FranciscoRos/SolucionesEnergeticasParaWSN/Sistema de control energético.docx

Sistema de control energético

Este proyecto permite monitorear y controlar remotamente parámetros eléctricos como voltaje y corriente mediante una red inalámbrica usando módulos XBee. Un nodo esclavo (Arduino UNO) mide el voltaje con un sensor ZMPT101B y la corriente con un sensor ACS712, y envía estos datos cada 3 segundos a un nodo coordinador (ESP32). El coordinador recibe la información, la analiza y, si los valores están fuea de un rango seguro, envía de vuelta un comando para apagar el sistema mediante un relevador; si todo está bien, lo mantiene encendido. Este proyecto tiene la finalidad de emular el proyecto de Pacheco Zamora (2017) para aumentar la eficiencia energética de este proyecto a futuro

Componentes

Nodo sensor:

Función: Medición de voltaje y corriente, y control del relevador con base en comandos recibidos por XBee.

Componente | Cantidad | Descripción
Arduino nano | 1 | Microcontrolador principal del nodo esclavo
Módulo XBee S2 | 1 | Comunicación inalámbrica con el coordinador
Adaptador XBee a Serial | 1 | Facilita conexión del XBee al Arduino
Sensor de Voltaje ZMPT101B | 1 | Mide el voltaje de AC, conectado a pin A1
Sensor de Corriente ACS712 (30A) | 1 | Mide la corriente, conectado a pin A0
Relevador de 5V | 1 | Controla el encendido/apagado de una carga
Fuente de alimentación 5V/3V | 1 | Alimenta todos los componentes
Cables Dupont | Varios | Para las conexiones
Protoboard | 1 | Para armar el circuito de forma provisional

Nodo Coordinador (ESP32-WROOM-32)

Función: Recibir datos, tomar decisiones y enviar comandos ON/OFF al esclavo.

Componente | Cantidad | Descripción
ESP32-WROOM-32 | 1 | Microcontrolador que evalúa y toma decisiones (ESP DEV MODULE en Arduino IDE)
Módulo XBee | 1 | Para recibir los datos del esclavo
Adaptador XBee a Serial | 1 | Facilita la conexión del XBee al ESP32
Fuente USB (5V/3V) | 1 | Para alimentar al ESP32
Cables Dupont | Varios | Para las conexiones UART (TX/RX) y GND
Protoboard | 1 | Para facilitar conexiones

Conexiones:

Nodo Coordinador:

Pin lado A | Pin lado B | Notas
Adaptador Xbee TX 2(DOUT) | ESP32-WROOM-32 GPIO16 (RX2) | Entrada de datos al ESP32
Adaptador Xbee RX 3 (DIN) | ESP32-WROOM-32 GPIO17 (TX2) | Salida de órdenes desde el ESP32
Adaptador Xbee VCC | Fuente de alimentación 5V | El adaptador aguanta 5v
Adaptador Xbee VCC | GND de Fuente

Nodo Router:

Pin lado A | Pin lado B | Notas
Adaptador Xbee TX (DOUT) | Arduino Nano Pin D2
Adaptador Xbee RX (DIN) | Arduino Nano Pin D3
Adaptador Xbee VCC | Fuente de alimentación 5V
Adaptador Xbee GND | GND de Fuente
ACS712 OUT | Arduino nano Pin A0
ACS712 VCC | Fuente de alimentación 5V
ACS712 GND | GND de Fuente
ZMPT101B OUT | Arduino Nano Pin A1
ZMPT101B VCC | Fuente de alimentación 5V
ZMPT101B GND | GND de Fuente
Relay IN | Arduino Nano Pin D4
Relay VCC | Fuente de alimentación 5V
Relay GND | GND de Fuente

Pruebas de dispositivos físicos:

Nodo Coordinador

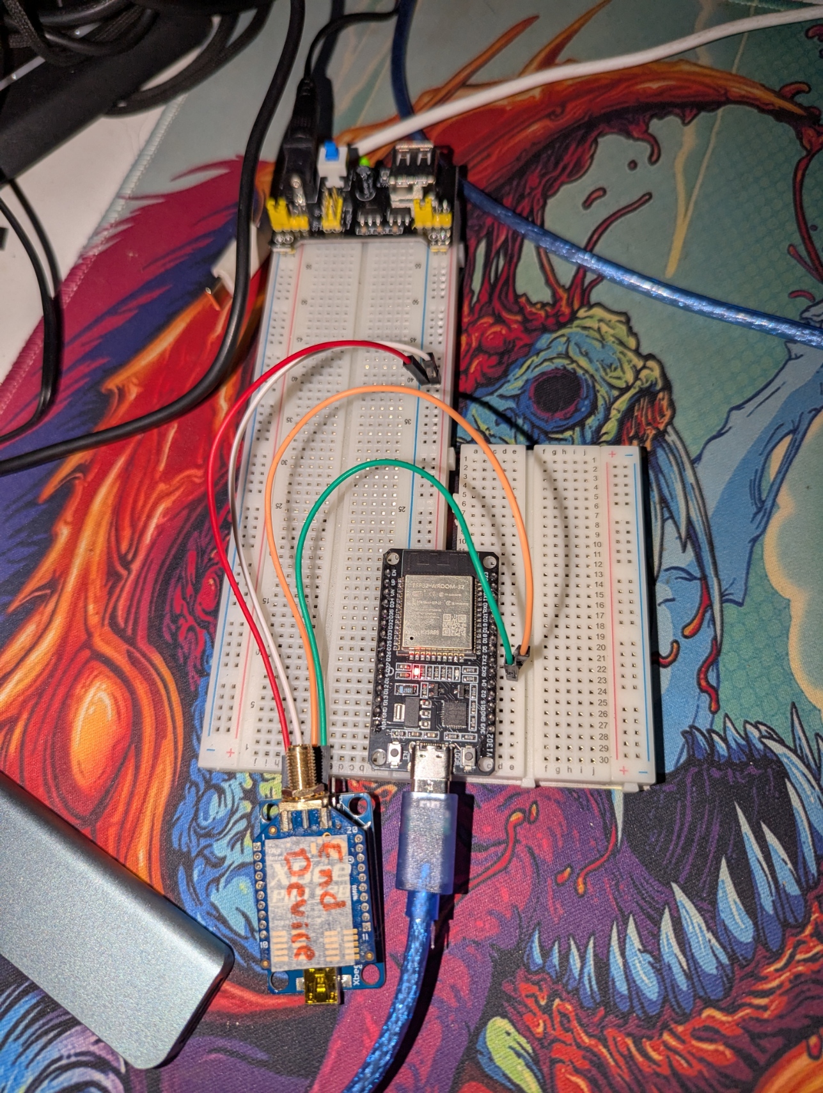
[picture p1: figure]

Nodo Esclavo:

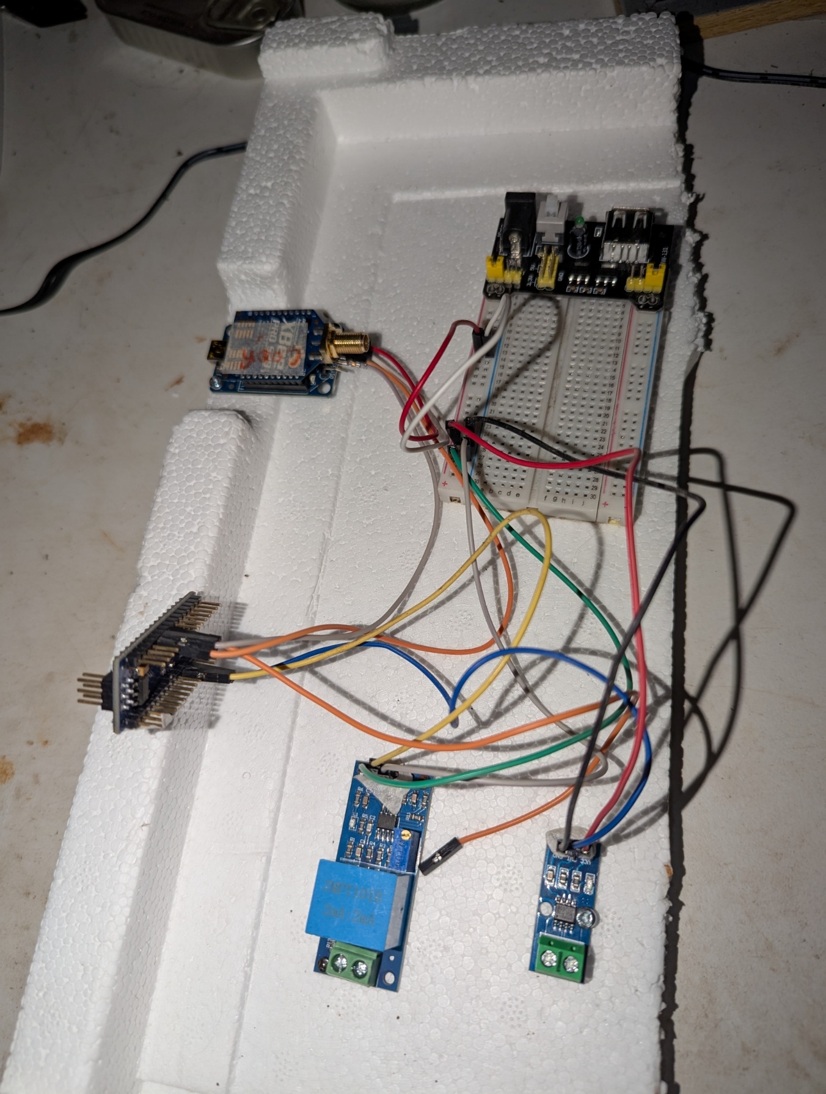
[picture p2: figure]

Código del nodo Coordinador:

// Pines UART2 para ESP32

#define RXD2 16 // Conectado al TX del XBee

#define TXD2 17 // Conectado al RX del XBee

float voltaje = 0.0;

float corriente = 0.0;

void setup() {

Serial.begin(115200); // Comunicación con PC

Serial2.begin(9600, SERIAL_8N1, RXD2, TXD2); // UART2 para XBee

Serial.println("Nodo Coordinador ESP32 iniciado");

}

void loop() {

if (Serial2.available()) {

String data = Serial2.readStringUntil('\n');

data.trim(); // Limpia espacios y saltos

// Validar que sea un paquete válido tipo: V:xx.xx I:yy.yy

if (data.indexOf('V') != -1 && data.indexOf('I') != -1) {

Serial.println("📡 Datos recibidos: " + data);

int idxV = data.indexOf('V');

int idxI = data.indexOf('I');

float v = data.substring(idxV + 2, idxI - 1).toFloat();

float i = data.substring(idxI + 2).toFloat();

voltaje = v;

corriente = i;

Serial.print("🔋 Voltaje: "); Serial.println(voltaje);

Serial.print("⚡ Corriente: "); Serial.println(corriente);

// Lógica de decisión

if (voltaje < 190 || voltaje > 250 || corriente < 0.1) {

Serial2.println("OFF");

Serial.println(">> 📴 Enviando comando: OFF");

} else {

Serial2.println("ON");

Serial.println(">> ✅ Enviando comando: ON");

}

} else {

// Si no es un dato con formato válido, lo ignoramos

}

}

delay(1000); // Espera para evitar saturar la UART

}

Código del nodo Sensor:

#include <SoftwareSerial.h>

SoftwareSerial xbeeSerial(2, 3); // RX, TX para XBee

#define RELAY_PIN 4

#define ACS_PIN A0

#define ZMPT_PIN A1

unsigned long previousMillis = 0;

const long interval = 3000; // cada 3 segundos

void setup() {

pinMode(RELAY_PIN, OUTPUT);

digitalWrite(RELAY_PIN, LOW); // Relevador apagado inicialmente

xbeeSerial.begin(9600);

Serial.begin(9600);

Serial.println("Nodo esclavo listo");

}

void loop() {

unsigned long currentMillis = millis();

if (currentMillis - previousMillis >= interval) {

previousMillis = currentMillis;

float voltage = leerVoltajeZMPT();

float corriente = leerCorrienteACS();

// Envío por XBee

xbeeSerial.print("V:"); xbeeSerial.print(voltage, 2);

xbeeSerial.print(" I:"); xbeeSerial.println(corriente, 2);

Serial.print("📤 Enviado -> V: "); Serial.print(voltage, 2);

Serial.print(" | I: "); Serial.println(corriente, 2);

}

// Escuchar comandos del coordinador

if (xbeeSerial.available()) {

String comando = xbeeSerial.readStringUntil('\n');

comando.trim(); // Elimina espacios

Serial.print("📥 Comando recibido: "); Serial.println(comando);

if (comando == "ON") {

digitalWrite(RELAY_PIN, HIGH);

Serial.println("⚡ Relevador ENCENDIDO");

} else if (comando == "OFF") {

digitalWrite(RELAY_PIN, LOW);

Serial.println("💤 Relevador APAGADO");

} else {

Serial.print("🟡 Comando desconocido: "); Serial.println(comando);

}

}

}

// Lectura simple del ZMPT101B

float leerVoltajeZMPT() {

int lectura = analogRead(ZMPT_PIN);

float voltaje = (lectura * 5.0) / 1023.0;

return voltaje * 50.0; // Aproximación para escalar a voltaje real

}

// Lectura simple del ACS712

float leerCorrienteACS() {

int lectura = analogRead(ACS_PIN);

float voltaje = (lectura * 5.0) / 1023.0;

float corriente = (voltaje - 2.5) / 0.066; // Para ACS712 30A

return corriente;

}

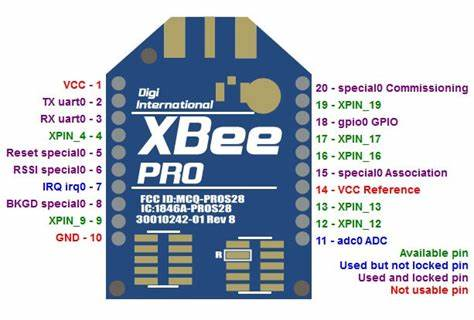
[picture p3: figure]
Xbee Pinout

# CONSUMO ENERGÉTICO ESTIMADO – NODOS

1) PARÁMETROS ELÉCTRICOS USADOS

NODO COORDINADOR

• ESP32-WROOM-32…………… 3.3 V · 20 mA (modo “modem-sleep”) ─→ 0.066 W :contentReference[oaicite:0]{index=0}

• XBee S2 (idle)……………… 3.3 V · 40 mA ─→ 0.132 W :contentReference[oaicite:1]{index=1}

• Adaptador XBee→Serie

– reposo………………… 5 V · 8 mA ─→ 0.040 W :contentReference[oaicite:2]{index=2}

– activo TX…………… 5 V · 10 mA (Δ = +2 mA) ─→ +0.010 W

• Duración paquete TX……… 16 ms cada 3 s → ciclo = 0.005333

NODO SENSOR ( 1 relé de 5 V )

• Arduino Nano (idle)……… 5 V · 20 mA ─→ 0.100 W :contentReference[oaicite:3]{index=3}

• XBee S2 (idle)……………… 3.3 V · 40 mA ─→ 0.132 W :contentReference[oaicite:4]{index=4}

• Adaptador XBee reposo…… 5 V · 8 mA ─→ 0.040 W :contentReference[oaicite:5]{index=5}

• ZMPT101B……………………… 5 V · 2 mA ─→ 0.010 W :contentReference[oaicite:6]{index=6}

• ACS712 (mód.)……………… 5 V · 7 mA ─→ 0.035 W :contentReference[oaicite:7]{index=7}

• Relé 5 V

– bobina OFF………… 5 V · 2 mA ─→ 0.010 W

– bobina ON…………… 5 V · 70 mA (Δ = +68 mA) ─→ +0.340 W :contentReference[oaicite:8]{index=8}

• LM7805 (quiescente)……… 5 V · 8 mA ─→ 0.040 W :contentReference[oaicite:9]{index=9}

• Duración paquete TX……… 16 ms cada 3 s → ciclo = 0.005333

────────────────────────────────────────

2) POTENCIA PROMEDIO CALCULADA

────────────────────────────────────────

NODO COORDINADOR

P_idle = 0.066 W + 0.132 W + 0.040 W = **0.238 W**

P_extra = 0.010 W × 0.005333 = **0.000053 W**

P_avg = 0.238 W + 0.000053 W = **0.238 W**

NODO SENSOR (supuesto: relé ON 100 %)

P_idle = 0.100 W + 0.132 W + 0.040 W + 0.010 W + 0.035 W + 0.010 W + 0.040 W

= **0.707 W**

P_extra = (Δ Arduino 0.150 W + Δ Adaptador 0.010 W) × 0.005333

= **0.001 W**

P_avg = 0.707 W + 0.001 W = **0.708 W**

────────────────────────────────────────

3) ENERGÍA POR DÍA (24 h)

────────────────────────────────────────

E_coord = 0.238 W × 24 h = 5.71 Wh/día

E_sensor = 0.708 W × 24 h = 16.99 Wh/día

4) RESUMEN RÁPIDO

• Nodo coordinador ≈ 5.7 Wh cada 24 h

• Nodo sensor (relé siempre activo) ≈ 17 Wh cada 24 h

Si el relé estuviera activo sólo el 30 % del tiempo:

P_avg_sensor ≈ 0.470 W → 11.28 Wh/día

5) FÓRMULAS USADAS

Potencia: P = V × I

Energía modo_i: E_i = P_i × t_i

Energía total nodo: Σ E_i sobre todos los modos

Duty-cycle TX: d = t_paq / T_envío

A continuación listamos los resultados de diversas mediciones energéticas a lo largo del tiempo

Caso 1: nodo coordinador alimentado por Baterías: 4×18650 (2200 mAh, 14.8 V)

Análisis de autonomía energética

Con baterías hasta vaciar:

Conteo | Paquetes esperados | Paquetes recibidos | % Recepción | Duración nodo
1 | 9300 | 9179 | 98.70 % | 07:45:00
2 | 9260 | 9185 | 99.19 % | 07:43:00
3 | 9280 | 9122 | 98.30 % | 07:44:00
4 | 9240 | 9138 | 98.90 % | 07:42:00
5 | 9320 | 9226 | 98.99 % | 07:46:00
Promedio | 9280 | 9169 | 98.82 % | 07:44:00

Con baterías hasta voltaje seguro (80% de carga útil):

Conteo | Paquetes esperados | Paquetes recibidos | % Recepción | Duración nodo
1 | 11000 | 10571 | 96.10 % | 09:10:00
2 | 10900 | 10431 | 95.70 % | 09:05:00
3 | 10960 | 10576 | 96.50 % | 09:08:00
4 | 10860 | 10414 | 95.89 % | 09:03:00
5 | 10940 | 10535 | 96.30 % | 09:07:00
Promedio | 10932 | 10505 | 96.10 % | 09:06:36

### Notas

- Las pruebas se realizaron en ambiente cálido (34 °C) y con distancia mínima entre módulos XBee
- Los módulos trabajaron en modo API2 a 9600 bps.
- En los casos donde se vaciaron las baterías, el sistema presentó pérdida de paquetes o reinicios al descender por debajo de los 4.4 V
- Se utilizó el mismo set de baterías para cada serie de pruebas, solo se recargaron, pero debido a que eran nuevas no es una diferencia palpable el desgaste entre cargas

Caso 3.

Modificación de códigos para escritura de archivos log:

Código del nodo sensor: #include <SPI.h>

#include <SD.h>

#include <SoftwareSerial.h>

SoftwareSerial xbeeSerial(2, 3); // RX=D2, TX=D3 para XBee

// Pines ya definidos

#define RELAY_PIN 4

#define ACS_PIN A0

#define ZMPT_PIN A1

#define VBAT_PIN A2

const uint8_t SD_CS = 10;

// Variables

unsigned long previousMillis = 0;

const unsigned long INTERVAL_MS = 3000;

unsigned long lastFlush = 0;

const unsigned long FLUSH_MS = 30000;

uint32_t paquetesEnviados = 0;

File logFile;

// Setup

void setup() {

pinMode(RELAY_PIN, OUTPUT);

digitalWrite(RELAY_PIN, LOW);

Serial.begin(9600);

xbeeSerial.begin(9600);

if (!SD.begin(SD_CS)) {

Serial.println("SD no inicializada");

} else {

logFile = SD.open("/llog.txt", FILE_WRITE);

if (logFile) logFile.println("fecha_hora,id_paquete,voltaje_red,corriente,voltaje_bateria");

logFile.flush();

}

}

// Loop

void loop() {

unsigned long currentMillis = millis();

if (currentMillis - previousMillis >= INTERVAL_MS) {

previousMillis = currentMillis;

float voltage = leerVoltajeZMPT();

float corriente = leerCorrienteACS();

float vbat = leerVoltajeBateria();

paquetesEnviados++;

// Línea CSV

String fecha_hora = obtenerFechaHora();

String linea = fecha_hora + "," + String(paquetesEnviados) + "," +

String(voltage, 2) + "," + String(corriente, 2) + "," +

String(vbat, 2);

// Envío por XBee

xbeeSerial.print("N:"); xbeeSerial.print(paquetesEnviados);

xbeeSerial.print(" V:"); xbeeSerial.print(voltage, 2);

xbeeSerial.print(" I:"); xbeeSerial.print(corriente, 2);

xbeeSerial.print(" B:"); xbeeSerial.println(vbat, 2);

// Serial y SD

Serial.println(linea);

if (logFile) logFile.println(linea);

}

// Comandos recibidos

if (xbeeSerial.available()) {

String comando = xbeeSerial.readStringUntil('\n');

comando.trim();

if (comando == "ON") digitalWrite(RELAY_PIN, HIGH);

else if (comando == "OFF") digitalWrite(RELAY_PIN, LOW);

}

if (logFile && millis() - lastFlush >= FLUSH_MS) {

logFile.flush();

lastFlush = millis();

}

}

// Funciones sensores existentes

float leerVoltajeZMPT() {

int lectura = analogRead(ZMPT_PIN);

return ((lectura * 5.0) / 1023.0) * 50.0;

}

float leerCorrienteACS() {

int lectura = analogRead(ACS_PIN);

float volt = (lectura * 5.0) / 1023.0;

return (volt - 2.5) / 0.066;

}

float leerVoltajeBateria() {

int lectura = analogRead(VBAT_PIN);

float vEsc = (lectura * 5.0) / 1023.0;

return vEsc * 3.0;

}

// Fecha/hora calculada desde millis

String obtenerFechaHora() {

unsigned long segundos = millis() / 1000;

int hh = 12 + (segundos / 3600) % 12;

int mm = (segundos / 60) % 60;

int ss = segundos % 60;

char buf[20];

sprintf(buf, "2025-06-05 %02d:%02d:%02d", hh, mm, ss);

return String(buf);

}

Pines actualizados del nodo sensor:

Pin del Arduino Nano | Dispositivo conectado | Función
D2 | XBee (DOUT) | RX (SoftwareSerial)
D3 | XBee (DIN) | TX (SoftwareSerial)
D4 | Relé | Control (ON/OFF)
D10 | Módulo micro-SD (CS) | Chip Select SPI
D11 (MOSI) | Módulo micro-SD (DI) | SPI MOSI
D12 (MISO) | Módulo micro-SD (DO) | SPI MISO
D13 (SCK) | Módulo micro-SD (SCK) | SPI Clock
A0 | ACS712 (sensor corriente) | Lectura corriente analógica
A1 | ZMPT101B (sensor voltaje) | Lectura voltaje analógico
A2 | Batería (divisor resistivo) | Lectura voltaje de batería
5V | Fuente alimentación | Alimentación módulos (XBee, sensores, relé, SD)
GND | Fuente común | Tierra común módulos

Código actualizado del Nodo Coordinador:

#include <SPI.h>

#include <SD.h>

// UART para XBee

#define RXD2 16

#define TXD2 17

const uint8_t SD_CS = 5;

// Pin ADC para batería

const uint8_t BAT_PIN = 34;

File logFile;

unsigned long lastFlush = 0;

const unsigned long FLUSH_MS = 30000;

uint32_t paquetesRecibidos = 0;

void setup() {

Serial.begin(115200);

Serial2.begin(9600, SERIAL_8N1, RXD2, TXD2);

if (!SD.begin(SD_CS)) {

Serial.println("SD no inicializada");

} else {

logFile = SD.open("/clog.txt", FILE_WRITE);

if (logFile) {

logFile.println("fecha_hora,id_paquete,id_nodo,RSSI,estado,voltaje_bateria");

logFile.flush();

}

}

}

void loop() {

if (Serial2.available()) {

String data = Serial2.readStringUntil('\n');

data.trim();

if (data.startsWith("N:")) {

paquetesRecibidos++;

int idStart = data.indexOf("N:") + 2;

int idEnd = data.indexOf(' ', idStart);

String id_paquete = data.substring(idStart, idEnd);

String fecha_hora = obtenerFechaHora();

int rssi = -1;

float voltaje_bateria = leerVoltajeBateria();

String linea = fecha_hora + "," + id_paquete + ",SENSOR1," +

String(rssi) + ",OK," + String(voltaje_bateria, 2);

Serial.println(linea);

if (logFile) logFile.println(linea);

Serial2.println("ON");

}

}

if (logFile && millis() - lastFlush >= FLUSH_MS) {

logFile.flush();

lastFlush = millis();

}

}

// Medición batería (ADC ESP32: 0 - 4095 → 0 - 3.3V)

float leerVoltajeBateria() {

int lecturaADC = analogRead(BAT_PIN);

float voltajeADC = (lecturaADC / 4095.0) * 3.3;

float voltajeBateria = voltajeADC * ((10000.0 + 5000.0) / 5000.0); // Divisor 10k-5k

return voltajeBateria;

}

String obtenerFechaHora() {

unsigned long segundos = millis() / 1000;

int hh = 12 + (segundos / 3600) % 12;

int mm = (segundos / 60) % 60;

int ss = segundos % 60;

char buf[20];

sprintf(buf, "2025-06-03 %02d:%02d:%02d", hh, mm, ss);

return String(buf);

}

Pines actualizados del nodo coordinador:

Pin ESP32 | Dispositivo conectado | Función
GPIO16 (RX2) | XBee (DOUT) | UART RX desde XBee
GPIO17 (TX2) | XBee (DIN) | UART TX hacia XBee
GPIO5 | Módulo micro-SD (CS) | Chip Select SPI SD
GPIO18 (SCK) | Módulo micro-SD (SCK) | SPI Clock
GPIO19 (MISO) | Módulo micro-SD (MISO) | SPI MISO
GPIO23 (MOSI) | Módulo micro-SD (MOSI) | SPI MOSI
GPIO34 | Divisor resistivo | Medición voltaje batería (ADC)
VIN (5V) | Fuente USB (5V) o batería | Alimentación ESP32 y módulos
GND | Fuente común | Tierra común

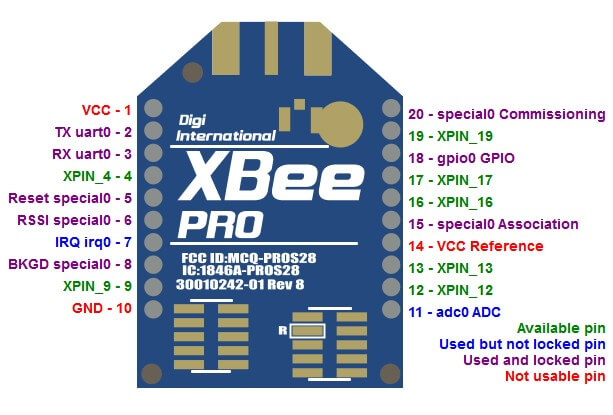
[picture p4: figure]
Xbee Pinout

Pruebas de código en MODO AT V.2

Código en Nodo Coordinador

#include <SPI.h>

#include <SD.h>

#define RXD2 16

#define TXD2 17

const uint8_t SD_CS = 5;

File logFile;

unsigned long lastFlush = 0;

const unsigned long FLUSH_MS = 30000;

uint32_t paquetesRecibidos = 0;

void setup() {

Serial.begin(115200);

Serial2.begin(9600, SERIAL_8N1, RXD2, TXD2);

if (!SD.begin(SD_CS)) {

Serial.println("SD no inicializada");

} else {

logFile = SD.open("/clog.csv", FILE_WRITE);

if (logFile) logFile.println("fecha_hora,id_paquete,id_nodo,voltaje,corriente,voltaje_bateria,estado");

logFile.flush();

}

}

void loop() {

if (Serial2.available()) {

String data = Serial2.readStringUntil('\n');

data.trim();

// Formato esperado: NombreNodo|N:id_paquete V:voltaje I:corriente B:bateria

int sep = data.indexOf('|');

String id_nodo = "UNKNOWN";

String resto = data;

if (sep > 0) {

id_nodo = data.substring(0, sep);

id_nodo.trim();

resto = data.substring(sep + 1);

}

int idStart = resto.indexOf("N:") + 2;

int idEnd = resto.indexOf(' ', idStart);

String id_paquete = resto.substring(idStart, idEnd);

int vStart = resto.indexOf("V:") + 2;

int vEnd = resto.indexOf(' ', vStart);

String voltaje = resto.substring(vStart, vEnd);

int iStart = resto.indexOf("I:") + 2;

int iEnd = resto.indexOf(' ', iStart);

String corriente = resto.substring(iStart, iEnd);

int bStart = resto.indexOf("B:") + 2;

String vbat = resto.substring(bStart);

String fecha_hora = obtenerFechaHora();

String linea = fecha_hora + "," + id_paquete + "," + id_nodo + "," +

voltaje + "," + corriente + "," + vbat + ",OK";

Serial.println(linea);

if (logFile) logFile.println(linea);

paquetesRecibidos++;

}

if (logFile && millis() - lastFlush >= FLUSH_MS) {

logFile.flush();

lastFlush = millis();

}

}

String obtenerFechaHora() {

unsigned long segundos = millis() / 1000;

int hh = 12 + (segundos / 3600) % 12;

int mm = (segundos / 60) % 60;

int ss = segundos % 60;

char buf[20];

sprintf(buf, "2025-06-03 %02d:%02d:%02d", hh, mm, ss);

return String(buf);

}

Código Nodo Esclavo:

#include <SPI.h>

#include <SD.h>

#include <SoftwareSerial.h>

SoftwareSerial xbeeSerial(2, 3);

#define RELAY_PIN 4

#define ACS_PIN A0

#define ZMPT_PIN A1

#define VBAT_PIN A2

const uint8_t SD_CS = 10;

unsigned long previousMillis = 0;

const unsigned long INTERVAL_MS = 3000;

File logFile;

uint32_t paquetesEnviados = 0;

void setup() {

pinMode(RELAY_PIN, OUTPUT);

digitalWrite(RELAY_PIN, LOW);

Serial.begin(9600);

xbeeSerial.begin(9600);

if (!SD.begin(SD_CS)) {

Serial.println("SD no inicializada");

} else {

logFile = SD.open("/llog1.csv", FILE_WRITE);

if (logFile) logFile.println("fecha_hora,id_paquete,voltaje,corriente,voltaje_bateria");

logFile.flush();

}

}

void loop() {

unsigned long currentMillis = millis();

if (currentMillis - previousMillis >= INTERVAL_MS) {

previousMillis = currentMillis;

paquetesEnviados++;

float voltage = leerVoltajeZMPT();

float corriente = leerCorrienteACS();

float vbat = leerVoltajeBateria();

String fecha_hora = obtenerFechaHora();

String linea = fecha_hora + "," + String(paquetesEnviados) + "," +

String(voltage, 2) + "," + String(corriente, 2) + "," +

String(vbat, 2);

// Enviar con delimitador '|'

xbeeSerial.print("Nodo1|");

xbeeSerial.print("N:"); xbeeSerial.print(paquetesEnviados);

xbeeSerial.print(" V:"); xbeeSerial.print(voltage, 2);

xbeeSerial.print(" I:"); xbeeSerial.print(corriente, 2);

xbeeSerial.print(" B:"); xbeeSerial.println(vbat, 2);

Serial.println(linea);

if (logFile) logFile.println(linea);

}

}

// Funciones sensores

float leerVoltajeZMPT() { return analogRead(ZMPT_PIN) * 5.0 / 1023.0 * 50.0; }

float leerCorrienteACS() { return ((analogRead(ACS_PIN) * 5.0 / 1023.0) - 2.5) / 0.066; }

float leerVoltajeBateria() { return analogRead(VBAT_PIN) * 5.0 / 1023.0 * 3.0; }

String obtenerFechaHora() {

unsigned long segundos = millis() / 1000;

int hh = 12 + (segundos / 3600) % 12;

int mm = (segundos / 60) % 60;

int ss = segundos % 60;

char buf[20];

sprintf(buf, "2025-06-03 %02d:%02d:%02d", hh, mm, ss);

return String(buf);

}

PARA EL USO DE LA LIBRERÍA DE EnergyWSN SE NECESITA ACTUALIZAR EL HARDWARE PARA IMPLEMENTAR:

MOSFET P PARA EL CANAL DE LA ALIMENTACIÓN DE LOS SENSORES

PINES PARA ENCENDIDO DEL XBEE Y ESTADO DEL XBEE

LA TABLA DE CONEXIONES QUEDA DE ESTA MANERA:

Pin Arduino Nano | Dispositivo conectado | Función | Notas
D2 | XBee DOUT | RX (SoftwareSerial) | 3.3 V → entra directo al Nano.
D3 | XBee DIN | TX (SoftwareSerial) | Requiere divisor resistivo/level shifter.
D4 | Relé | Control ON/OFF | Driver recomendado (transistor + diodo).
D7 | MOSFET control sens. | ON/OFF sensores | Controla P-MOSFET vía NPN.
D8 | XBee SLEEP_RQ | Orden de dormir/despertar | Usa divisor resistivo.
D9 | XBee ON/SLEEP | Bandera de estado (input) | 3.3 V, lectura directa.
D10 | Módulo micro-SD (CS) | SPI CS
D11 (MOSI) | Módulo micro-SD (DI) | SPI MOSI
D12 (MISO) | Módulo micro-SD (DO) | SPI MISO
D13 (SCK) | Módulo micro-SD (SCK) | SPI Clock
A0 | ACS712 | Lectura corriente analógica
A1 | ZMPT101B | Lectura voltaje analógico
A2 | Divisor resistivo | Lectura voltaje batería
5V | Fuente step-down | Alimentación módulos 5 V | Desde el step down
3.3V (LDO) | XBee | Alimentación 3.3 V | Desde adaptador 3.3 del stepdown
GND | Común | Tierra común

AGREGANDO EL MÓDULO RTC A LOS DIAGRAMAS DE CONEXIÓN.

Nodo Sensor

Pin del Arduino Nano | Dispositivo Conectado | Conexión de Alimentación
Batería (14.8V) | Step-Down de 5V y Step-Down de 3.3V | Ambos se conectan a los polos positivo (+) y negativo (-) de la batería.
Salida 5V Step-Down | Arduino Nano, Relé, Sensores, Módulo SD | Alimentación principal.
Salida 3.3V Step-Down | XBee | Alimentación dedicada para el XBee.
A4 (SDA) | RTC (D) | Comunicación de datos I2C.
A5 (SCL) | RTC (C) | Comunicación de reloj I2C.
VCC (5V) | RTC (+) | Alimentación para el RTC desde la salida de 5V del Step-Down.
GND | RTC (-) | Tierra común.
D2 | XBee (DOUT) | UART (RX)
D3 | XBee (DIN) | UART (TX)
D4 | Relé | Control (ON/OFF)
A0 | ACS712 (sensor corriente) | Lectura analógica
A1 | ZMPT101B (sensor voltaje) | Lectura analógica
A2 | Batería (divisor resistivo) | Lectura de voltaje

Nodo sensor

Metodología de Pruebas y Evaluación de Rendimiento de la Red de Nodos

Para la validación experimental y la cuantificación del rendimiento de la red de sensores implementada, se diseñó un protocolo de pruebas dividido en dos fases críticas. Cada fase se enfoca en una métrica fundamental para el desempeño y la viabilidad del sistema: la confiabilidad en la transmisión de datos y el consumo energético de los nodos. El objetivo de esta separación es permitir un análisis granular y preciso de cada aspecto funcional.

#### 1. Evaluación de la Confiabilidad y Tasa de Entrega de Paquetes (Packet Delivery Rate)

Esta primera fase del protocolo experimental se centró en determinar la integridad y robustez de la comunicación inalámbrica entre los nodos sensor y el nodo coordinador. El objetivo principal era cuantificar la Tasa de Pérdida de Paquetes (Packet Loss Rate, PLR) en un escenario de operación autónoma y prolongada, simulando así condiciones de despliegue reales.

Procedimiento Experimental:

El procedimiento se ejecutó de la siguiente manera:

1. Configuración Inicial: Se programaron y energizaron un nodo sensor y un nodo coordinador, ambos con sus baterías completamente cargadas. Los nodos se configuraron para operar de forma totalmente autónoma, sin intervención humana, transmitiendo datos a intervalos predefinidos.
2. Periodo de Operación Autónoma: Los nodos se dejaron en funcionamiento ininterrumpido durante un ciclo completo de descarga, es decir, hasta que la fuente de energía del nodo sensor se agotó por completo. Este método asegura que la prueba cubra todas las posibles variaciones en el rendimiento del hardware a medida que el voltaje de la batería disminuye, lo cual puede afectar la potencia de transmisión del módulo de radiofrecuencia.
3. Recolección de Datos: Una vez finalizado el ciclo de vida útil de la batería, ambos nodos fueron conectados a un ordenador a través de la interfaz serie. Se utilizó el monitor serial del Entorno de Desarrollo Integrado (IDE) de Arduino para extraer los registros de operación almacenados en la memoria o contadores internos de cada dispositivo.
  a. Del nodo sensor, se obtuvo el número total de paquetes de datos que fueron exitosamente generados y enviados (P_enviados).
  b. Del nodo coordinador, se recuperó el número total de paquetes que fueron recibidos y procesados correctamente (P_recibidos).
4. Análisis de Resultados: Con los datos recolectados, se procedió a calcular el número absoluto de paquetes perdidos durante la transmisión. Esta métrica representa la cantidad de información que no logró llegar a su destino debido a factores como interferencia, colisiones de señal, o limitaciones de alcance. El cálculo se realizó mediante una simple diferencia aritmética:

P_(perdidos) = P_(enviados) - P_(recibidos)

Posteriormente, para normalizar este valor y obtener un indicador de rendimiento porcentual, se calculó la Tasa de Pérdida de Paquetes (PLR). Esta tasa es fundamental para evaluar la calidad del enlace de comunicación y se define mediante la siguiente fórmula:

Porcentaje de pérdida (%) = ((P_(recibidos))/(P_(enviados)))⋅100

La ejecución de esta prueba en un ciclo de vida completo de la batería proporciona una visión integral y realista de la confiabilidad del sistema, permitiendo evaluar su idoneidad para aplicaciones donde la integridad de los datos es crítica. Los resultados obtenidos a partir de este cálculo son un indicador clave del rendimiento general de la red.

### Metodología y Análisis Comparativo de Rendimiento de Protocolos de Comunicación

Para evaluar la eficiencia y fiabilidad de la red de sensores inalámbricos, se ejecutaron cuatro escenarios de prueba secuenciales. Cada escenario implementó un nivel incremental de complejidad en el protocolo de comunicación, permitiendo un análisis detallado del impacto de diferentes técnicas de transmisión de datos. Para garantizar una comparación equitativa, los resultados de todas las pruebas se normalizaron a un periodo de operación estandarizado de una hora.

#### 1. Escenario Base: Transmisión Directa de Datos

El primer escenario sirvió como punto de referencia para establecer el rendimiento base de la comunicación inalámbrica. En esta prueba, se utilizó un firmware con una lógica de transmisión fundamental, sin capas de encapsulación o codificación avanzadas. El nodo sensor fue programado para enviar una estructura de datos simple que contenía: ID de paquete, medición de voltaje, medición de corriente, voltaje de la batería y un timestamp en formato Unix.

Metodología y Proyección de Resultados:

La prueba se condujo inicialmente por un periodo de 1 hora asumiendo una tasa de transmisión y pérdida constante.

Resultados (1 hora):

- Paquetes Enviados: 1800
- Paquetes Recibidos: 1692
- Paquetes Perdidos: 1800 – 1692 = 108

El análisis de esta prueba base revela una tasa de pérdida de paquetes moderada, que sirve como nuestro control experimental.

Porcentajde de pérdia = (108/1800)⋅100 = 6.0%

#### 2. Escenario con Protocolo de Comunicación Avanzado

En la segunda fase, se implementó un firmware más robusto que introducía un mecanismo de encapsulación de datos. La característica principal de este protocolo fue la inclusión de una palabra de sincronización (syncword), una secuencia de bits predefinida que permite al receptor validar la autenticidad y el inicio de cada trama de datos, mejorando la distinción entre señales válidas y ruido de fondo.

Resultados (Periodo de 1 hora):

- Paquetes Enviados: 1,392
- Paquetes Recibidos: 1337.55 ≈ 1,338
- Paquetes Perdidos: 1392 – 1337.55 = 54.54 ≈ 54

La implementación de este protocolo demostró una mejora significativa en la fiabilidad de la comunicación, reduciendo la tasa de pérdida considerablemente en comparación con el escenario base.

Porcentajde de pérdia = (54/1392)⋅100 ≈3.91%

#### 3. Escenario con Codificación Binaria de Datos

El tercer y último escenario evaluó el efecto de una optimización adicional: la codificación binaria. Se integró una librería de desarrollo propio para convertir la estructura de datos a un formato binario compacto antes de la transmisión. Teóricamente, esta técnica debería reducir el tamaño del paquete y, por ende, el tiempo de transmisión, minimizando la probabilidad de colisiones. El nodo receptor utilizaba la misma librería para decodificar el mensaje a su formato original.

Metodología y Proyección de Resultados:

La prueba se ejecutó durante 1 hora y sus resultados fueron, de igual manera, mediante una tasa de transmisión y recepción consante:

Resultados (Periodo de 1 hora):

- Paquetes Enviados: 1305
- Paquetes recibidos: 665
- Paquetes Perdidos: 1305 – 665 = 640

Contrario a las expectativas teóricas, esta implementación resultó en un drástico deterioro del rendimiento de la red.

Porcentajde de pérdia = (640/1392)⋅100 ≈49.04%

### 4. Estrategia de Transmisión Adaptativa Basada en el Nivel de Batería

En el cuarto y último escenario de prueba, se implementó la funcionalidad más avanzada del sistema: una estrategia de transmisión adaptativa. Para ello, se integró una librería de desarrollo propio que ajusta dinámicamente el comportamiento del nodo sensor en función del porcentaje de vida útil restante de la batería. El objetivo de esta optimización es maximizar la longevidad del nodo gestionando de forma inteligente los recursos energéticos.

Metodología:

Durante una hora de operación, el nodo sensor transmitió un paquete de datos enriquecido que incluía:

- ID de paquete.
- Timestamp de la medición.
- Voltaje de la batería.
- Corriente de consumo.
- Potencia calculada.
- Estado de energía: Un nuevo campo categórico (Bajo, Medio, Alto) derivado del nivel de la batería.

Resultados (Periodo de 1 hora):

Esta implementación no solo demostró ser viable, sino que también alcanzó el rendimiento de comunicación más alto de todos los escenarios probados. El análisis de los datos recolectados arrojó los siguientes resultados:

- Paquetes Enviados: 1,438
- Paquetes Recibidos: 1339.46 ≈ 1339
- Paquetes Perdidos: 38.54 ≈ 38

El cálculo de la tasa de pérdida de paquetes confirma una conexión sumamente fiable, logrando el porcentaje de error más bajo de toda la fase experimental.

Porcentaje de pérdida = (38/1438)⋅100 ≈ 2.68%

Este resultado sugiere que la lógica de gestión de energía no interfiere negativamente con la transmisión de radiofrecuencia y, por el contrario, opera dentro de un marco que permite una comunicación de datos robusta y eficiente.

Conclusión Comparativa: Los resultados indican que, si bien la encapsulación de datos con una syncword es una estrategia altamente efectiva para mejorar la fiabilidad, la implementación actual de la librería de codificación binaria introduce una sobrecarga de procesamiento o errores que impactan negativamente en la integridad de la transmisión, haciéndola inviable en su estado actual.

NRF24L01

Como parte de la evaluación comparativa entre distintos protocolos de comunicación inalámbrica, se seleccionó el transceptor nRF24L01. El propósito de esta sección es detallar la metodología y la configuración experimental empleada para analizar sus métricas de rendimiento clave, específicamente: su rango operativo, la fiabilidad en la transmisión y recepción de datos, y su consumo energético.

#### Descripción del Módulo nRF24L01

El nRF24L01 es un módulo transceptor de radiofrecuencia (RF) de ultra bajo consumo (ULP) y alto rendimiento, diseñado por Nordic Semiconductor. Opera en la banda ISM (Industrial, Científica y Médica) de 2.4 GHz, la cual es de uso libre a nivel mundial. Su comunicación con microcontroladores se realiza a través del protocolo SPI (Serial Peripheral Interface), lo que facilita su integración en una amplia gama de proyectos de electrónica embebida. Entre sus características destacan una velocidad de datos configurable (250 kbps, 1 Mbps y 2 Mbps) y un manejo eficiente de la energía, lo que lo hace ideal para aplicaciones alimentadas por baterías.

### Configuración de Hardware y Conexiones

Para la implementación del enlace de comunicación, se establecieron dos nodos principales: un Nodo Emisor (Sensor) encargado de transmitir datos y un Nodo Coordinador encargado de recibirlos.

La conexión física del módulo nRF24L01 a los microcontroladores se simplificó mediante el uso de un adaptador específico. Este componente cumple dos funciones críticas:

1. Facilitar el Pinout: Proporciona un conjunto de pines de conexión estándar (2.54 mm) más manejables que los del módulo nativo.
2. Regulación de Voltaje: Integra un regulador que permite alimentar el adaptador con 5V (un voltaje común en placas como Arduino), entregando de forma segura los 3.3V que requiere el nRF24L01 para su operación, evitando así daños en el módulo.

A continuación, se detalla el esquema de conexiones para cada nodo.

Nodo Emisor (Sensor)

Pin nRF24L01 | Pin Arduino Nano | Descripción
GND | GND | Tierra
VCC | 3.3V | Alimentación de 3.3 Volts
CE | D9 | Chip Enable (Configurable)
CSN | D10 | Chip Select Not (Configurable)
SCK | D13 | Serial Clock (SPI)
MOSI | D11 | Master Out Slave In (SPI)
MISO | D12 | Master In Slave Out (SPI)
IRQ | N/A | Interrupt Request

Este nodo se compone de un microcontrolador ESP32 y un módulo nRF24L01, seleccionado por su mayor capacidad de procesamiento y conectividad.

Nodo Coordinador

Pin nRF24L01 | Pin ESP32 | Descripción
GND | GND | Tierra
VCC | 3.3V | Alimentación de 3.3 Volts
CE | D4 | Chip Enable (Configurable)
CSN | D5 | Chip Select Not (Configurable)
SCK | D18 | Serial Clock (SPI)
MOSI | D23 | Master Out Slave In (SPI)
MISO | D19 | Master In Slave Out (SPI)
IRQ | (No se conecta) | Interrupt Request

Implementación de Firmware para Comunicación Básica

Para establecer un enlace de comunicación funcional entre los nodos, se desarrolló un firmware base utilizando el entorno de desarrollo de Arduino y la librería RF24 de TMRh20, una de las más robustas para el manejo de estos módulos. A continuación, se presentan los códigos fuente para el emisor y el receptor.

Nodo Sensor V1 (Emisor - Arduino Nano)

#include <SPI.h>

#include <nRF24L01.h>

#include <RF24.h>

// Configuración de los pines CE y CSN para el Nano

RF24 radio(9, 10); // CE, CSN

// Dirección del "pipe" o tubería por donde se comunicarán. Debe ser la misma en ambos nodos.

const byte address[6] = "00001";

void setup() {

Serial.begin(9600);

Serial.println("Nodo Emisor");

radio.begin();

radio.printDetails();

radio.setChannel(108);

radio.setDataRate(RF24_250KBPS);

// Configura el pipe para la escritura (transmisión)

radio.openWritingPipe(address);

// Establece el nivel de potencia al mínimo para pruebas cercanas.

// Puedes usar RF24_PA_MAX para mayor alcance.

radio.setPALevel(RF24_PA_MIN);

// Detiene la escucha para prepararse a enviar datos

radio.stopListening();

}

void loop() {

const char text[] = "Hola Mundo!";

bool ok = radio.write(&text, sizeof(text));

if (ok) {

Serial.println("Mensaje enviado con éxito.");

} else {

Serial.println("Fallo al enviar el mensaje.");

}

delay(1000);

}

Nodo Coordinador V1 (Receptor - ESP32)

#include <SPI.h>

#include <nRF24L01.h>

#include <RF24.h>

// Configuración de los pines CE y CSN para el ESP32

RF24 radio(4, 5); // CE, CSN

// Dirección del pipe. Debe ser la misma que en el emisor.

const byte address[6] = "00001";

void setup() {

Serial.begin(115200);

while (!Serial);

Serial.println("Nodo Receptor ESP32 Iniciado");

radio.begin();

radio.printDetails();

radio.setChannel(108);

radio.setDataRate(RF24_250KBPS);

radio.openReadingPipe(0, address);

radio.setPALevel(RF24_PA_MIN);

radio.startListening();

Serial.println("Escuchando mensajes...");

}

void loop() {

// Comprueba si hay datos disponibles para leer

if (radio.available()) {

char text[32] = ""; // Crea un buffer para almacenar el texto recibido

radio.read(&text, sizeof(text));

Serial.print("Mensaje recibido: ");

Serial.println(text);

}

}

### Estrategias de Gestión de Energía del nRF24L01

Una de las características más destacadas del transceptor nRF24L01 es su diseño orientado a aplicaciones de ultra bajo consumo (ULP), fundamental para dispositivos alimentados por batería. El módulo incorpora dos modos principales de ahorro de energía que pueden ser controlados por software para optimizar la longevidad del sistema.

#### 1. Modo de Apagado Total (Power Down)

Este modo representa el estado de más bajo consumo del módulo. Cuando se activa, la mayoría de los circuitos internos se desactivan, logrando un consumo de corriente residual de aproximadamente 900 nA.

- Activación: Se controla mediante software a través de los comandos de la librería RF24, específicamente radio.powerDown() para entrar en este estado y radio.powerUp() para salir de él.
- Consideración Clave: Si bien este modo ofrece el máximo ahorro de energía, tiene una latencia de reactivación. Al salir del estado Power Down, el módulo requiere un tiempo de estabilización de 1.5 milisegundos (ms) para que sus osciladores internos se calibren correctamente. Es crucial respetar este tiempo de espera antes de intentar una transmisión para evitar el envío de paquetes de datos corruptos o incompletos.

#### 2. Modo de Espera Rápida (Standby-I)

El modo Standby-I es un estado de reposo intermedio que ofrece un equilibrio entre el ahorro de energía y la velocidad de respuesta. En este estado, los osciladores principales del módulo se mantienen activos, resultando en un consumo de aproximadamente 26 µA.

- Activación: Este es el estado por defecto en el que se encuentra el módulo inmediatamente después de ser inicializado con radio.begin() o radio.powerUp(). También transita a este modo cuando se detiene la escucha activa mediante radio.stopListening().
- Ventaja Principal: Su principal beneficio es la transición casi instantánea a los modos de transmisión (TX) o recepción (RX), que toma solo 130 microsegundos (µs). Esto lo hace ideal para aplicaciones que requieren una respuesta rápida a eventos externos sin incurrir en la latencia del modo Power Down.

### Aplicación Práctica: Protocolo de Comunicación Bidireccional con Gestión de Energía

Aprovechando la flexibilidad de estos modos de bajo consumo, se implementó un protocolo de comunicación bidireccional diseñado para ser robusto y energéticamente eficiente. Esta estrategia permite no solo la transmisión de datos del sensor al coordinador, sino también la verificación periódica del estado del nodo sensor (un mecanismo de heartbeat o "pulso de vida").

El flujo de operación es el siguiente:

1. Transmisión del Sensor: El nodo sensor se activa, transmite su paquete de datos y, para maximizar la vida de su batería, entra inmediatamente en el modo Power Down.
2. Recepción del Coordinador: El nodo coordinador, que se encuentra en modo de escucha, recibe los datos. Tras una recepción exitosa, inicia un temporizador de espera (por ejemplo, 5 segundos).
3. Mecanismo de Verificación (Ping): Si el coordinador no recibe un nuevo mensaje del sensor dentro del tiempo establecido, asume que podría haber un problema. En ese momento:
  a. El coordinador cambia su rol de receptor a emisor.
  b. Envía un mensaje de "ping" o solicitud de estado a la dirección del nodo sensor.
  c. Este mecanismo permite al sistema central verificar si el nodo sensor sigue activo y en rango, incluso cuando este se encuentra en estado de reposo profundo la mayor parte del tiempo.

Esta combinación inteligente de los modos de ahorro de energía permite que los nodos remotos operen durante períodos prolongados con una sola carga de batería, mientras se mantiene la capacidad de supervisar la salud y conectividad de la red.

### Implementación de Persistencia de Datos y Sincronización Temporal

Para mejorar el sistema de una simple red de transmisión en tiempo real a una plataforma de adquisición de datos robusta, se integraron dos componentes de hardware cruciales: una memoria EEPROM (Electrically Erasable Programmable Read-Only Memory) y un RTC (Real-Time Clock). El objetivo de esta mejora fue dotar a los nodos de la capacidad de almacenar datos de forma persistente y de contextualizar cada evento con una marca de tiempo precisa.

#### 1. Almacenamiento Persistente con Memoria EEPROM

La volatilidad de la memoria RAM de los microcontroladores presenta una limitación significativa para el análisis a largo plazo, ya que cualquier reinicio del sistema o pérdida de energía borra todos los datos de operación, como los contadores de paquetes. Para superar este obstáculo, se implementó una memoria EEPROM en los nodos.

Propósito y Funcionamiento: La función principal de la EEPROM es proporcionar almacenamiento no volátil. En esta implementación, se utilizó para guardar información crítica del último mensaje gestionado por el nodo, como el ID del paquete o el conteo total de paquetes enviados/recibidos.

Al registrar estos valores en la EEPROM, el estado de la comunicación se preserva incluso si el nodo se apaga o se reinicia. Al volver a encenderse, el nodo puede leer el último estado guardado y continuar su operación sin perder la secuencia. Esto es fundamental para realizar un análisis post-operativo preciso de la fiabilidad de la red, permitiendo calcular con exactitud la tasa de envío y recepción de paquetes a lo largo de ciclos de energía completos.

#### 2. Contexto Temporal con un Módulo RTC (Real-Time Clock)

Si bien los temporizadores internos de los microcontroladores (como la función millis()) son útiles para medir intervalos cortos, no son adecuados para registrar la hora y fecha de eventos en el mundo real, ya que se reinician con el dispositivo y pueden tener desviaciones significativas con el tiempo.

Propósito y Funcionamiento: Para solucionar esto, se integró un módulo RTC, como el DS3231. Este dispositivo es un reloj de alta precisión, respaldado por su propia batería tipo moneda, que mantiene la hora, fecha y día de la semana de forma continua e independiente del estado del microcontrolador principal.

La implementación del RTC en el nodo coordinador permite que cada vez que se recibe un paquete de datos, este sea estampado con la fecha y hora exactas de su llegada. Esta capacidad es invaluable para:

- Analizar patrones temporales: Permite identificar a qué horas del día se producen más pérdidas de paquetes, lo que puede estar relacionado con interferencias externas.
- Diagnosticar fallos: Si un nodo sensor deja de transmitir, el timestamp del último mensaje recibido indica con precisión cuándo ocurrió el fallo.
- Sincronizar datos: Asegura que todos los datos recolectados tengan un contexto temporal coherente y fiable para su posterior análisis y visualización.

En conjunto, la EEPROM y el RTC transforman los nodos de simples transceptores a registradores de datos (data loggers) avanzados, mejorando drásticamente la capacidad de análisis, depuración y validación del rendimiento general del sistema.
