FranciscoRos/SolucionesEnergeticasParaWSN/INFORME TÉCNICO DE RESIDENCIA.docx

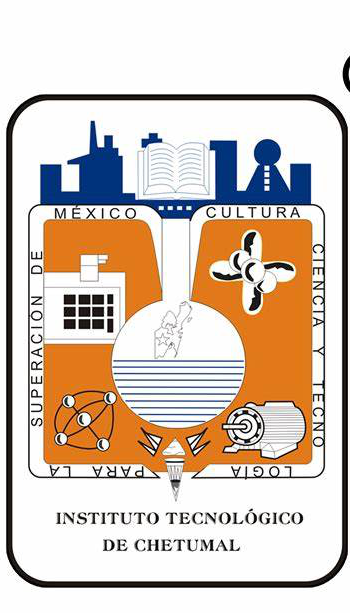
[picture p5: figure]

Tecnológico Nacional de México

Instituto Tecnológico de Chetumal

Departamento de Sistemas computacionales

Soluciones Energéticas para Redes de Sensores: Eficiencia y Sustentabilidad

Carrera

Ingeniería en Sistemas Computacionales

Presentan:

Rosales Huey Francisco Jareth

Tox Dzul Omar

Asesor

Lic. Esquivel Pat Agustín

Fecha

25 de noviembre de 2025

# Agradecimientos

Deseamos expresar nuestro más sincero agradecimiento a nuestro asesor, Agustín Esquivel, por su invaluable guía, dedicación y acertados consejos, los cuales fueron fundamentales para la culminación de este proyecto. Asimismo, extendemos nuestro reconocimiento al Centro de Innovación Tecnológica de Quintana Roo (CITQROO) por facilitarnos el acceso a sus instalaciones y por proveer el equipamiento y las herramientas tecnológicas indispensables para el desarrollo de esta investigación.

# Resumen

Este proyecto aborda los desafíos energéticos en las redes de sensores inalámbricos (WSN), esenciales para aplicaciones como monitoreo ambiental, agricultura de precisión y automatización industrial. Las WSN enfrentan problemas de sostenibilidad debido al uso de baterías tradicionales con limitada duración, lo que incrementa los costos operativos y limita su escalabilidad en entornos remotos.

El objetivo principal es optimizar el consumo de energía de estas redes mediante la implementación de algoritmos eficientes, protocolos de bajo consumo y el uso de fuentes renovables como energía solar. Se busca prolongar la vida útil de los nodos sensores, reducir costos energéticos, disminuir la huella ambiental y mejorar la sostenibilidad operativa.

La metodología incluye un enfoque experimental para diseñar y probar soluciones en entornos controlados, combinando hardware optimizado, fuentes de energía renovables y técnicas de ahorro energético. Además, se analizan protocolos de comunicación eficientes para maximizar la funcionalidad de las WSN.

El proyecto tiene un impacto significativo en la sostenibilidad ambiental y en la expansión de las aplicaciones de las WSN, contribuyendo al desarrollo de tecnologías más autónomas, sostenibles y adaptables en sectores críticos como la agricultura, la salud y el monitoreo ambiental.

# Abstract

This project addresses the energy challenges in Wireless Sensor Networks (WSN), which are essential for applications such as environmental monitoring, precision agriculture, and industrial automation. WSNs face sustainability issues due to the use of traditional batteries with limited lifespan, leading to increased operational costs and restricted scalability in remote environments.

The primary goal is to optimize the energy consumption of these networks through the implementation of efficient algorithms, low-power protocols, and the use of renewable energy sources like solar. The aim is to extend the lifespan of sensor nodes, reduce energy costs, minimize environmental impact, and enhance operational sustainability.

The methodology involves an experimental approach to design and test solutions in controlled environments, combining optimized hardware, renewable energy sources, and energy-saving techniques. Additionally, efficient communication protocols are analyzed to maximize the functionality of WSNs.

This project has a significant impact on environmental sustainability and the expansion of WSN applications, contributing to the development of more autonomous, sustainable, and adaptable technologies in critical sectors such as agriculture, healthcare, and environmental monitoring.

# Índice

# Índice de ilustraciones

# Índice de tablas

# Introducción

Las redes de sensores inalámbricos (WSN) han emergido como una tecnología clave para la recopilación de datos en tiempo real en una variedad de aplicaciones, que incluyen el monitoreo ambiental, la automatización industrial y la agricultura de precisión. Estas redes, compuestas por nodos sensores interconectados, son esenciales para recopilar y transmitir información relevante, contribuyendo a la toma de decisiones basadas en datos y a la optimización de procesos en diversos sectores.

A pesar de los avances en la implementación de WSN, uno de los desafíos más importantes que enfrentan es la gestión eficiente de la energía. Los nodos sensores, por lo general, están ubicados en zonas de difícil acceso, lo que limita la posibilidad de reemplazar o recargar las baterías. Cuando un nodo agota su fuente de energía, se convierte en un "nodo muerto", generando puntos de falla en la red que pueden interrumpir el flujo de datos y afectar el rendimiento general del sistema. Esta problemática subraya la necesidad de investigar métodos para extender la vida útil de los nodos y mantener la sostenibilidad operativa de las redes.

Numerosos estudios, como los de Guo & Healy (2014a) y Philco Asqui (2023), han abordado el desafío energético en las WSN, analizando modelos matemáticos de descarga de batería, recolección de energía y la optimización de topologías de red. Asimismo, investigaciones como las de Rivera Lopez (2020a) han explorado sistemas auto configurables y basados en LPWAN que maximizan la eficiencia mediante el uso de fuentes de energía alternativas y algoritmos de machine learning. Estos antecedentes resaltan la importancia de desarrollar estrategias de ahorro energético que combinen hardware optimizado, software eficiente y fuentes de energía renovables.

El presente proyecto de investigación se centra en explorar y evaluar diversas soluciones para la gestión energética en WSN, desde la implementación de protocolos de comunicación de bajo consumo hasta la integración de sistemas de recolección de energía solar. Al combinar estos enfoques, buscamos proponer una solución integral que reduzca el consumo energético y potencie la sostenibilidad de las WSN, facilitando su despliegue comercial e industrial en entornos donde el acceso a fuentes de energía convencionales es limitado.

Este estudio no solo tiene el potencial de optimizar el uso de la energía en las redes de sensores, sino que también contribuye a sentar las bases para un futuro más sostenible en el ámbito de las WSN. La implementación de soluciones energéticas eficientes podría impulsar su adopción en campos tan críticos como el monitoreo ambiental y la gestión de recursos naturales, abriendo nuevas oportunidades para la innovación tecnológica y el desarrollo sustentable.

# Antecedentes

Las redes de sensores inalámbricos (WSN, por sus siglas en inglés) son sistemas interconectados de dispositivos sensores que recopilan, transmiten y procesan datos de manera autónoma. Estas redes tienen aplicaciones amplias en sectores como el monitoreo ambiental, la automatización industrial, agricultura de precisión, la gestión de ciudades inteligentes y la salud.

En el monitoreo ambiental, las WSN se utilizan para observar fenómenos naturales, evaluar condiciones meteorológicas y medir contaminantes en el aire o agua. Estas redes son frecuentemente desplegadas en áreas remotas, donde la reposición de energía se convierte en un obstáculo importante. Al mejorar la eficiencia energética, se extiende la vida útil de los sensores y se asegura la recolección continua de datos críticos para el análisis ambiental.

En aplicaciones industriales, las WSN desempeñan un rol en la automatización de procesos, el monitoreo de maquinaria y la seguridad. El ahorro energético en estos entornos reduce los costos de mantenimiento y reposición de baterías, haciendo que el sistema sea más rentable y menos propenso a interrupciones

La energía es un factor determinante para la sostenibilidad y eficiencia de las redes de sensores inalámbricos. En sectores como la agricultura de precisión, los sensores permiten monitorear el estado del suelo, la humedad, la temperatura y otros factores clave, mejorando la toma de decisiones y optimizando el uso de recursos. Sin embargo, las operaciones continuas de estos sensores dependen de una fuente de energía confiable, lo cual es difícil de mantener sin soluciones de recolección u optimización energética.

Uno de los retos más significativos que enfrentan las WSN es la gestión eficiente de la energía, dado que los nodos sensores suelen estar en ubicaciones remotas donde el acceso a fuentes de energía continua es limitado, debido a esto es que si un nodo se queda sin batería es considerado muerto ya que a pesar de que todos sus componentes electrónicos están en perfecto estado llega a ser costoso el recuperar los nodos y reemplazar su batería, esto desencadena puntos muertos en la red de monitoreo lo que dependiendo del campo de aplicación puede ser desde un pequeño retraso hasta un grave tope a futuro

Para abordar este desafío, es esencial estudiar diversas fuentes de energía, incluyendo fuentes renovables como la solar o la eólica para implementar en sistemas de recolección de energía, y optimizar el software y hardware de los sensores para tanto reducir el consumo energético innecesario como implementar baterías eficientes dependiendo del problema a tratar por cada WSN. Las estrategias de ahorro energético que incluyan baterías de bajo consumo, métodos de recolección de energía del entorno y protocolos eficientes de comunicación representan avances fundamentales en este campo

Guo & Healy (2014b) realizan un análisis de las limitaciones energéticas en las redes de sensores inalámbricos (WSN). Plantean que la energía es un recurso limitado en los nodos debido a su pequeño tamaño y que la batería, como fuente principal de energía, falla antes del tiempo proyectado. Proponen analizar modelos matemáticos para caracterizar la descarga de la batería y examinan tecnologías de recolección de energía, este estudio es crucial porque establece la base del problema energético en las WSN, el cual intentamos mitigar en nuestra investigación al experimentar con fuentes de recolección de energía

Más recientemente, Orlando & Asqui (2023) abordan el tema de la eficiencia energética en las WSN en escenarios con despliegue aleatorio de nodos proponiendo estrategias para optimizar el consumo de energía, este trabajo ofrece aportes en la optimización energética mediante el uso de topologías estrella y de malla, aspectos que planteamos explorar al probar diferentes medios de transmisión y de implementación de topologías para el ahorro de energía, alineado a esto nos encontramos con el trabajo de Vera Pico et al. (2022) que, mediante una simulación, compara la eficiencia energética de diferentes configuraciones de red, este tema se alinea con nuestro objetivo de probar diferentes configuraciones de transmisión de datos

Otro trabajo a considerable en el campo del ahorro energético para las WSN es el de Mishra et al. (2022) que plantean una manera diferente para evitar consumir tanta energía ya que ellos implementan un paso antes del envío de los datos que es el comprimirlos antes de enviarlos ya que el envío de los datos es lo que más energía consume entonces al reducir el tamaño de los datos enviados se reduce el consumo energético, Mishra menciona que es importante considerar la naturaleza de los datos para saber si es óptimo utilizar éste método ya que es imprescindible que la compresión consuma menos energía que el ahorro que se hará, esto puede ser un punto de partida muy importante también para nosotros.

Otro estudio, Rivera Lopez (2020b) implementó un prototipo de red de sensores auto configurable para la recolección de datos ambientales. Este sistema, compuesto por nodos secundarios y un nodo maestro, se comunica mediante radiofrecuencia para medir variables como temperatura, humedad y presión, transmitiéndolas a una aplicación de procesamiento. Este diseño incluye una red neuronal para predecir el estado de carga de la batería de cada nodo, con la capacidad de alternar entre una batería y un panel solar, lo cual maximiza la eficiencia energética. Asimismo, esta red ofrece soporte a un vehículo no tripulado para la adquisición de datos, mostrando así el potencial de las WSN en el monitoreo autónomo y sustentable del medio ambiente.

Gordillo (2022) desarrolló un sistema de monitoreo basado en redes LPWAN, con un Meta Sistema Operativo que permite recolectar y analizar datos de factores tales como rayos UV, CO₂, temperatura y humedad en invernaderos. Utilizando algoritmos de machine learning, el sistema identifica patrones de crecimiento y optimiza el riego, minimizando la dependencia de decisiones empíricas y maximizando la precisión en el cultivo. Las pruebas en un entorno controlado validaron la eficiencia del sistema, el cual recolecta y visualiza los datos mediante una interfaz gráfica, destacando la contribución de la tecnología WSN en la mejora de la agricultura de precisión.

Por último, cabe mencionar los avances en la optimización del consumo energético en redes de sensores inalámbricos implementados por Lajara José (2014) ya que gracias a ello se han llevado a estudiar arquitecturas y sistemas operativos especializados como TinyOS, MantisOS y Contiki. Estos estudios permitieron diseñar arquitecturas de energía que combinan recolección solar y supercondensadores, logrando una operación eficiente y autónoma. Asimismo, se analizó la viabilidad de recolección de energía de ondas de radio comerciales para alimentar nodos de bajo consumo, lo cual representa un recurso adicional de energía en condiciones adversas y asegura la funcionalidad de las redes de sensores.

Los antecedentes seleccionados para este proyecto ofrecen una base sólida para comprender los desafíos y las soluciones en la eficiencia energética de redes de sensores inalámbricos (WSN), tema central de nuestra investigación. La revisión de estudios previos revela cómo las WSN han sido aplicadas en sectores como el monitoreo ambiental, la automatización industrial y la agricultura de precisión, donde el ahorro y recolección de energía son esenciales debido a la operación en entornos de difícil acceso para la reposición de baterías. A partir de estas investigaciones, podemos explorar fuentes de energía renovables y configuraciones eficientes que potencien la sostenibilidad de las WSN. Los estudios de Rivera Lopez (2020a) y Gordillo (2022) sobre redes auto configurables y basadas en LPWAN también destacan el uso de algoritmos avanzados y fuentes de energía alternativas, confirmando la relevancia de implementar tecnologías avanzadas para optimizar el consumo energético. Estos antecedentes son, por tanto, fundamentales para contextualizar y justificar las estrategias de ahorro y recolección de energía en nuestro proyecto de investigación.

# Planteamiento del problema

Las redes de sensores inalámbricos (WSN) son sistemas distribuidos que permiten la recolección y transmisión de datos en diversos entornos, incluyendo la agricultura, el monitoreo ambiental y la automatización industrial. Estas redes desempeñan un papel fundamental en el desarrollo del Internet de las Cosas (IoT), facilitando la toma de decisiones en tiempo real. Sin embargo, su operatividad se ve comprometida por un problema crítico: la eficiencia energética.

El problema principal de las WSN radica en la limitada capacidad de sus baterías y la dificultad de recargarlas en entornos remotos o de difícil acceso. Los nodos sensores dependen de estas baterías para su funcionamiento, y cuando se agotan, dejan de operar, generando interrupciones en la red y reduciendo su vida útil. A esto se suma que muchos protocolos de comunicación y software utilizados en las WSN no están optimizados, lo que provoca un consumo de energía mayor al necesario y afecta su sostenibilidad a largo plazo.

La falta de una gestión energética eficiente incrementa los costos operativos y limita la viabilidad de las WSN en aplicaciones a gran escala. Muchos proyectos quedan restringidos a la fase de prototipado debido a la imposibilidad de mantener una autonomía energética prolongada, lo que impide su implementación en escenarios reales. (Padilla, Quintero & Diaz, 2015)

Para abordar esta problemática, es necesario investigar estrategias que permitan optimizar el consumo energético de las WSN. Entre las soluciones viables se encuentran el uso de fuentes de energía renovable (como la solar) y la implementación de protocolos de comunicación de bajo consumo. Estas estrategias podrían extender la autonomía de las redes, reducir su impacto ambiental y potenciar su uso en sectores clave como la agricultura de precisión, el monitoreo ambiental y la industria como lo mencionan (Luis & Luis, 2019).

Dado el impacto de las WSN en múltiples áreas tecnológicas, abordar su problema energético es esencial para garantizar su operatividad a largo plazo. Esta investigación busca desarrollar soluciones integrales que permitan mejorar la sostenibilidad de estas redes y fomentar su adopción en el ámbito comercial e industrial.

## Objetivo general de la investigación:

Optimizar el consumo de energía en redes de sensores inalámbricas (WSN) mediante algoritmos de gestión energética, protocolos de bajo consumo y fuentes renovables, logrando una reducción del consumo en al menos 30% en un período de 6 meses de pruebas

## Objetivos específicos

- Evaluar en 3 meses el consumo energético en nodos sensores con baterías convencionales y fuentes renovables, comparando su autonomía mediante medición del tiempo de operación.
- Desarrollar e implementar en 4 meses un algoritmo de gestión energética que reduzca el consumo en al menos 20%, optimizando modos sleep y transmisión de datos
- Comparar en un periodo de 2 meses la eficiencia energética de diferentes estrategias de comunicación en WSN.

## Justificación

Las redes de sensores inalámbricos (WSN) están compuestas por nodos autónomos alimentados por baterías, cuyo consumo de energía es un factor clave en su diseño. Esto ha impulsado la investigación en la optimización del consumo energético, explorando técnicas como la recolección de energía y la mejora en la eficiencia de las baterías. En esta investigación, se propone implementar algoritmos que permitan mejorar su rendimiento, además de comparar y analizar distintos protocolos de comunicación para identificar aquel que ofrezca el mejor ahorro de energía en función de factores como la distancia y las condiciones operativas. Asimismo, se implementa una fuente de alimentación que combina energía solar y supercondensadores, permitiendo una mayor autonomía para los dispositivos Lajara José (2014)

Este proyecto tiene un amplio impacto en el ámbito tecnológico especialmente en el campo del IoT ya que da paso a que las WSN tengan mayor facilidad para planificar su autonomía energética lo que da paso a que más proyectos puedan ser implementados de forma amplia, autónoma e incluso de forma comercial ya que estaría dejándose de lado una parte de los obstáculos y la preocupación referente a la fuente energética.

La manera en que ampliaría el campo comercial de las WSN es que habrá una mayor cantidad de procesos que se puedan realizar de forma autónoma con las redes de sensores a un menor costo.

En el ámbito social, este proyecto busca facilitar el monitoreo de las redes de sensores, permitiendo una gestión más eficiente y reduciendo la preocupación de los usuarios por su mantenimiento. Gracias a una mayor autonomía, se minimiza la necesidad de intervenciones frecuentes, lo que no solo optimiza el uso de recursos, sino que también mejora la experiencia de los usuarios al brindar un sistema más confiable y de fácil operación.

En el ámbito ambiental, este proyecto busca reducir el uso de baterías convencionales desarrollando soluciones que apliquen energía obtenida de fuentes renovables (eólica, solar, etc) además de optimizar el consumo de energía.

## Factibilidad

### Factibilidad técnica

El proyecto realizado presenta un enfoque sólido orientado a la optimización y aplicación de pruebas en redes de sensores inalámbricos. Esta viabilidad se respalda en la disponibilidad tecnológica actual, donde las herramientas necesarias están claramente definidas y son accesibles, incluyendo funciones de bajo consumo como .sleep() y protocolos de comunicación eficientes energéticamente como LoRa, XBee y MQTT. Aunque la implementación y optimización del código es totalmente viable con el conocimiento disponible, el éxito definitivo del proyecto dependerá de la correcta integración de los módulos de carga para energías renovables y del perfeccionamiento de algoritmos que maximicen la eficiencia. Si bien se han identificado riesgos técnicos posteriores al análisis, como posibles fallos en las pruebas de los nodos sensores o dificultades en la integración de los protocolos, estos pueden mitigarse eficazmente mediante iteraciones y pruebas controladas en un entorno experimental. En conclusión, la factibilidad técnica para la realización del proyecto es viable, siempre y cuando se asegure la estricta compatibilidad de los sensores con las estrategias propuestas.

### Factibilidad operativa

El proyecto es operativamente viable ya que responde directamente a uno de los principales desafíos en las redes de sensores: el consumo energético. Las soluciones propuestas, tales como las funciones de bajo consumo y los protocolos de comunicación eficientes, se integran perfectamente con operaciones existentes y están alineadas con aplicaciones prácticas en sectores clave como la agricultura, el monitoreo ambiental y la automatización industrial. Los resultados esperados serán de gran utilidad tanto para desarrolladores de sistemas IoT como para operadores de redes, facilitando su aceptación e implementación. Aunque el proyecto es prometedor, existen riesgos operativos latentes, como fallos en la transmisión de datos o limitaciones de eficiencia en escenarios reales, los cuales requerirán ajustes constantes y evaluaciones continuas. En definitiva, la factibilidad operativa es positiva, siendo esencial realizar pruebas exhaustivas en entornos reales para validar la aplicabilidad y efectividad de las soluciones.

### Factibilidad ambiental

El proyecto presenta una factibilidad ambiental altamente positiva, destacándose por su alineación con los objetivos de sostenibilidad y su impacto favorable en el ecosistema. Esto se logra principalmente mediante la integración de fuentes de energía renovable, como la solar, lo cual reduce el impacto ambiental y minimiza la dependencia de baterías desechables y fuentes no renovables. Asimismo, al prolongar la vida útil de los nodos sensores, se contribuye significativamente a la reducción de desechos electrónicos y se disminuye el ciclo de reemplazo de equipos, favoreciendo la sostenibilidad a largo plazo. Además, el proyecto tiene aplicaciones ambientales directas, facilitando el monitoreo de ecosistemas para la predicción de desastres naturales y promoviendo la agricultura de precisión para un uso más eficiente de los recursos naturales.

# Marco teórico

## Marco conceptual

### Redes de sensores inalámbricas (WSN en inglés)

Definición

Las Redes de Sensores Inalámbricos (WSN, por sus siglas en inglés) son sistemas compuestos por nodos sensores interconectados de manera inalámbrica, diseñados para monitorear y recopilar datos del entorno, como temperatura, humedad, presión, o niveles de luz (Novelo Sansores, 2020a) . Estos datos son procesados y transmitidos a través de la red hacia un nodo central o estación base, donde se pueden analizar y tomar decisiones en función de la información recolectada. Los nodos sensores están equipados con componentes como unidades de sensado, procesamiento, comunicación y alimentación, que les permiten operar de manera autónoma en entornos variados.

Importancia

Las WSN tienen un papel crucial en la evolución tecnológica y científica debido a su capacidad para operar en entornos remotos, hostiles o de difícil acceso. Su importancia radica en:

1. Automatización y monitoreo eficiente: Son esenciales para la recolección de datos en tiempo real en diversos campos como la agricultura, la salud, y la gestión ambiental.
2. Optimización de recursos: Permiten mejorar la eficiencia de procesos mediante el análisis de datos precisos y la toma de decisiones informadas.
3. Reducción de costos: Minimizan la intervención humana en tareas como el mantenimiento o monitoreo continuo.
4. Contribución al desarrollo sostenible: Su implementación facilita el uso eficiente de recursos energéticos y naturales.

Objetivos

1. Monitoreo y control en tiempo real: Proveer información confiable sobre las variables monitoreadas para la toma de decisiones.
2. Optimización de recursos energéticos: Implementar estrategias de bajo consumo para prolongar la vida útil de los nodos sensores.
3. Accesibilidad y autonomía: Operar en áreas remotas sin necesidad de infraestructura previa.
4. Adaptabilidad: Ser flexibles para diversas aplicaciones mediante configuraciones específicas y personalizadas.

Tipos

1. Basadas en topología (Philco Asqui, 2023):
  - Topología estrella: Cada nodo sensor se conecta directamente al nodo central. Es simple pero tiene baja tolerancia a fallos.
  - Topología de malla: Los nodos se conectan entre sí, permitiendo múltiples rutas para la transmisión de datos, lo que aumenta la tolerancia a fallos.
  - Topología jerárquica: Nodos organizados en niveles donde los de mayor jerarquía actúan como intermediarios para los de menor nivel.
2. Por aplicación:
  - Monitoreo ambiental: Para medir variables del medio ambiente.
  - Automatización industrial: Supervisar maquinaria o procesos.
  - Agricultura de precisión: Monitoreo de factores como humedad y calidad del suelo.
3. Por fuente de energía:
  - Alimentadas por baterías: Uso convencional, aunque con limitaciones de vida útil.
  - Con recolección de energía: Incorporan fuentes renovables como solar o eólica.

Alcance

El alcance de las redes de sensores inalámbricos incluye aplicaciones en múltiples sectores:

1. Agricultura: Optimización de riego, monitoreo de cultivos y prevención de plagas.
2. Salud: Monitoreo de pacientes, detección temprana de enfermedades y supervisión remota.
3. Gestión urbana: Desarrollo de ciudades inteligentes, incluyendo gestión de tráfico y calidad del aire.
4. Monitoreo ambiental: Detección de cambios en ecosistemas, predicción de desastres naturales y conservación de recursos naturales.
5. Defensa y seguridad: Vigilancia en áreas de alto riesgo y detección de intrusiones.

### Nodo sensor

#### Definición

Un nodo sensor es un dispositivo autónomo que forma parte de una red de sensores inalámbricos (WSN). Está diseñado para detectar y medir parámetros físicos o ambientales, como temperatura, humedad, presión, luz, vibraciones o movimiento (Philco Asqui, 2023). Además, tiene la capacidad de procesar los datos recolectados y transmitirlos de forma inalámbrica hacia otros nodos o hacia un nodo central, permitiendo la recopilación y análisis de información en tiempo real.

Los nodos sensores se componen generalmente de cuatro módulos principales:

1. Unidad de sensado: Incluye los sensores físicos encargados de medir las variables del entorno.
2. Unidad de procesamiento: Maneja los datos recogidos y ejecuta algoritmos para optimizar su uso.
3. Unidad de comunicación: Transmite los datos procesados hacia otros nodos o al nodo central utilizando protocolos inalámbricos.
4. Unidad de alimentación: Provee la energía necesaria para el funcionamiento del nodo, ya sea mediante baterías o fuentes de energía renovable.

#### Importancia

1. Punto clave de las WSN: Los nodos sensores son la base de las redes de sensores inalámbricos, ya que realizan la función primaria de sensado y transmisión de datos.
2. Accesibilidad y monitoreo remoto: Permiten medir variables en lugares de difícil acceso, lo que resulta esencial en aplicaciones como monitoreo ambiental y agricultura de precisión.
3. Optimización de recursos: Ayudan a reducir costos al automatizar procesos de recolección de datos.
4. Escalabilidad: Su diseño modular permite aumentar o reducir su número según las necesidades del proyecto.

#### Objetivos

1. Monitorear el entorno: Detectar y medir parámetros relevantes con precisión.
2. Procesar y transmitir datos: Asegurar que los datos recolectados sean enviados de manera eficiente hacia el nodo central.
3. Asegurar bajo consumo energético: Operar con mínima energía para prolongar su vida útil.

### Nodo central

#### Definición

El nodo central, también conocido como estación base, es el componente principal de una red de sensores inalámbricos (WSN) encargado de recopilar, procesar y almacenar los datos provenientes de los nodos sensores. Sirve como puente entre la red y el usuario final, transmitiendo la información a sistemas externos para su análisis o visualización (Rivera Lopez, 2020a).

#### Importancia

1. Coordinación de la red: Actúa como el núcleo para administrar y sincronizar las actividades de los nodos sensores.
2. Recolección de datos: Centraliza la información obtenida en la red para su procesamiento y análisis.
3. Conexión con sistemas externos: Proporciona la interfaz necesaria para integrar la WSN con aplicaciones externas como bases de datos, sistemas en la nube o dashboards.
4. Optimización del consumo energético: Reduce el esfuerzo de procesamiento en nodos sensores al asumir tareas complejas.

#### Objetivos

1. Concentrar datos: Recopilar información de los nodos sensores para garantizar una visión integral del entorno monitoreado.
2. Gestionar la red: Supervisar el estado y funcionamiento de los nodos, incluyendo su conexión y consumo energético.
3. Comunicar resultados: Transmitir los datos procesados a sistemas externos para su análisis avanzado.

### Gestión de Energía en Redes de Sensores Inalámbricos (WSN)

#### Definición

La gestión de energía en redes de sensores inalámbricos (WSN) abarca las estrategias, técnicas y tecnologías implementadas para optimizar el uso de energía de los nodos sensores y otros componentes de la red. Su objetivo principal es prolongar la vida útil de los nodos y garantizar el funcionamiento continuo de la red, especialmente en entornos donde la reposición de energía es difícil o imposible.

#### Importancia

1. Prolongación de la vida útil: Reduce la frecuencia de mantenimiento y reposición de baterías, minimizando costos.
2. Funcionamiento autónomo: Permite que las redes operen de manera eficiente durante períodos prolongados, incluso en ubicaciones remotas.
3. Sostenibilidad ambiental: Reduce el impacto ambiental asociado al desecho de baterías y la sobrecarga energética.
4. Fiabilidad de la red: Minimiza interrupciones en la recolección y transmisión de datos.

#### Objetivos

1. Optimizar el consumo energético: Reducir el uso de energía mediante técnicas como modos de suspensión, compresión de datos y algoritmos eficientes.
2. Implementar fuentes alternativas: Incorporar tecnologías como recolección de energía solar, eólica o de vibraciones.
3. Balancear el consumo: Distribuir la carga energética entre los nodos para evitar puntos críticos.

#### Tipos

1. Gestión pasiva: Uso de hardware eficiente, como microcontroladores de bajo consumo o sensores optimizados.
2. Gestión activa: Implementación de estrategias de software, como protocolos de comunicación eficientes y optimización de rutas de transmisión (Romero Amondaray et al., 2002)
3. Recolección de energía: Uso de tecnologías como paneles solares, recolectores piezoeléctricos o de ondas de radio para recargar baterías.

### Energía Renovable

#### Definición

La energía renovable se refiere a aquellas fuentes de energía obtenidas de recursos naturales que son inagotables o se regeneran de forma continua, como la luz solar, el viento, el agua, la biomasa y el calor geotérmico. Estas fuentes representan una alternativa sostenible frente a los combustibles fósiles, ya que producen menos emisiones de gases de efecto invernadero y contribuyen a mitigar el cambio climático.

#### Ventajas

1. Impacto ambiental reducido: Genera energía sin emisiones contaminantes significativas.
2. Inagotabilidad: Las fuentes renovables, como el sol y el viento, son virtualmente inagotables.
3. Accesibilidad: Puede implementarse en áreas remotas donde no llega la red eléctrica tradicional.
4. Diversificación energética: Reduce la dependencia de fuentes de energía no renovables.

### Protocolos de Comunicación

#### Definición

Un protocolo de comunicación es un conjunto de reglas y estándares que permiten la transferencia de datos entre dispositivos dentro de una red. Estos protocolos aseguran que los datos sean enviados, recibidos y procesados correctamente, definiendo aspectos como el formato, la sincronización y los métodos de transmisión. En redes de sensores inalámbricos (WSN), los protocolos juegan un papel crucial para garantizar la eficiencia energética, la robustez y la confiabilidad de la red (Romero Amondaray et al., 2002).

#### Objetivos

1. Estandarizar las reglas de comunicación para garantizar la compatibilidad entre dispositivos.
2. Optimizar los recursos disponibles, como el ancho de banda y la energía.
3. Proveer mecanismos de seguridad para proteger los datos transmitidos.
4. Garantizar la calidad del servicio (QoS) en aplicaciones críticas.

### LoRa

#### Definición

LoRa (Long Range) es una tecnología de modulación inalámbrica que utiliza espectro ensanchado por chirp para permitir la transmisión de datos a largas distancias con bajo consumo de energía. Es ampliamente utilizada en redes LPWAN (Low-Power Wide-Area Network) y es ideal para aplicaciones de IoT y sensores remotos según Guo & Healy.

#### Importancia

1. Cobertura extensa: Ofrece un rango de comunicación de hasta 15 km en condiciones óptimas.
2. Eficiencia energética: Diseñada para operar con dispositivos de bajo consumo, prolongando la vida útil de las baterías en redes de sensores.
3. Flexibilidad: Es compatible con múltiples dispositivos y aplicaciones en sectores como agricultura, monitoreo ambiental y ciudades inteligentes.

#### Objetivos

1. Proveer comunicación inalámbrica eficiente en términos de alcance y consumo energético.
2. Facilitar la conectividad en áreas remotas y entornos difíciles para redes convencionales.
3. Promover la integración de dispositivos IoT en redes de baja potencia.

### XBee

#### Definición

Nos dice Novelo Sansores (2020b) que XBee es una familia de módulos de radiofrecuencia que soportan estándares como Zigbee, 802.15.4, DigiMesh y Wi-Fi. Son ampliamente utilizados en redes de sensores y sistemas embebidos para la transmisión de datos a cortas y medias distancias.

#### Importancia

1. Versatilidad: Compatible con múltiples protocolos, adaptándose a distintas aplicaciones.
2. Facilidad de uso: Configuración y programación simplificadas, ideales para prototipos y proyectos educativos.
3. Interoperabilidad: Permite integrar redes heterogéneas con diversos dispositivos.

#### Objetivos

1. Proveer una solución de comunicación inalámbrica confiable y de bajo costo.
2. Facilitar la creación de redes malladas o punto a punto para aplicaciones de IoT.

### MQTT (Message Queuing Telemetry Transport)

#### Definición

MQTT es un protocolo de comunicación ligero basado en el modelo publicador-suscriptor (Tapias Baena (2021)). Fue diseñado originalmente por IBM en 1999 para transmisiones de datos de sensores en redes con ancho de banda limitado o inestables. Utiliza el protocolo TCP/IP para garantizar la entrega confiable de mensajes, lo que lo hace ideal para aplicaciones de Internet de las Cosas (IoT), donde el ahorro energético y la eficiencia de transmisión son críticos.

#### Importancia

1. Eficiencia de recursos: El bajo peso del protocolo lo hace adecuado para dispositivos con limitaciones de memoria, energía y procesamiento.
2. Escalabilidad: Su modelo publicador-suscriptor permite gestionar grandes volúmenes de dispositivos y mensajes sin sobrecargar la red.
3. Confiabilidad: Permite configurar niveles de calidad de servicio (QoS) para asegurar la entrega de mensajes en condiciones adversas.

#### Características Clave

1. Modelo Publicador-Suscriptor:
  - Los clientes publican mensajes en "tópicos" (canales de comunicación).
  - Otros clientes se suscriben a estos tópicos para recibir los mensajes publicados.
  - Desacopla al remitente del receptor, mejorando la flexibilidad.
2. Persistencia:
  - Los mensajes "retained" permiten que nuevos suscriptores reciban el último mensaje publicado en un tópico.
3. Bajo Consumo Energético:
  - Diseñado para reducir el intercambio de datos y prolongar la duración de baterías en dispositivos IoT.

#### Ventajas

1. Ligereza: Consume pocos recursos en comparación con protocolos como HTTP.
2. Versatilidad: Funciona en redes con conectividad intermitente o de baja calidad.
3. Confiabilidad: La capacidad de ajustar el QoS garantiza la entrega adecuada de datos en aplicaciones críticas.

### Protocolo de Control de Acceso al Medio (MAC)

Definición

El Protocolo de Control de Acceso al Medio (MAC, por sus siglas en inglés: Medium Access Control) es un conjunto de reglas que regulan cómo los dispositivos en una red comparten un medio de transmisión. Su principal función es gestionar la comunicación entre los nodos sensores, evitando colisiones y optimizando el uso del canal inalámbrico. En redes de sensores inalámbricas (WSN), los protocolos MAC están diseñados para minimizar el consumo energético mientras garantizan una transmisión eficiente de datos

Importancia

El protocolo MAC es esencial en las WSN, ya que define cuándo y cómo los nodos pueden transmitir datos, evitando interferencias y asegurando un uso eficiente del canal de comunicación. Dado que la transmisión de datos es una de las principales fuentes de consumo energético en los sensores, el diseño de un MAC eficiente puede prolongar la autonomía de la red, reducir la latencia y mejorar la fiabilidad en la entrega de paquetes.

Clasificación

Los protocolos MAC en redes de sensores se dividen en dos grandes categorías:

- Protocolos MAC síncronos: Como TDMA (Time Division Multiple Access), donde el tiempo se divide en ranuras asignadas a cada nodo para evitar colisiones.
- Protocolos MAC asíncronos: Como CSMA/CA (Carrier Sense Multiple Access with Collision Avoidance), donde los nodos detectan si el canal está libre antes de transmitir.

## Estado del Arte

### Protocolos Mac de bajo consumo

En redes de sensores inalámbricas (WSN), el consumo energético se ve altamente influenciado por el protocolo de control de acceso al medio (MAC). Investigaciones previas han desarrollado protocolos como Sensor-MAC (S-MAC) y Timeout-MAC (T-MAC), que implementan ciclos de sueño para reducir el consumo de energía en los nodos sensores. Wei Ye et al. (2002) propusieron S-MAC, el cual sincroniza los periodos de actividad y reposo entre los nodos para minimizar el tiempo de escucha innecesario. Por otro lado, van Dam & Langendoen (2003) introdujeron T-MAC, que ajusta dinámicamente los tiempos de transmisión y suspensión con base en la carga de tráfico en la red. Además, se han desarrollado protocolos híbridos que combinan CSMA/CA y TDMA para mejorar la eficiencia energética. Al-Janabi & Al-Raweshidy (2019) propusieron un protocolo híbrido que utiliza una tabla de programación dinámica para la activación y suspensión de los nodos, logrando una reducción significativa en el consumo de energía. Y, según Sadeq et al. (2022), a pesar de que los protocolos MAC juegan un papel crucial en la eficiencia energética y el rendimiento de las WSN, a medida que la escala de la red aumenta, se presentan desafíos significativos en términos de latencia, escalabilidad y eficiencia energética que deben ser abordados a futuro

### Estrategias de recolección de energía en WSN

El consumo energético es uno de los principales desafíos en el diseño y operación de redes de sensores inalámbricas (WSN), especialmente cuando los nodos sensores se implementan en entornos donde el mantenimiento y la sustitución de baterías no es viable. Para abordar esta limitación, se han desarrollado diversas estrategias de recolección de energía que permiten extender la vida útil de los nodos, disminuyendo la dependencia de fuentes de alimentación tradicionales

A. Fuentes de Recolección de Energía en WSN

Diferentes estudios han explorado diversas fuentes de energía renovable aplicadas a redes de sensores, destacando las siguientes:

1. Energía Solar

La recolección de energía solar es una de las técnicas más utilizadas debido a la alta disponibilidad y eficiencia de conversión de la radiación solar en electricidad. Según Lajara José (2014) , la implementación de celdas solares con almacenamiento híbrido en baterías y supercondensadores puede extender significativamente la autonomía de los nodos sensores, permitiendo que operen exclusivamente con energía solar en condiciones climáticas favorables

- Ventajas: Alta eficiencia en condiciones de buena iluminación, tecnología madura y relativamente económica.
- Desafíos: Variabilidad en la captación de energía debido a factores climáticos y cambios estacionales.

2. Energía Piezoeléctrica

Otra alternativa es el uso de dispositivos piezoeléctricos para capturar energía mecánica del ambiente, como vibraciones y movimientos estructurales. Estudios recientes han demostrado que estos sistemas pueden generar energía suficiente para alimentar sensores de bajo consumo, aunque presentan limitaciones en la cantidad de energía capturadaRedes de sensores.

- Ventajas: Funcionamiento continuo en entornos con movimiento constante.
- Desafíos: Baja producción energética y necesidad de integración con otras fuentes.

3. Recolección de Energía de Radiofrecuencia (RF Energy Harvesting)

El aprovechamiento de ondas de radio como fuente de energía ha sido un área de creciente interés. Se han desarrollado circuitos capaces de capturar señales de radiofrecuencia y convertirlas en electricidad para alimentar nodos sensores. Zungeru et al. (2012) explican que la captación de energía de RF permite la recarga constante de los sensores, siempre que haya una fuente emisora lo suficientemente fuerte en las cercanías, la eficiencia de este tipo de sistemas depende en gran medida de la distancia entre el sensor y la fuente de emisión, así como de la densidad de señales en el entorno.

- Ventajas: Disponibilidad continua en entornos urbanos con múltiples fuentes de emisión.
- Desafíos: Baja eficiencia en la conversión de energía y dependencia de fuentes externas de transmisión de radio.

4. Termoeléctrica

El uso de diferencias de temperatura entre dos superficies para generar electricidad mediante el efecto Seebeck ha sido estudiado como una solución viable para WSN en entornos con variaciones térmicas, como en industrias o regiones geotérmicas. Wei Chen et al. (2013) desarrollaron un modelo experimental en el que pequeños generadores termoeléctricos (TEG) fueron capaces de alimentar sensores en tuberías industriales, aprovechando el calor residual.

- Ventajas: Genera energía pasiva en entornos con fluctuaciones térmicas, como instalaciones industriales y equipos de alta temperatura.
- Desafíos: Bajo nivel de generación eléctrica en condiciones de gradientes térmicos bajos, lo que requiere sistemas eficientes de almacenamiento.
4. Eólica

La energía eólica es otra fuente de energía alternativa común en nuestra vida diaria, sin embargo, no lo es para las WSN, esto se debe a varios factores como la infraestructura más compleja que manejan los aerogeneradores y las limitaciones en los espacios en los que las WSN se ven desplegadas, a pesar de ello, hay investigaciones recientes que exploran el uso de microturbinas eólicas para alimentar nodos sensores. Por ejemplo, el estudio de Yu et al. presenta un generador eléctrico impulsado por el viento basado en una unión Schottky dinámica, capaz de producir una corriente continua promedio de 4.4 mA, con picos de hasta 8.4 mA, durante 360 segundos. Este avance sugiere la viabilidad de utilizar el viento como fuente de energía para sensores distribuidos en entornos con flujo de aire constante

- Ventajas: Generación de energía en entornos con flujo de aire constante, posibilidad de complementar otras fuentes de energía en sistemas híbridos.
- Desafíos: Variabilidad en la velocidad del viento, necesidad de diseños que minimicen el desgaste mecánico y maximicen la eficiencia en condiciones de viento variable.

B. Estrategias de almacenamiento de Energía

Además de la captación de energía, es fundamental desarrollar estrategias de almacenamiento y gestión energética para optimizar el uso de los recursos recolectados. Entre las soluciones más estudiadas se encuentran:

1. Uso de supercondensadores

Los supercondensadores se han investigado como una alternativa eficiente a las baterías convencionales debido a su alta capacidad de carga y descarga rápida. En estudios recientes, se ha demostrado que el uso de supercondensadores en combinación con baterías recargables permite reducir la degradación de estas últimas, mejorando la autonomía de los nodos. Lajara José propone un sistema híbrido donde los supercondensadores priorizan la alimentación del nodo y solo en ausencia de carga solar se recurre a la batería.

2. Algoritmos de gestión de energía

Para mejorar la eficiencia del sistema, se han desarrollado algoritmos adaptativos que regulan el consumo energético en función de la energía recolectada. Calvo-Fullana et al. (2016) propusieron un enfoque basado en asignación dinámica de potencia, donde los sensores adaptan su consumo energético dependiendo de la cantidad de energía almacenada y disponible. Estos modelos mejoran la sostenibilidad reduciendo los períodos de inactividad debido a la falta de energía, esto nos da una maximización del aprovechamiento del uso de la energía recolectada, sin embargo, requiere procesamiento adicional lo que puede llegar a afectar nuestras mediciones

### Algoritmos de ahorro de energía en WSN

La eficiencia energética en las WSN no solo es un factor crítico para la vida útil de la red, sino que también influye en la precisión y continuidad de la recolección de datos, es por esto que para abordar este problema, investigadores han desarrollado diversos algoritmos de ahorro energético que optimizan el consumo en diferentes niveles, desde la administración del tiempo de actividad de los nodos hasta la optimización en la transmisión y procesamiento de datos; en la siguiente sección, se describirán los principales tipos de algoritmos de ahorro de energía, desde los más sencillos hasta los más avanzados, detallando su implementación, resultados y futuras mejoras propuestas por los autores

Algoritmos de Duty Cycling

Los algoritmos de Duty Cycling regulan el tiempo que un nodo permanece activo o en modo de bajo consumo para minimizar el gasto energético. Se basan en la premisa de que los sensores no necesitan estar activos todo el tiempo, sino solo en momentos clave

Sedighimanesh et al. (2016) propusieron un esquema en el cual los nodos reducen su tiempo de actividad al mínimo y solo despiertan en intervalos específicos para transmitir datos, bajo este esquema corrieron simulaciones distintas bajo diferentes parámetros y condiciones, en estos estudios de simulación, este enfoque redujo el consumo de energía hasta un 40%, incrementando la autonomía de la red sin afectar la calidad de los datos recolectados, los investigadores han planteado que una mejora futura en Duty Cycling sería la incorporación de algoritmos adaptativos, que ajusten dinámicamente el tiempo de actividad en función de la carga de tráfico y la cantidad de energía disponible en el nodo. Esto permitiría una optimización más eficiente de los recursos y evitaría la activación innecesaria de los nodos, prolongando aún más su vida útil

Algoritmos de Balanceo de Carga Energética

Los algoritmos de balanceo de carga energética tienen como objetivo distribuir el consumo de energía de manera equitativa entre los nodos sensores, evitando que algunos se descarguen más rápido que otros y garantizando así una mayor duración de la red.

Samara et al. (2022) desarrollaron un algoritmo de balanceo energético basado en la identificación de nodos óptimos para actuar como líderes de clúster, seleccionándolos en función de su ubicación y su nivel de energía disponible. En sus experimentos de simulación, demostraron que este enfoque prolonga la vida de la red en un 31% en comparación con LEACH, uno de los protocolos estándar más utilizados en WSN. El principal desafío de estos algoritmos radica en la dinámica de las redes de sensores, donde algunos nodos pueden consumir energía más rápido dependiendo de su función en la red. Por ello, los investigadores han sugerido la integración de estos algoritmos con sistemas de recolección de energía, permitiendo que los nodos que capturan más energía del entorno asuman una mayor carga de trabajo, mejorando así la eficiencia global de la red

Algoritmos de Enrutamiento Energéticamente Eficientes

El enrutamiento de datos en WSN es una de las actividades que más consumo energético genera, ya que cada transmisión implica un gasto considerable de energía en los nodos intermedios. Para mitigar este problema, se han desarrollado algoritmos de enrutamiento optimizados, que buscan minimizar el número de transmisiones necesarias para enviar los datos al destino final

Barker & Swany (2020) propusieron un algoritmo de enrutamiento basado en reducción de datos, en el que los nodos procesan y filtran la información antes de enviarla, evitando la transmisión de datos redundantes o innecesarios. Sus experimentos demostraron que este enfoque reduce el uso de ancho de banda, disminuye el consumo energético y mejora la velocidad de transmisión en redes con tráfico elevado, los investigadores han identificado oportunidades de mejora en estos algoritmos mediante la integración de inteligencia artificial y aprendizaje automático, lo que permitiría ajustar dinámicamente las rutas de transmisión y reducir aún más el desperdicio energético. Se plantea que en el futuro estos algoritmos puedan incorporar sistemas de predicción de tráfico de datos, de manera que los nodos puedan seleccionar rutas óptimas en función del estado actual y futuro de la red

Algoritmos de Compresión de Datos para Ahorro de Energía

Una estrategia alternativa para reducir el consumo energético en WSN es la compresión de datos, la cual busca disminuir el volumen de información transmitida, reduciendo así el uso de energía en cada transmisión ya que la relación entre la energía gastada para enviar y el tamaño de los datos enviados es proporcional

Wei Chen et al. (2013) desarrollaron un esquema de compresión distribuida, en el cual los nodos sensores identifican y eliminan información redundante antes de enviarla. En sus experimentos, observaron que este enfoque redujo el consumo energético en un 50%, al disminuir significativamente la cantidad de paquetes de datos transmitidos, a pesar de los beneficios de la compresión de datos, existen desafíos en su implementación, especialmente en sensores con recursos de procesamiento limitados. Por esta razón, se han propuesto modelos que combinan compresión con técnicas de procesamiento en el borde (Edge Computing), permitiendo que la reducción de datos se realice en nodos con mayor capacidad de cómputo antes de enviarlos al servidor central, sin embargo, esta propuesta propondría nuevos retos al necesitar definir las rutas de envío y decidir cuales nodos tienen menor carga por lo cual abre espacio a nuevas investigaciones y pruebas en laboratorio

Los algoritmos de ahorro de energía en WSN son una herramienta fundamental para extender la vida útil de las redes y mejorar su eficiencia. Desde estrategias simples como Duty Cycling, hasta enfoques más avanzados como balanceo de carga, enrutamiento optimizado y compresión de datos, cada técnica aporta soluciones a distintos niveles del consumo energético, en el futuro, se espera que estos algoritmos se combinen con fuentes de recolección de energía del entorno, logrando redes de sensores inalámbricas verdaderamente sostenibles y con autonomía prácticamente ilimitada

### Modelado del Consumo Energético en Redes de Sensores Inalámbricas (WSN)

El modelado del consumo energético es una técnica utilizada para describir, predecir y analizar el gasto de energía en un sistema determinado. En el contexto de las redes de sensores inalámbricas (WSN), se emplea para estimar cuánta energía consumen los nodos sensores bajo diferentes condiciones de operación.

Dado que estos sistemas funcionan en entornos con restricciones energéticas, como sensores desplegados en ubicaciones remotas o de difícil acceso, entender cómo se distribuye el consumo de energía es fundamental para optimizar su desempeño y prolongar su autonomía.

El modelado del consumo energético en WSN permite:

- Cuantificar el gasto energético en función de los procesos que realiza un nodo sensor (transmisión de datos, procesamiento, estado de reposo, etc.).
- Predecir la vida útil de los nodos y la duración de la red en distintas condiciones de uso.
- Optimizar el diseño de hardware y software de los nodos para reducir el desperdicio energético.
- Evaluar la efectividad de algoritmos de ahorro de energía antes de su implementación.

Este tipo de modelado se puede realizar a distintos niveles, desde el componente individual (por ejemplo, el consumo de un transceptor inalámbrico) hasta la red completa, analizando el impacto de diferentes protocolos y estrategias de gestión de energía.

A continuación, se presentan los principales enfoques utilizados para modelar el consumo energético en WSN

#### A. Modelado a Nivel de Transceptor

Este enfoque se centra en el consumo de energía asociado a la comunicación inalámbrica, uno de los aspectos más críticos en WSN. Se analiza el impacto de la transmisión y recepción de datos, considerando parámetros como la potencia de transmisión, el tiempo de envío y la modulación utilizada.

Ejemplo de Implementación

Lajara José (2014) estudió modelos teóricos del consumo de energía en redes de sensores enfocándose en el transceptor, considerando factores como el tipo de modulación y la distancia entre nodos. En este modelo, se estima la energía consumida en función de la ecuación de propagación de la señal, lo que permite optimizar la configuración del transceptor para minimizar el gasto energético.

Resultados y Futuras Mejoras

Este tipo de modelado ha permitido desarrollar protocolos MAC de bajo consumo, que ajustan dinámicamente la potencia de transmisión según la distancia y la calidad del canal. Investigaciones futuras buscan integrar aprendizaje automático para optimizar el uso del transceptor en función de las condiciones de la red.

#### B. Modelado a Nivel de Nodo Completo

En este enfoque, el modelado se extiende a todo el nodo sensor, considerando no solo el transceptor, sino también el microcontrolador, los sensores y los sistemas de almacenamiento de energía. Se busca evaluar el impacto del procesamiento de datos y el tiempo de actividad del nodo.

Ejemplo de Implementación

Rojas & Milton (2020) diseñaron un modelo de simulación basado en OPNET, donde analizaron el consumo energético de cada nodo incluyendo CPU, sensores y transceptor, lo que permitió obtener un panorama más completo del gasto de energía en distintas aplicacionesRedes de sensores.

El estudio demostró que el procesamiento local de datos antes de transmitirlos puede reducir hasta un 30% el consumo energético, optimizando el uso del hardware del nodo.

Resultados y Futuras Mejoras

Gracias a estos modelos, se han desarrollado estrategias de duty cycling que desactivan partes del nodo cuando no están en uso, reduciendo significativamente el consumo.

Se están explorando técnicas de computación en el borde (Edge Computing) para descargar tareas pesadas a nodos con mayor capacidad de procesamiento.

#### C. Modelado a Nivel de Red

El modelado a nivel de red se enfoca en evaluar el impacto de la topología, los protocolos de comunicación y las estrategias de enrutamiento en el consumo energético global. Este enfoque es clave para diseñar redes optimizadas en términos de eficiencia energética y cobertura.

Ejemplo de Implementación

Rojas & Milton (2020) también realizaron una evaluación del desempeño energético a nivel de red, midiendo latencia, tráfico de datos y eficiencia del enrutamiento

Se utilizaron simulaciones para probar diferentes protocolos de enrutamiento y su impacto en el consumo de la red en entornos urbanos e industriales.

Resultados y Futuras Mejoras

Este tipo de modelado ha permitido desarrollar protocolos de enrutamiento adaptativos, que seleccionan la mejor ruta de transmisión en función del estado energético de los nodos.

Se están integrando redes neuronales y optimización multiobjetivo para encontrar el equilibrio entre eficiencia energética y calidad de servicio.

### Metodologías de Modelado Energético en Redes de Sensores Inalámbricas

El modelado del consumo energético en redes de sensores inalámbricas (WSN) es un campo de investigación clave para optimizar la eficiencia de estos sistemas. Existen diversas metodologías que permiten estimar, predecir y mejorar el rendimiento energético de los nodos sensores, considerando factores como la topología de la red, los protocolos de comunicación y el hardware utilizado. A continuación, se presentan las principales metodologías empleadas en la literatura para modelar el consumo energético en WSN.

#### A. Modelado Masado en Modelos Analíticos

Los modelos analíticos utilizan ecuaciones matemáticas para describir el consumo energético de un nodo sensor en función de diferentes parámetros, como la potencia de transmisión, el tiempo de actividad y la cantidad de datos enviados.

Ejemplo de Implementación

- Lajara José (2014) propuso un modelo analítico que estima el consumo energético en función de la distancia entre nodos y la potencia de transmisión. Sus ecuaciones permitieron optimizar la selección de rutas en WSN para minimizar el gasto energético.
- Rojas & Milton (2020) desarrollaron un modelo que considera el impacto del protocolo MAC en el consumo energético, mostrando que la eficiencia puede aumentar hasta un 25% si se ajustan los tiempos de activación y reposo de los nodos.

Estos modelos han permitido diseñar protocolos energéticamente eficientes, como S-MAC y T-MAC.

#### B. Modelado Basado en Simulación

Los modelos de simulación permiten replicar el comportamiento de una red de sensores en un entorno virtual, evaluando el consumo energético bajo diferentes condiciones operativas. Se utilizan herramientas como NS-3, OMNeT++, MATLAB y Cooja para simular escenarios de comunicación y analizar el impacto de diferentes configuraciones de red.

Ejemplo de Implementación

- Rojas & Milton (2020) implementaron un modelo de simulación en OPNET, donde evaluaron el consumo energético de los nodos bajo distintos protocolos de comunicación y configuraciones de hardware. Su estudio mostró que el uso de enrutamiento adaptativo puede reducir el consumo hasta en un 30%.

#### C. Modelado Basado en Datos Empíricos

Los modelos empíricos se construyen a partir de mediciones reales de consumo energético en nodos sensores. Este enfoque proporciona resultados altamente precisos, aunque requiere experimentación en entornos reales

Ejemplo de Implementación

- Novelo Sansores (2020b) midió el consumo energético de sensores en un invernadero inteligente, identificando que el uso de protocolos eficientes de transmisión puede extender la vida útil de la batería en un 40%.
- Barker & Swany (2020) realizaron mediciones en nodos sensores con procesadores ARM, mostrando que la delegación de tareas de cómputo a nodos con mayor capacidad puede reducir el consumo energético global.

Las simulaciones basadas en este modelado nos han permitido validar las predicciones de los modelos analíticos y de simulación en entornos reales

Como hemos podido ver, las metodologías de modelado energético en WSN han evolucionado desde enfoques puramente analíticos hasta modelos híbridos que combinan simulaciones y mediciones experimentales. Cada metodología tiene sus ventajas y limitaciones, y su selección depende del nivel de precisión requerido y la disponibilidad de recursos computacionales

# Metodología

## 1. Enfoque de la Investigación

Este proyecto utiliza una metodología mixta, ya que combina enfoques cuantitativos y cualitativos para abordar el problema de optimización energética en redes de sensores inalámbricos (WSN).

### Enfoque Cuantitativo:

- Se mide el impacto energético mediante parámetros objetivos, como el consumo de energía eléctrica, la entrega de paquetes y la potencia de señal.
- Estas métricas son fundamentales para evaluar la eficiencia y efectividad de los algoritmos y protocolos implementados.

### Pruebas de Programación y Comunicación:

- Se crearán y probarán algoritmos y configuraciones dentro de los protocolos de comunicación para evaluar su impacto en el ahorro de energía.

### Pruebas de Hardware:

- Se implementará una fuente de energía que use renovables como el sol y se probará su funcionamiento en diferentes condiciones además de evaluar su funcionalidad y fiabilidad en un entorno real

Al ser experimental, los resultados obtenidos se basan en pruebas reales hechas en un entorno controlado, lo que asegura que las conclusiones sean confiables.

## 2. Selección de la Muestra

Se implementarán tres redes de nodos, separadas por tecnología de comunicación: LoRa, Xbee ZigBee y nRF24L01. Además, se evaluará la eficiencia energética aplicando distintas estrategias dentro de cada tecnología en: Topología de estrella

Cada configuración será sometida a mediciones energéticas y de desempeño para determinar la mejor combinación en términos de consumo y fiabilidad. No se modificará la capa MAC de las tecnologías evaluadas, sino que se analizarán las opciones de ahorro de energía dentro de sus respectivos protocolos.

## 3. Instrumentos y Técnicas de Recolección de Datos

Para la recolección de datos se utilizarán:

- Mediciones de consumo energético: Se emplearán multímetros digitales y sensores de consumo para registrar la corriente y voltaje de los nodos sensores.
- Protocolos de transmisión de datos: Se registrará el consumo asociado a diferentes tecnologías de comunicación (LoRa, LoRaWAN y ZigBee)
- Análisis de algoritmos de gestión energética: Se comparará el impacto de distintos algoritmos de optimización (modos sleep, reducción de frecuencia de transmisión, compresión de datos).
- Registro temporal: Se estimará la autonomía de los nodos en diferentes escenarios de consumo en base a las mediciones realizadas.

## 4. Procedimiento o Desarrollo de la Investigación

El estudio se desarrollará en las siguientes fases:

- Fase 0: Revisión de Documentación y Preparación
  - Investigación sobre redes de sensores inalámbricos (WSN) y optimización energética.
  - Revisión de literatura científica y trabajos previos sobre tecnologías LoRa, ZigBee y estrategias de ahorro energético.
  - Selección y adquisición de herramientas y dispositivos necesarios para la implementación del proyecto.
  - Configuración de entornos de desarrollo y pruebas.
- Fase 1: Evaluación del Consumo Energético Actual
  - Implementación de nodos sensores con baterías convencionales y fuentes renovables en una red convencional.
  - Pruebas de recolección para fuentes renovables.
  - Registro de consumo energético en diferentes condiciones operativas.
  - Comparación de autonomía de los nodos.
- Fase 2: Desarrollo e Implementación de un Algoritmo de Optimización
  - Diseño de un algoritmo para la gestión eficiente de energía.
  - Aplicación de técnicas como modos sleep, reducción de frecuencia de transmisión y optimización del paquete de datos.
  - Medición del impacto del algoritmo en la autonomía de los nodos a través de comparaciones de consumo energético antes y después de su implementación.
- Fase 3: Comparación de Estrategias de Comunicación
  - Pruebas con diferentes protocolos de transmisión en entornos controlados.
  - Análisis comparativo de consumo entre LoRa, nrf24l01 y ZigBee considerando los distintos hardware y considerando sus respectivas opciones de optimización energética.
- Fase 4: Análisis y Conclusiones
  - Procesamiento y análisis de datos
  - Representación de resultados mediante tablas y gráficos estadísticos.
  - Normalización de datos para garantizar comparaciones precisas entre diferentes estrategias.

## 5. Análisis de Datos

El análisis de la información recolectada se llevará a cabo utilizando hojas de cálculo (Microsoft Excel) para consolidar los registros de corriente obtenidos con la instrumentación y los contadores de paquetes extraídos de la memoria EEPROM.

El procesamiento de los datos se realizará mediante las siguientes técnicas:

Cálculo de Eficiencia y Autonomía: Se aplicarán fórmulas de promedio ponderado para determinar el consumo total por ciclo ($I_{prom}$) y extrapolar la duración estimada de la batería en días, basándose en los tiempos medidos de actividad y reposo1111.

Evaluación de Fiabilidad: Se calculará la Tasa de Entrega de Paquetes (PDR) y el porcentaje de pérdidas mediante la comparación aritmética entre los contadores de transmisión y recepción almacenados en los nodos2222.

Visualización: Los resultados se presentarán mediante gráficos de barras para comparar el consumo y la autonomía entre las distintas configuraciones, y diagramas de caja (Boxplots) para evaluar la estabilidad y dispersión de los protocolos de comunicación3333

## 6. Validez y Confiabilidad

Para garantizar la validez de la investigación:

- Se realizarán pruebas controladas en entornos replicables.
- Se calibrarán los equipos de medición antes de cada prueba.
- Se ejecutarán experimentos repetidos para asegurar la consistencia de los resultados.
- Se realizarán mediciones en entornos donde tengamos permiso.

## 7. Consideraciones Éticas

- Se documentará el procedimiento de manera clara y transparente.
- Se garantizará el uso responsable de la energía en los experimentos, evitando el desperdicio innecesario.
- El despliegue de las redes de sensores se realizará en áreas públicas de uso libre

Con esta metodología, se espera proporcionar una solución eficiente para la gestión de energía en redes de sensores inalámbricas, optimizando su autonomía y funcionalidad en entornos reales.

# Descripción de las actividades realizadas

## Adquisición de conocimiento y Desarrollo de prototipos básicos

Antes de proceder con el diseño y la implementación de la red de sensores mejorada, se determinó que era fundamental llevar a cabo una fase exhaustiva de investigación y experimentación. Esta etapa preliminar tuvo como objetivo principal no solo la comprensión teórica de las tecnologías implicadas, sino también la adquisición de experiencia práctica en su manipulación y configuración. Para ello, el trabajo se estructuró en torno al desarrollo de una serie de prototipos funcionales, cada uno enfocado en un aspecto tecnológico clave del proyecto.

Prototipo I: Control y Modulación de Señales

El punto de partida fue la familiarización con la plataforma de desarrollo Arduino. El primer prototipo consistió en un circuito básico para el control de actuadores mediante la modulación por ancho de pulso (PWM). Se implementó un sistema que permitía variar la intensidad lumínica de un diodo LED de alta potencia y la velocidad de un pequeño motor de corriente continua. Este ejercicio práctico fue crucial para comprender cómo los microcontroladores pueden generar señales analógicas simuladas a partir de salidas digitales, un concepto esencial para la gestión de diversos tipos de sensores y actuadores en el sistema final. Los conocimientos adquiridos sentaron las bases para el manejo preciso de componentes que no operan con señales binarias de encendido/apagado.

Prototipo II: Comunicación Serial y Transmisión de Datos GPS

Una vez dominados los conceptos básicos, se procedió a explorar la comunicación entre microcontroladores. Para este fin, se diseñó un prototipo compuesto por dos placas Arduino. La primera, actuando como nodo emisor, fue equipada con un módulo GPS. Su función era adquirir las coordenadas geográficas (latitud y longitud) del sistema satelital y transmitirlas en tiempo real. La segunda placa, el nodo receptor, recibía esta información a través de una comunicación serial (UART) y la mostraba en un monitor serial.

Este desarrollo permitió profundizar en los protocolos de comunicación punto a punto, comprendiendo la importancia de la configuración de parámetros como la velocidad en baudios (baud rate) y la estructura de las tramas de datos para asegurar una transmisión fiable. Se enfrentó un desafío inicial relacionado con el parsing (análisis sintáctico) de las sentencias NMEA que entrega el módulo GPS, lo que obligó a desarrollar un pequeño algoritmo para aislar y convertir los datos de coordenadas a un formato numérico utilizable. Esta experiencia fue fundamental para el posterior manejo de flujos de datos provenientes de múltiples sensores.

Prototipo III: Almacenamiento Local y Gestión de Ficheros

Con el objetivo de asegurar la integridad de los datos ante posibles fallos de comunicación, se investigó el uso de sistemas de almacenamiento local. Se construyó un prototipo que integraba un Arduino con un adaptador para tarjetas micro SD. El objetivo fue implementar un sistema de registro de datos (datalogger) básico. Se desarrollaron funciones específicas para crear, escribir y leer archivos de texto (.txt) en la tarjeta de memoria.

Durante esta fase, se presentó un problema recurrente: la corrupción de archivos al interrumpir la alimentación del circuito mientras se realizaba una operación de escritura. Este inconveniente nos enseñó la importancia de implementar mecanismos de seguridad en el código, como el cierre explícito de los archivos después de cada escritura y la verificación de la correcta inicialización de la tarjeta SD al arrancar el sistema. Se logró así un entendimiento práctico sobre la gestión de sistemas de ficheros y la persistencia de datos, un requisito indispensable para el respaldo de información en los nodos de la red.

3.1.4 Prototipo IV: Intercomunicación entre Plataformas Heterogéneas (Arduino y ESP32)

Finalmente, para evaluar la interoperabilidad entre diferentes tecnologías, se abordó la comunicación entre una placa Arduino y un microcontrolador ESP32. Este último fue considerado por sus capacidades de conectividad Wi-Fi y Bluetooth. Se estableció una comunicación bidireccional utilizando el protocolo I2C, donde el ESP32 actuaba como maestro y el Arduino como esclavo.

El principal reto técnico en este prototipo fue la diferencia en los niveles lógicos de voltaje entre ambas placas (5V para el Arduino Uno y 3.3V para el ESP32). Una conexión directa podría haber dañado el ESP32, por lo que fue necesario investigar e implementar un convertidor de nivel lógico bidireccional para adaptar las señales de los buses I2C. La resolución de este problema proporcionó un aprendizaje invaluable sobre la importancia de la compatibilidad de hardware en sistemas embebidos y las soluciones de interfaz necesarias para integrar componentes con distintas especificaciones técnicas. Esta fase consolidó los conocimientos sobre protocolos de comunicación más complejos y preparó al equipo para la integración final de todos los subsistemas del proyecto.

## Generación de un prototipo base para mejorar

Para el desarrollo de este proyecto, se decidió no empezar completamente desde cero. En lugar de eso, tomamos como punto de partida un sistema de monitoreo y control de energía ya existente y funcional, el cual fue diseñado e implementado por Zamora (2017). La idea fue utilizar su trabajo, que ya había sido probado en un laboratorio, como la base sobre la cual nosotros construiríamos nuestras mejoras, un pequeño diseño de esto se puede ver en la Ilustración 1. Diseño del nodo sensor. Reimpreso de Zamora (2017, p. 89)

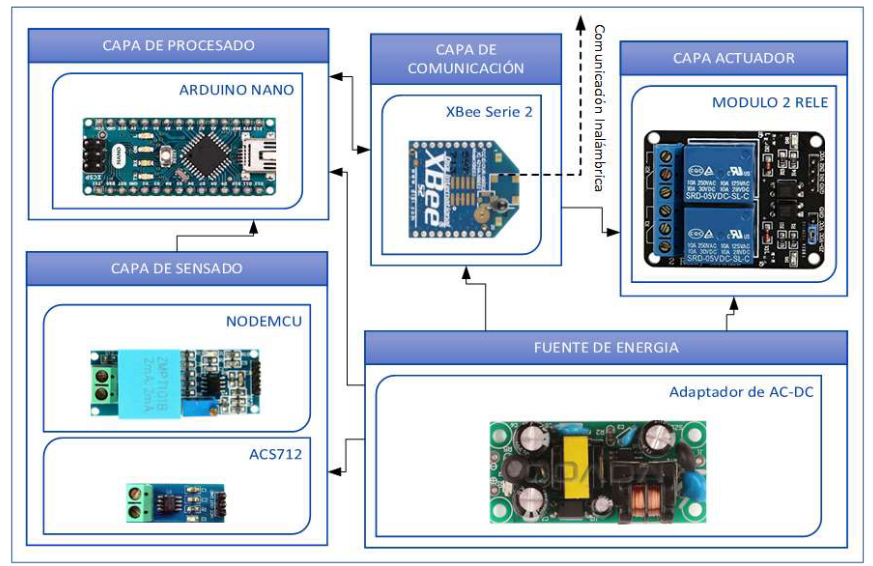
[picture p6: figure]

Ilustración 1. Diseño del nodo sensor. Reimpreso de Zamora (2017, p. 89)

El sistema original en el que nos basamos es una solución bastante completa para medir y controlar el consumo eléctrico. Su funcionamiento se puede resumir así:

Hay un nodo sensor, construido con un Arduino, que usa sensores específicos para medir en tiempo real el voltaje y la corriente de un circuito.

Toda la información que recoge este nodo se envía de forma inalámbrica a un nodo coordinador. Este segundo Arduino recibe los datos, los procesa y, si detecta alguna anomalía o un consumo fuera de lo normal, puede tomar una decisión.

Para la comunicación entre ellos, el sistema utiliza módulos XBee, que son una tecnología confiable y de bajo consumo.

Finalmente, el nodo coordinador puede controlar un relevador para cortar o permitir el paso de la corriente, protegiendo así el equipo conectado.

La razón principal para usar este trabajo como base fue muy práctica: ya se había demostrado que funcionaba. Al ser un sistema implementado en un entorno real, nos proporcionaba una plataforma validada y estable. Esto nos permitió saltarnos toda la fase inicial de diseño conceptual y las pruebas de viabilidad, dándonos la seguridad de que la idea central era sólida y real.

Por todo esto, nuestro enfoque no fue replicar lo que ellos ya hicieron, sino tomar ese sistema funcional como un cimiento robusto para atacar un problema fundamental: la gestión energética. Planeamos generar mejoras energéticas en cuanto a consumo de batería, autonomía de los nodos y técnicas de recolección de energía, no solo para este sistema, sino con la intención de que sean soluciones más genéricas. El objetivo final es ayudar a que las redes de sensores que otras personas desarrollen puedan ser más eficientes energéticamente y alcanzar una mayor autonomía.

Aunque el documento de Zamora fue una excelente guía que nos permitió entender a fondo el diseño y el funcionamiento de su hardware, no incluía el código fuente. Esto significó que, para poder replicar el sistema, tuvimos que desarrollar todo el software desde cero. Este desafío, si bien fue grande, nos obligó a comprender a un nivel mucho más profundo la lógica de programación tanto del nodo sensor como del nodo coordinador. Tuvimos que escribir las rutinas para la lectura de los sensores, el procesamiento de los datos, el empaquetado de la información y toda la lógica de control del relevador.

Paralelamente al desarrollo del software, nos enfrentamos al reto logístico de conseguir los componentes físicos. Armar nuestros propios nodos implicó un proceso de búsqueda y compra de cada una de las piezas. Tuvimos que navegar por diversas páginas y proveedores en línea para encontrar los modelos exactos de los sensores de voltaje y corriente, las placas Arduino, los relevadores y, afortunadamente, los módulos de comunicación XBee no tuvimos que adquirirlos por nuestra cuenta ya que nos fueron proporcionados por el Asesor Agustín Esquivel. Este proceso fue fundamental para familiarizarnos con el hardware que estaríamos utilizando.

Selección y Gestión de la Fuente de Alimentación Autónoma

Dado que el objetivo central del proyecto es la autonomía energética, un paso fundamental fue seleccionar una fuente de alimentación para los nodos que fuera extraíble y recargable. Decidimos utilizar baterías de ion de litio del tipo 18650 por varias razones estratégicas:

- Alta Densidad Energética: Ofrecen una excelente capacidad de almacenamiento de energía en relación con su tamaño y peso, ideal para mantener los nodos compactos.
- Larga Vida Útil: Son recargables y soportan cientos de ciclos de carga y descarga, lo que las hace una opción sostenible y económica a largo plazo.
- Voltaje Estable: Proporcionan un voltaje de salida relativamente constante durante la mayor parte de su ciclo de descarga, lo cual es beneficioso para la estabilidad de los microcontroladores y sensores.
- Estándar de la Industria: El formato 18650 es un estándar global, lo que garantiza su disponibilidad y una amplia gama de accesorios compatibles.

Trabajar con baterías de ion de litio requiere precaución, especialmente durante la carga. Para manejar esto de forma segura y eficiente, en lugar de integrar un circuito de carga en cada nodo sensor, optamos por construir una estación de carga externa. Como se aprecia en la Figura 1, esta estación utiliza varios módulos de carga TP4056 para recargar múltiples baterías 18650 de forma simultánea. Este enfoque nos permite tener siempre un juego de baterías listas para ser intercambiadas en los nodos desplegados, simplificando el mantenimiento en campo. Fue necesario estudiar el funcionamiento de los módulos TP4056 para comprender su perfil de carga y sus mecanismos de protección, garantizando así un manejo seguro y que prolongue la vida útil de las baterías.

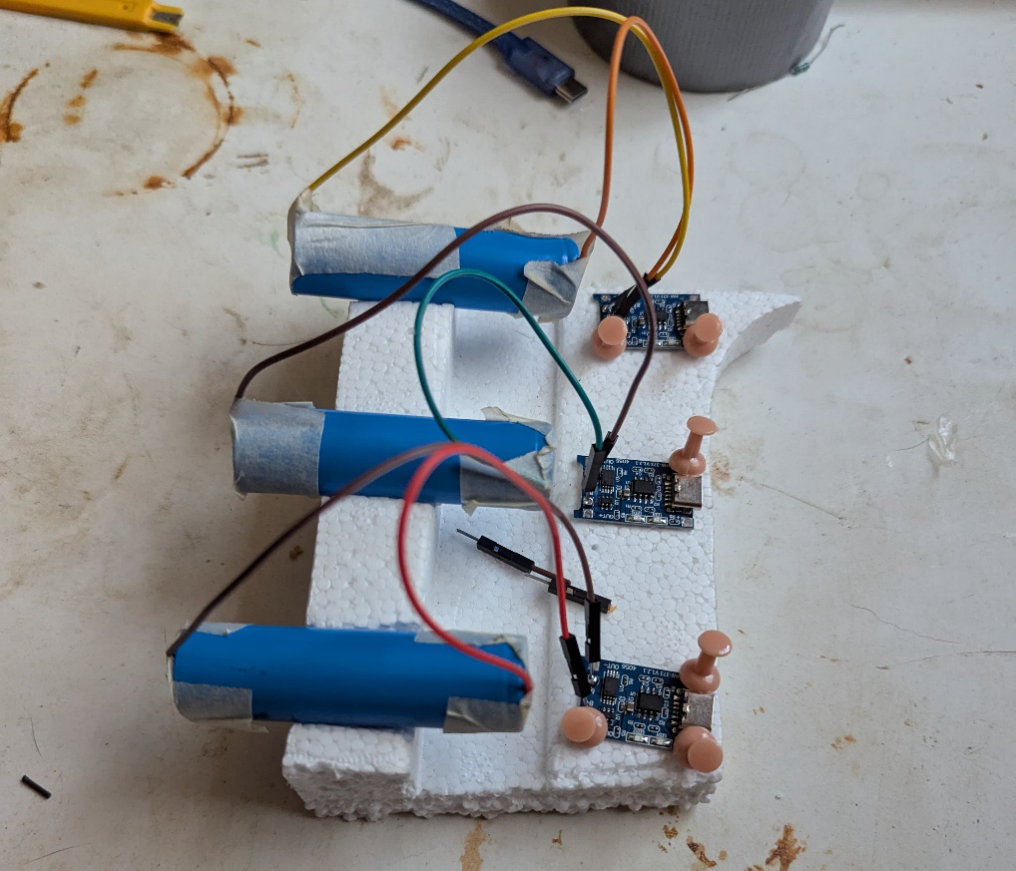
[picture p7: figure]

Ilustración 2. Módulo de carga de las baterías

Aprendizaje y Configuración de los Módulos XBee

Una vez que tuvimos los componentes, el primer gran obstáculo técnico fue la comunicación inalámbrica. Para empezar a trabajar, nos enfocamos en aprender a usar los módulos XBee, que son el corazón de la red. Esto requirió una inmersión profunda en su documentación, que es bastante extensa y compleja además de confusa ya que muchas versiones de firmware están descontinuadas, la documentación es algo ambigua y muchas veces lo que menciona no se relaciona al pie de la letra con la práctica.

El principal reto fue aprender a manejar XCTU, el software de configuración oficial de Digi. Al principio, peleamos mucho con la configuración; los módulos simplemente no se comunicaban entre sí. Pasamos bastante tiempo probando diferentes ajustes, entendiendo conceptos como el PAN ID (el identificador de la red), las direcciones de los módulos y los roles de "Coordinador" y "Router/End Device" (como se puede ver en la Ilustración 3. Configuración del End Device en XCTU) además de las topologías de red disponibles. Nos costó bastante lograr que establecfieran un enlace estable.

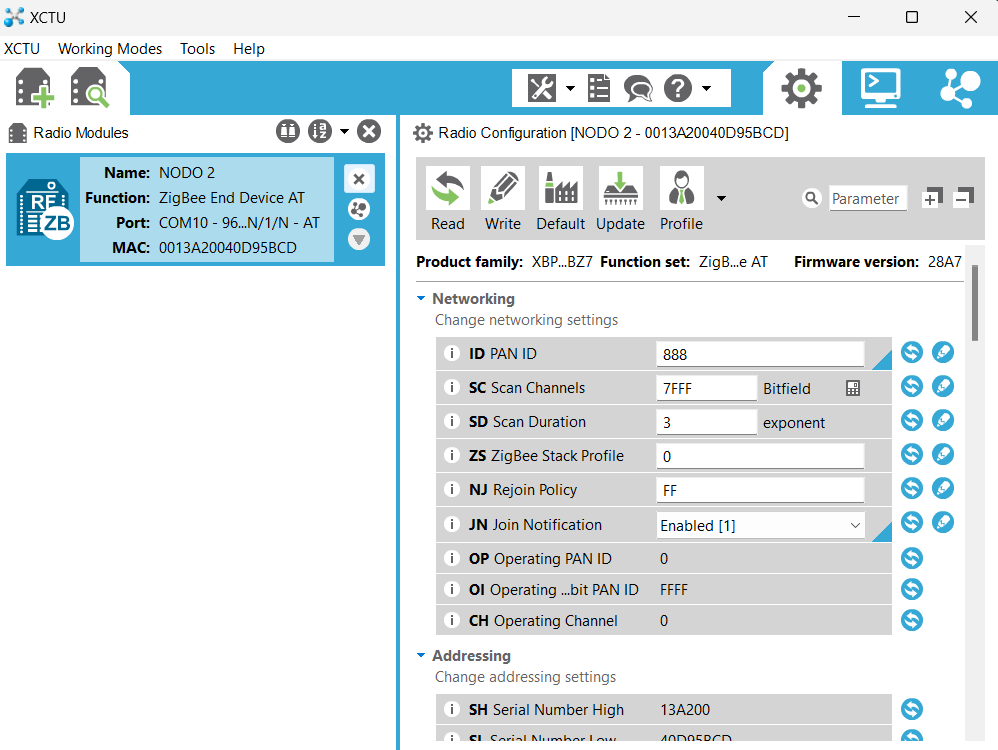
[picture p8: figure]

Ilustración 3. Configuración del End Device en XCTU

Finalmente, después de muchos intentos de prueba y error, logramos que se comunicaran. Las primeras pruebas exitosas las hicimos directamente con la consola integrada en el software XCTU., enviábamos un simple "hola" desde un módulo y veíamos cómo aparecía en la consola del otro, esto se puede apreciaren la . Ver ese mensaje llegar fue un gran avance, ya que nos confirmó que la configuración de la red era correcta y que estábamos listos para pasar a la siguiente fase: conectar los módulos a los Arduinos para empezar a enviar datos reales.

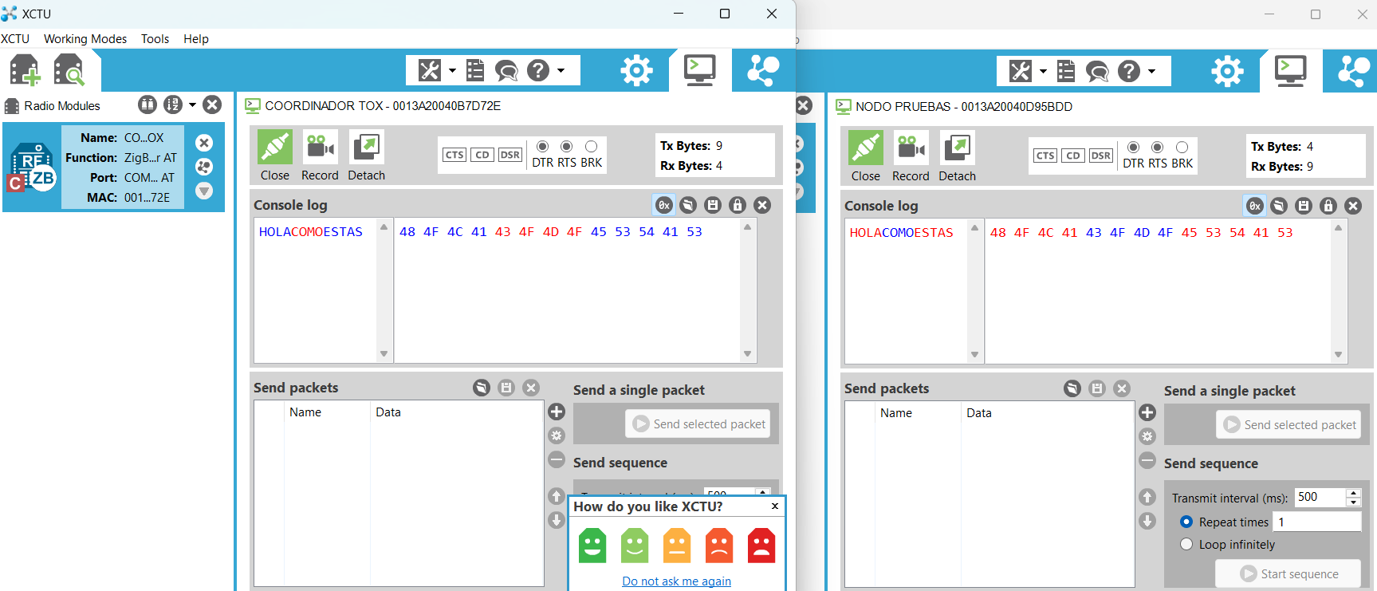
[picture p9: figure]

Ilustración 4. Prueba de comunicación entre los nodos desde XCTU

Con la comunicación inalámbrica ya resuelta, el siguiente y último paso de esta fase fue conectar todas las piezas. Integramos los módulos XBee con sus respectivas placas Arduino, conectamos los sensores de voltaje y corriente al nodo esclavo, y el módulo relevador al nodo coordinador. Cargamos el código que habíamos desarrollado desde cero en cada uno de los microcontroladores y procedimos a encender el sistema completo.

Realizamos pruebas simples para verificar que todo funcionara como un conjunto. Primero, programamos el nodo sensor para que leyera un valor y lo enviara al coordinador. Con el monitor serial abierto en el computador conectado al coordinador, esperamos y, efectivamente, vimos llegar el primer paquete de datos. Luego, enviamos un comando simple desde el coordinador al esclavo para activar y desactivar el relevador, y escuchamos el satisfactorio "clic" que confirmaba que la orden se había ejecutado correctamente.

El proceso de integración fue algo lento y metódico, ya que íbamos verificando cada conexión y cada parte del código paso a paso. Afortunadamente, no tuvimos demasiados problemas inesperados en esta etapa, en gran parte gracias a todo el trabajo previo de prototipado y configuración. Con el sistema base finalmente replicado y funcionando de manera estable, habíamos alcanzado nuestro primer gran objetivo. Ahora, con una plataforma operativa en nuestras manos, podíamos por fin pasar a la fase principal del proyecto: empezar a trabajar de verdad en las mejoras y optimizaciones que nos habíamos propuesto.

## Análisis de mejoras a realizar

Una vez que tuvimos una réplica funcional del sistema base, el siguiente paso fue realizar un análisis crítico para identificar sus debilidades y las oportunidades de mejora. Con un sistema estable en nuestras manos, podíamos experimentar y evaluar su rendimiento de manera objetiva. Este análisis se abordó desde tres perspectivas complementarias: el software, el hardware y la sinergia entre ambos. El objetivo era definir varias "rutas de ataque" claras para optimizar el sistema, enfocándonos principalmente en la eficiencia energética y la autonomía.

Análisis desde la Perspectiva del Software

El código que desarrollamos, aunque cumplía su función, fue una primera versión escrita con el objetivo de replicar la lógica del sistema original. Al analizarlo, identificamos un amplio margen para la optimización. El análisis se centró en la posibilidad de reescribir partes clave del código para hacerlo más eficiente. A grandes rasgos, se concluyó que podíamos reducir el consumo de recursos del microcontrolador mediante códigos más optimizados, por ejemplo, utilizando tipos de variables más eficientes, implementando rutinas de bajo consumo y minimizando las operaciones innecesarias para que el procesador estuviera activo el menor tiempo posible.

Análisis desde la Perspectiva del Hardware

Desde el punto de vista del hardware, el análisis se enfocó en evaluar los componentes del diseño original frente a las alternativas más modernas disponibles en el mercado. Si bien los componentes base como el Arduino UNO y los módulos XBee son confiables, la tecnología ha avanzado. Identificamos que la ruta de mejora más prometedora era la selección de hardware más eficiente. Esto implicaba buscar microcontroladores con un consumo energético mucho menor en estados activos y de reposo, así como sensores y módulos de comunicación diseñados específicamente para aplicaciones de bajo consumo (IoT) además de hardware auxiliar de menor consumo.

Análisis de la Sinergia Hardware-Software

Finalmente, entendimos que las mejoras más impactantes no vendrían de optimizar el software y el hardware por separado, sino de hacerlos trabajar en conjunto de una manera más inteligente. Este análisis definió la ruta de ataque principal del proyecto: aprovechar las características de un hardware de bajo consumo mediante software diseñado específicamente para ello. Por ejemplo, de nada serviría tener un microcontrolador con modos de sueño profundo (una característica de hardware) si el software no está programado para utilizarlos correctamente. De esta forma, definimos que la estrategia general sería seleccionar primero un hardware superior y luego desarrollar un software a medida que explotara al máximo sus capacidades de ahorro energético.

## Mejoras al hardware

Para mejorar la capacidad de diagnóstico y seguimiento del sistema, se incorporó un módulo de tarjeta micro SD en el nodo coordinador y también en el nodo sensor. Esta adición nos permite implementar un sistema de registro de eventos o "logs". Cada vez que el coordinador recibe datos, realiza una acción importante o detecta un error, puede escribir una entrada en un archivo de texto dentro de la tarjeta de memoria. De esta manera, si algo falla, tenemos un historial detallado para revisar qué salió mal y en qué momento, facilitando enormemente la depuración y el análisis del comportamiento del sistema a lo largo del tiempo.

### Actualización de Microcontroladores: Arduino Nano para el Sensor y ESP32 para el Coordinador

Para comenzar con la optimización del hardware, una de las decisiones más importantes fue reemplazar los microcontroladores Arduino UNO que usamos para replicar el sistema base. Aunque son excelentes para prototipar, no son la opción más eficiente en términos de tamaño y capacidades para un sistema final. Por ello, seleccionamos dos placas diferentes y más adecuadas para las tareas específicas de cada nodo.

Nodo Sensor: Adopción del Arduino Nano

Para el nodo encargado de tomar las mediciones, cambiamos el Arduino UNO por un Arduino Nano. La razón principal fue la reducción drástica de tamaño. El Nano utiliza el mismo microcontrolador que el UNO (el ATmega328P), por lo que tiene prácticamente la misma capacidad de procesamiento y el mismo número de pines que necesitábamos. Esto significó que podíamos migrar nuestro código sin hacer grandes cambios.

La ventaja es puramente física, pero muy relevante: al ser mucho más compacto, el Arduino Nano nos permite diseñar un nodo sensor final mucho más pequeño y discreto, más fácil de instalar en cualquier lugar. Para un dispositivo que funcionará con baterías, reducir el tamaño y el peso es un paso clave hacia un diseño más eficiente y práctico.

Nodo Coordinador: Potenciando con el ESP32

El cambio más significativo se realizó en el nodo coordinador. Reemplazamos el Arduino UNO por una placa de desarrollo ESP32. Esta decisión fue estratégica y abrió un abanico de nuevas posibilidades para el proyecto. Mientras que el Arduino Nano fue una mejora de forma, el ESP32 fue una mejora de capacidades y futuro.

Las ventajas de usar un ESP32 como coordinador son enormes:

Potencia de Procesamiento: El ESP32 es un microcontrolador de doble núcleo y mucho más rápido que el de un Arduino. Esto le da la capacidad de procesar la información de varios nodos sensores simultáneamente, realizar cálculos más complejos en tiempo real y gestionar múltiples tareas sin despeinarse.

Conectividad Integrada: Esta es la mejora clave. El ESP32 tiene Wi-Fi y Bluetooth incorporados de fábrica. Esto elimina la dependencia exclusiva de la red XBee para comunicarse con el mundo exterior. Ahora, nuestro nodo coordinador puede conectarse directamente a una red Wi-Fi y, por lo tanto, a Internet, gracias a la conexión a Internet, podemos implementar funcionalidades que eran impensables con el diseño original.

En resumen, al asignar un Arduino Nano al nodo sensor, optimizamos el tamaño y la eficiencia para una tarea simple. Al asignar un ESP32 al nodo coordinador, le dimos al sistema un cerebro mucho más potente y, lo más importante, una puerta de acceso al Internet de las Cosas (IoT), preparando el proyecto para futuras expansiones.

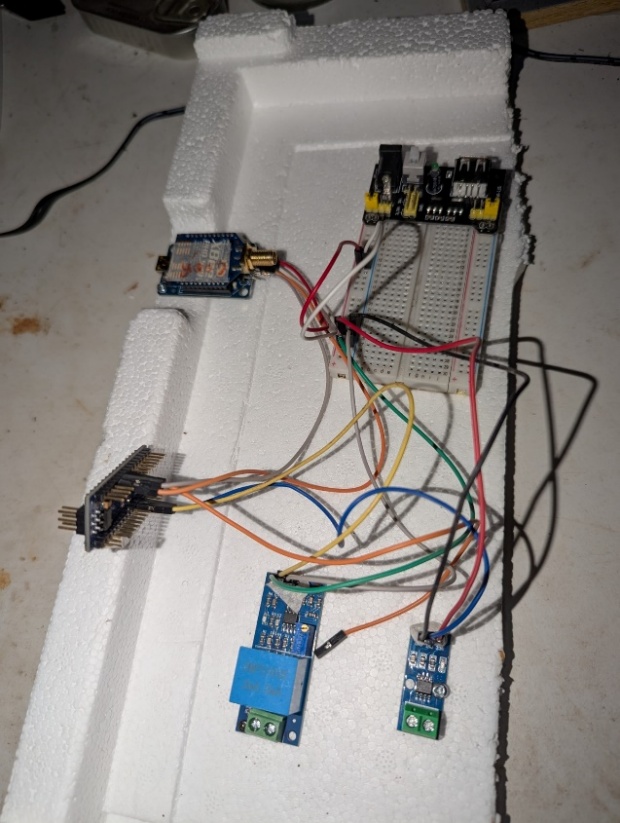
[picture p10: figure]

Ilustración 5. Nodo Sensor

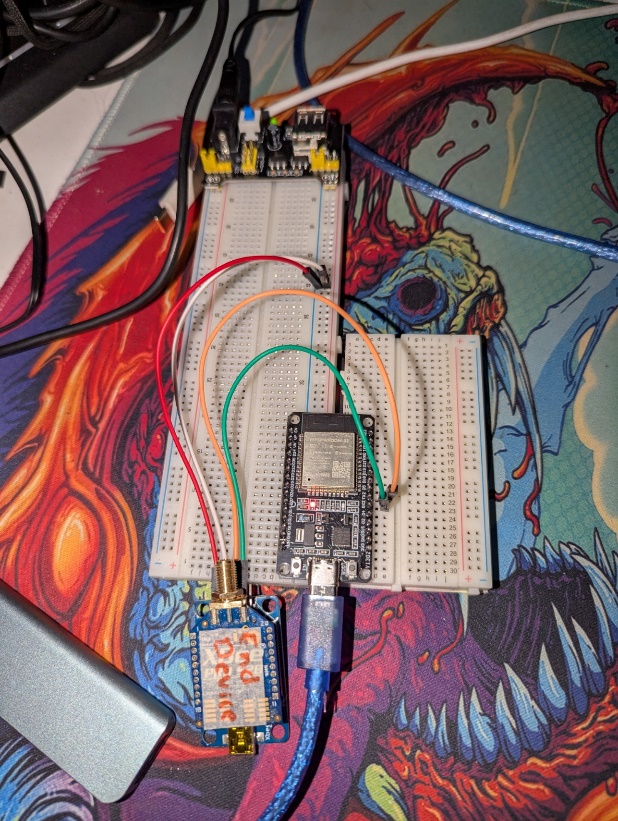
[picture p11: figure]

Ilustración 6. Nodo con Esp32

Después de seleccionar los nuevos componentes, el diseño final de nuestros dispositivos y sus conexiones quedó definido. En la Ilustración 5. Nodo Sensor se puede ver una foto del prototipo del nodo sensor ya armado, el cual montamos sobre una placa de unicel para mantener todo en su lugar durante las pruebas; todos sus componentes y conexiones se detallan en la Tabla 1. Pines actualizados del nodo sensor con Arduino Nano. A su vez, el montaje final del nodo coordinador con el ESP32 como su pieza central se muestra en la Ilustración 6. Nodo con Esp32, mientras que sus respectivas conexiones y componentes se pueden consultar en la Tabla 2. Pines actualizados del nodo Coordinador con Esp32.

Pin lado A | Pin lado B | Notas
Adaptador Xbee TX (DOUT) | Arduino Nano Pin D2
Adaptador Xbee RX (DIN) | Arduino Nano Pin D3
Adaptador Xbee VCC | Fuente de alimentación 5V
Adaptador Xbee GND | GND de Fuente
ACS712 OUT | Arduino nano Pin A0
ACS712 VCC | Fuente de alimentación 5V
ACS712 GND | GND de Fuente
ZMPT101B OUT | Arduino Nano Pin A1
ZMPT101B VCC | Fuente de alimentación 5V
ZMPT101B GND | GND de Fuente
Relay IN | Arduino Nano Pin D4
Relay VCC | Fuente de alimentación 5V
Relay GND | GND de Fuente

Tabla 1. Pines actualizados del nodo sensor con Arduino Nano

Pin lado A | Pin lado B | Notas
Adaptador Xbee TX 2(DOUT) | ESP32-WROOM-32 GPIO16 (RX2) | Entrada de datos al ESP32
Adaptador Xbee RX 3 (DIN) | ESP32-WROOM-32 GPIO17 (TX2) | Salida de órdenes desde el ESP32
Adaptador Xbee VCC | Fuente de alimentación 5V | El adaptador aguanta 5v
Adaptador Xbee VCC | GND de Fuente

Tabla 2. Pines actualizados del nodo Coordinador con Esp32

### Actualización de la Fuente de Alimentación

El siguiente punto de ataque para mejorar la eficiencia del sistema fue, lógicamente, la gestión de la energía. En cualquier dispositivo alimentado por baterías, el componente que se encarga de regular el voltaje es crítico, ya que un mal diseño en esta etapa puede desperdiciar una cantidad enorme de energía. Por ello, nuestra primera mejora estratégica fue reemplazar la fuente de alimentación original por una solución mucho más moderna y eficiente.

Del Regulador Lineal (MB102) al Regulador Conmutado (MP1584)

El Módulo Original: MB102

En prototipos iniciales y en muchos proyectos básicos, es común usar fuentes de alimentación como la MB102. Este módulo se basa en un regulador de voltaje lineal (generalmente el AMS1117). Para entender por qué es ineficiente, hay que saber cómo funciona: un regulador lineal toma un voltaje de entrada más alto (por ejemplo, 9V de una batería) y lo reduce al voltaje de salida deseado (por ejemplo, 5V para el Arduino). Para lograr esto, disipa la diferencia de voltaje (en este caso, 4V) en forma de calor, este se puede apreciar de mejor manera en la Ilustración 7. Regulador MB102.

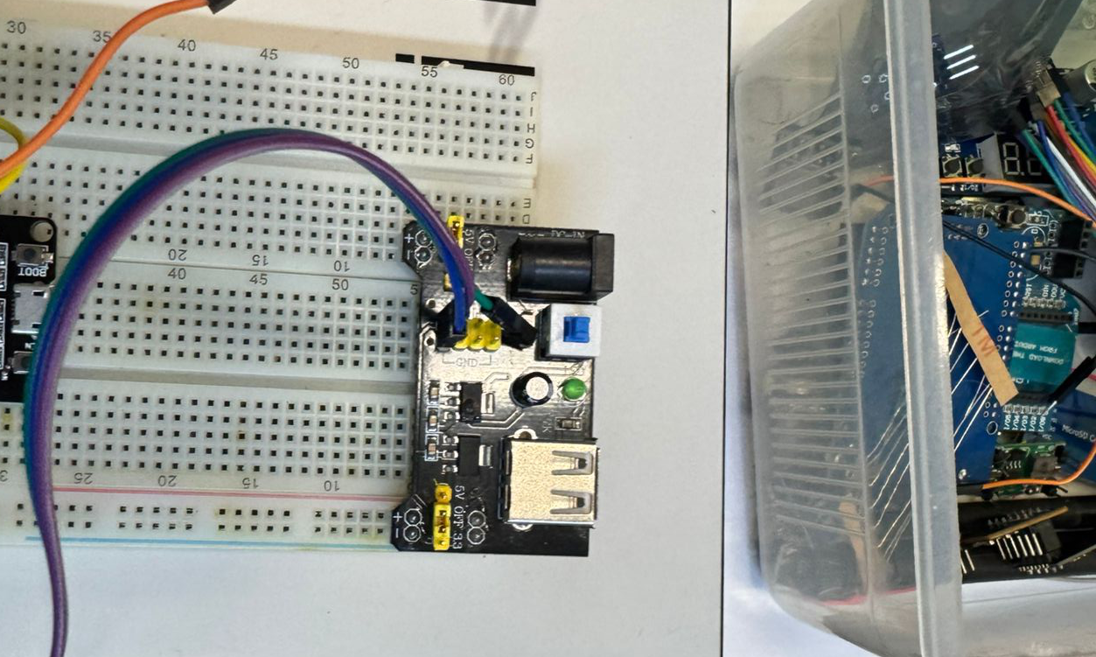
[picture p12: figure]

Ilustración 7. Regulador MB102

Este proceso es increíblemente derrochador. Es como si para llenar un vaso de agua tuvieras una manguera abierta al máximo y usaras una esponja para absorber todo el exceso que no cabe en el vaso. La esponja se calienta y el agua (la energía) se desperdicia. En nuestro sistema, esto significa que una parte considerable de la preciosa carga de la batería se convierte directamente en calor inútil, reduciendo drásticamente la autonomía del nodo antes de que la energía llegue siquiera al microcontrolador. Cuanto mayor es la diferencia entre el voltaje de la batería y el voltaje que necesita el dispositivo, más energía se desperdicia.

La Solución Mejorada: Módulo Regulador MP1584

Para solucionar este grave problema de ineficiencia, reemplazamos el MB102 por un módulo basado en el chip MP1584EN. Este componente es un regulador de voltaje conmutado, específicamente un convertidor "buck" o reductor. Su forma de trabajar es radicalmente diferente y mucho más inteligente.

En lugar de quemar el exceso de energía, un regulador conmutado funciona encendiendo y apagando un interruptor interno a una frecuencia muy alta (cientos de miles de veces por segundo). Al hacer esto, transfiere pequeños paquetes de energía desde la fuente a un circuito de almacenamiento (compuesto por un inductor y un capacitor), que suaviza estos pulsos para entregar un voltaje de salida constante y estable.

La gran ventaja de este método es su altísima eficiencia, que a menudo supera el 90%. Esto significa que casi toda la energía que se extrae de la batería se entrega efectivamente al dispositivo. Volviendo a la analogía, es como usar un grifo que se abre y se cierra rápidamente para dejar pasar solo la cantidad exacta de agua que necesitas. El desperdicio es mínimo. Para nuestro proyecto, este cambio es fundamental, ya que se traduce directamente en una mayor duración de la batería y, por lo tanto, en una mayor autonomía para nuestros nodos sensores.

Además, el módulo MP1584 es regulable. Viene con un pequeño potenciómetro que nos permite ajustar con precisión el voltaje de salida que necesitamos. Esta característica nos da una flexibilidad enorme, ya que podemos alimentar el módulo con una amplia gama de fuentes de energía (por ejemplo, un pack de baterías de 7.4V, una de 12V, o incluso un pequeño panel solar) y ajustar la salida para que sea exactamente de 5V para un Arduino o de 3.3V para un ESP32. Esta versatilidad hace que nuestro diseño no solo sea más eficiente, sino también mucho más adaptable a diferentes escenarios y tipos de baterías lo que nos es muy práctico debido a la naturaleza de hardware cambiante del proyecto

Este cambio de hardware no cambia en nada a nuestros pines más allá de cambiar la entrada de voltaje por lo tanto no fue necesario realizar la tabla de cableado nuevamente como se puede ver en la Ilustración 8. Módulo MP1584 implementado en nuestros nodos.

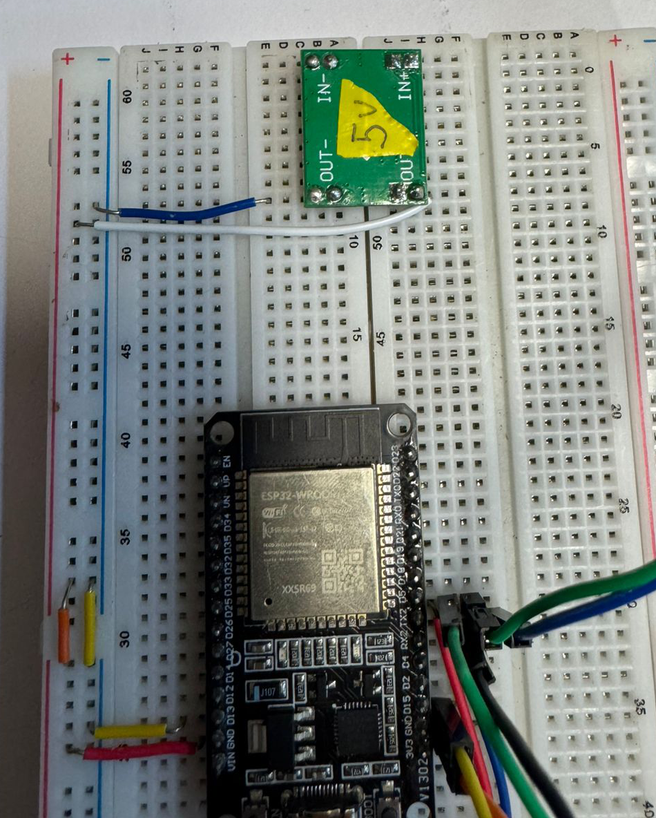
[picture p13: figure]

Ilustración 8. Módulo MP1584 implementado en nuestros nodos

Una mejora adicional, aunque parezca menor, tuvo un gran impacto en la fiabilidad de nuestros montajes de prueba. Decidimos reemplazar los cables Dupont flexibles tradicionales, que suelen colgar y crear un desorden en la protoboard, por jumper wires de alambre sólido. Estos cables, al ser rígidos, se insertan directamente y quedan pegados a la superficie de la protoboard. Este cambio nos facilitó enormemente el trabajo, ya que el circuito se volvió mucho más limpio y fácil de revisar. Lo más importante es que es mucho más difícil que se desconecten accidentalmente, eliminando falsos fallos durante las pruebas y haciendo todo el proceso de prototipado más rápido y seguro, apareciendo estos cambios en la Ilustración 9. Prototipo con regulador MP1584 y jumpers wires.

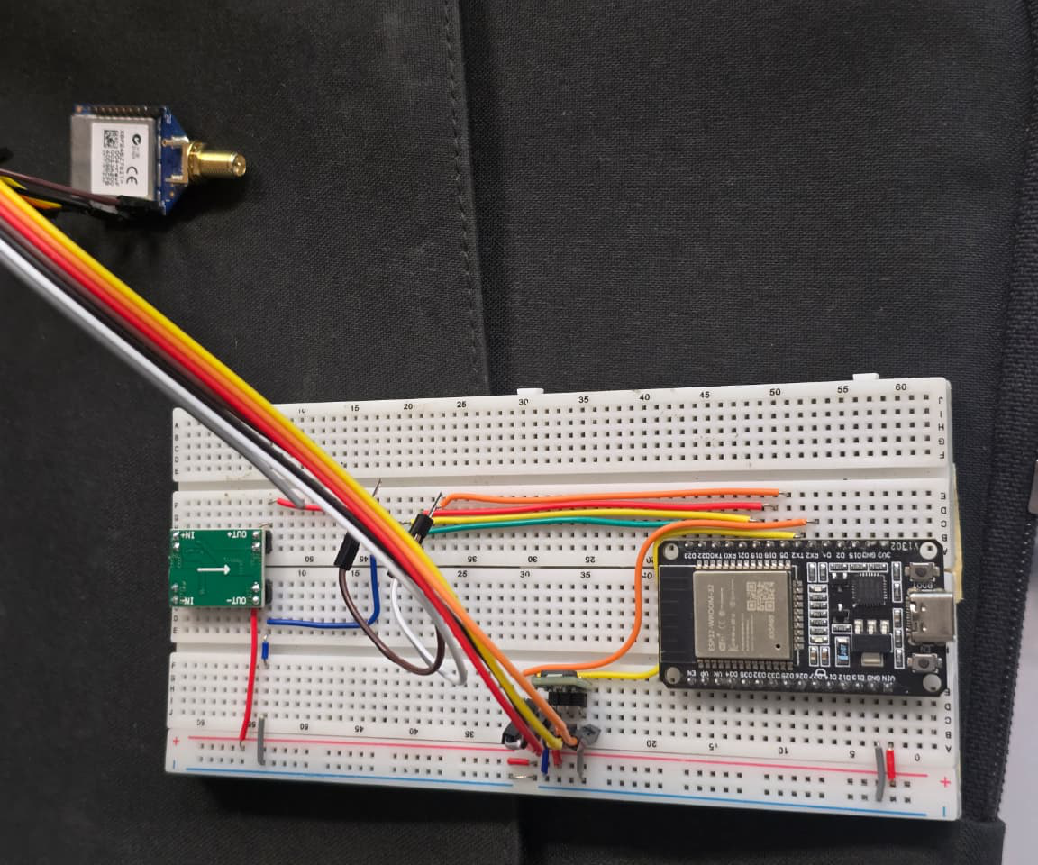
[picture p14: figure]

Ilustración 9. Prototipo con regulador MP1584 y jumpers wires

## Mejoras al Software

En cuanto al software, que era el área donde sentíamos que teníamos mayor capacidad para expandir el proyecto, comenzamos a trabajar directamente sobre nuestros códigos iniciales. Sin embargo, pronto nos dimos cuenta de que este enfoque no iba a funcionar. De nada sirve hacer una mejora si solo funciona para nuestro caso particular; la idea era crear algo que pudiera ser útil para otras personas y que se pudiera adaptar a otras redes de sensores. El objetivo es que el código sea reciclable, no que otros tengan que empezar desde cero. Por eso, decidimos cambiar de estrategia y optamos por desarrollar nuestras mejoras en formato de librería.

Para poder hacer esto, primero fue necesario aprender cómo funciona el ecosistema de Arduino a un nivel más profundo, específicamente cómo se manejan sus librerías, cómo se accede a ellas desde el código y cómo funciona la propia indexación del IDE. Una vez que dominamos esa parte técnica, pasamos a la fase de empezar a escribir el código de nuestra nueva librería.

### Desarrollo de la Librería CodecWSN

Basándonos en los principios de optimización en la transmisión de datos, como los analizados por Barker & Swany (2020) sobre la compresión de mensajes en comunicaciones, hemos desarrollado la librería “CodecWSN”. Si bien el artículo de Pedro nos brindó un marco teórico sobre la importancia de la eficiencia en la comunicación, la estrategia específica de compactación de datos para nuestra red de sensores inalámbricos (WSN) fue una iniciativa propia. El objetivo principal de “CodecWSN” es transformar la información de los sensores (ID, voltaje, corriente y voltaje de batería) a un formato binario compacto, minimizando el tamaño de los datos a transmitir y, por ende, optimizando todo el proceso de comunicación.

La estrategia central de nuestra librería es la serialización directa de los datos a un formato binario de tamaño fijo. En lugar de enviar la información como texto plano (ASCII), que es ineficiente y verboso, “CodecWSN” convierte las mediciones en una estructura de solo 8 bytes. Por ejemplo, un valor de voltaje como "12.34" ocuparía 5 bytes como texto. Nuestra librería lo representa en solo 2 bytes (un “int16_t”), logrando una compresión significativa sin pérdida de precisión, ya que manejamos los valores como centésimas de voltio. Este enfoque se aplica a cada una de las variables, resultando en un paquete de datos extremadamente ligero y predecible, es sencillo de usar simplemente fue necesario realizar normalización por escala entera para enviar como enteros simples.

El ahorro en el espacio de transmisión es considerable. Si enviáramos los mismos datos en un formato de texto simple como, por ejemplo, “ID:1,V:23.50,C:150,VB:4.10”, estaríamos utilizando aproximadamente 30 bytes. Al emplear nuestra librería, los mismos datos se codifican en un paquete de solo 8 bytes. Esto representa una reducción de más del 70% en el tamaño del paquete. Esta optimización no solo acelera la transmisión, sino que también libera un ancho de banda crucial en la red, permitiendo que más sensores se comuniquen de manera fluida y sin congestión.

La consecuencia más importante de esta reducción de datos es el ahorro energético. En los nodos de sensores alimentados por baterías, el módulo de radio es uno de los componentes que más energía consume, y su consumo está directamente relacionado con el tiempo que permanece activo transmitiendo. Al enviar paquetes un 70% más pequeños, el tiempo de transmisión se reduce drásticamente, lo que se traduce en una menor demanda de energía y, por lo tanto, en una mayor autonomía y vida útil para las baterías de los dispositivos en campo. De esta manera, “CodecWSN” no solo optimiza la comunicación, sino que también mejora la sostenibilidad y viabilidad de toda la red de sensores.

Una vez que implementamos la transmisión binaria, nos topamos con un problema frustrante y difícil de diagnosticar. Durante las pruebas, observamos que, aunque la mayoría de los mensajes llegaban correctamente, algunos datos eran completamente incoherentes. Al principio, pensamos que había un error en nuestra lógica de codificación o decodificación. Para investigar, creamos una serie de "mensajes de prueba falsos", donde en lugar de enviar mediciones reales, transmitíamos patrones de bytes conocidos y predecibles. Esto nos permitió saber exactamente qué se enviaba y comparar con lo que se recibía. Fue entonces cuando confirmamos el fallo: el receptor a veces interpretaba los datos de manera incorrecta porque la trama de datos se "desfasaba", tal como se ilustra en la Ilustración 10. Desfase de bits en código inicial. Después de mucha experimentación, descubrimos que la causa era la pérdida o corrupción de un solo byte durante la transmisión inalámbrica. Si un byte se perdía, el receptor comenzaba a leer toda la secuencia de bytes subsiguiente de forma desalineada, perdiendo por completo la estructura del paquete.

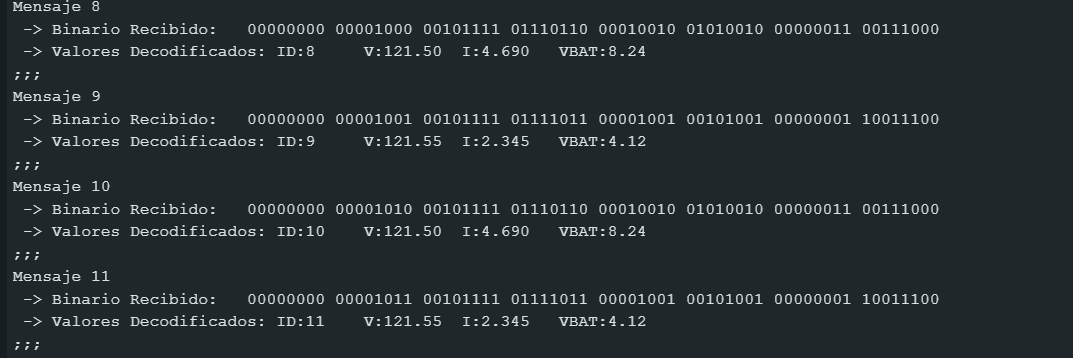
[picture p15: figure]

Ilustración 10. Desfase de bits en código inicial

Para solucionar este problema de desincronización y corrupción, investigamos estrategias de comunicación robustas y llegamos a una solución de dos capas. La primera fue implementar un mecanismo de entramado (framing). En lugar de enviar simplemente los 8 bytes de datos, decidimos envolverlos en una estructura más grande llamada "trama". Esta trama incluye una secuencia de inicio única, conocida como SOF (Start Of Frame), que en nuestro caso son los bytes 0xAA y 0x55. El receptor ahora ignora cualquier dato entrante hasta que detecta esta secuencia específica, lo que le permite resincronizarse automáticamente incluso si se han perdido bytes previamente.

Sin embargo, el framing por sí solo no resuelve la corrupción de datos dentro de la trama. Para ello, implementamos la segunda capa: un CRC (Cyclic Redundancy Check). Un CRC es, en esencia, una "huella digital" matemática altamente fiable que se calcula a partir de un bloque de datos. La lógica es la siguiente:

  1. En el emisor: Antes de enviar la trama, aplicamos un algoritmo matemático (en nuestro caso, el CRC16-CCITT) al contenido del mensaje (versión, longitud y los 8 bytes de datos). El resultado es un número de 16 bits (2 bytes) único para ese contenido específico. Este valor de CRC se adjunta al final de la trama.
  2. En el receptor: Una vez que el receptor detecta una trama completa (usando el SOF y la longitud esperada), realiza exactamente el mismo cálculo de CRC sobre los datos que ha recibido.
  3. Verificación: Finalmente, compara el CRC que acaba de calcular con el CRC que venía al final de la trama recibida. Si los dos valores son idénticos, podemos estar casi un 100% seguros de que los datos no se corrompieron durante la transmisión. Si no coinciden, significa que al menos un bit cambió en el camino, por lo que el receptor descarta la trama completa por ser inválida y espera la siguiente.

Esta doble estrategia de sincronización con SOF y validación con CRC nos proporcionó un canal de comunicación extremadamente robusto. Ahora, el sistema no solo es eficiente en términos de energía y ancho de banda gracias a la compresión binaria, sino que también es altamente fiable, ya que puede recuperarse de pérdidas de sincronización y descartar activamente los datos corruptos.

### Desarrollo de la Librería AdaptiveTXWSN

En las redes de sensores inalámbricos (WSN), el recurso más preciado es, sin duda, la energía de la batería. Un nodo sensor puede tener el mejor hardware y el software más eficiente, pero su vida útil está intrínsecamente ligada a la duración de su fuente de poder. Partiendo de esta premisa, hemos desarrollado la librería AdaptiveTXWSN, un sistema de gestión de transmisión que no opera con una frecuencia fija, sino que adapta su comportamiento en tiempo real basándose en el estado energético del nodo.

El concepto central es la Transmisión Adaptativa. En lugar de transmitir datos a un intervalo constante (por ejemplo, cada 30 segundos), la librería ajusta dinámicamente este periodo. Cuando la batería está completamente cargada, el nodo puede permitirse enviar datos con alta frecuencia para proporcionar información actualizada. Sin embargo, a medida que el nivel de voltaje desciende, la librería reduce proactivamente la frecuencia de transmisión para conservar la energía restante, extendiendo así significativamente la vida operativa del dispositivo en el campo.

La inteligencia de AdaptiveTXWSN se basa en tres pilares fundamentales que trabajan en conjunto:

  1. Monitoreo Preciso del Nivel de Energía: La librería mide continuamente el voltaje de la batería. Esto se logra a través de un pin ADC del microcontrolador, y es totalmente configurable para adaptarse a cualquier hardware mediante un divisor de voltaje. Para asegurar lecturas estables y evitar fluctuaciones por ruido eléctrico, promedia varias muestras consecutivas, una práctica que robustece la medición.
  2. Lógica de Decisión Basada en Umbrales: El sistema clasifica el estado de la batería en tres niveles operativos: ALTO, MEDIO y BAJO. Estos niveles no son fijos, sino que se definen mediante umbrales de voltaje que el usuario puede configurar. Por ejemplo, se puede establecer que por encima de 3.9V el nivel sea ALTO, entre 3.6V y 3.9V sea MEDIO, y por debajo de 3.6V sea BAJO. Además, incluye una función de seguridad crítica: un umbral de corte (corteVoltaje_V). Si el voltaje cae por debajo de este punto, la librería detiene todas las transmisiones para proteger la batería de una descarga profunda, que podría dañarla permanentemente.
  3. Frecuencia de Transmisión Dinámica: Este es el núcleo de la adaptación. Cada uno de los niveles energéticos (ALTO, MEDIO, BAJO) tiene asociado un período de envío configurable. Siguiendo el ejemplo anterior, el nodo podría transmitir cada 5 segundos en nivel ALTO, cambiar a cada 15 segundos en nivel MEDIO, y finalmente reducir la frecuencia a cada 2 minutos en nivel BAJO, priorizando la supervivencia del nodo sobre la inmediatez de los datos.

Durante el desarrollo inicial, nos encontramos con un problema clásico en los sistemas de control: el "rebote" o "chattering". Si el voltaje de la batería fluctuaba justo en el borde de un umbral (por ejemplo, 3.60V), el ruido en la lectura o pequeños cambios de carga podían hacer que el sistema cambiara rápidamente y de forma errática entre el nivel MEDIO y BAJO. Esto provocaba que la frecuencia de transmisión saltara impredeciblemente entre 15 segundos y 2 minutos, un comportamiento ineficiente y no deseado.

La solución implementada fue la histéresis. En lugar de usar un único umbral para cambiar de estado en ambas direcciones, la librería utiliza dos umbrales separados por un pequeño margen:

- Para bajar de MEDIO a BAJO, el voltaje debe caer por debajo del umbral menos un diferencial (ej. 3.60V - 3%).
- Para subir de BAJO a MEDIO, el voltaje debe superar el umbral más un diferencial (ej. 3.60V + 3%).

Este mecanismo crea una "zona muerta" que absorbe las pequeñas fluctuaciones, asegurando que los cambios de estado sean deliberados y estables. Es el mismo principio que utiliza un termostato para evitar que el aire acondicionado se encienda y apague constantemente.

Una de las mayores ventajas de AdaptiveTXWSN es que es totalmente configurable. Prácticamente todos sus parámetros de funcionamiento pueden ser ajustados por el usuario, no solo en la configuración inicial sino también dinámicamente durante la ejecución. Esto permite:

- Adaptarse a cualquier tipo de batería: Baterías LiPo, Li-ion o LiFePO4 tienen curvas de descarga diferentes. Con esta librería, se pueden ajustar los umbrales para que coincidan con las características específicas de la batería utilizada.
- Ajustarse a los requisitos de la aplicación: Una aplicación de monitoreo ambiental puede permitirse intervalos largos, mientras que un sistema de alarma necesita reportes más frecuentes. Los períodos se pueden adaptar a cada necesidad.
- Realizar ajustes en campo: Es posible modificar los umbrales o los períodos de forma remota, permitiendo optimizar el comportamiento de la red sin necesidad de reprogramar físicamente cada nodo.

En conclusión, AdaptiveTXWSN transforma un simple temporizador de envío en un gestor de energía inteligente. Su capacidad para tomar decisiones en tiempo real basadas en el estado del recurso más vital —la batería— la convierte en una herramienta indispensable para crear redes de sensores robustas, autónomas y de larga duración.

## Mejoras de la Sinergia Hardware-Software: Librería EnergyWSN

El avance más significativo en nuestro proyecto no provino de una mejora aislada, sino del análisis profundo de cómo el hardware y el software interactúan. Entendimos que para lograr una autonomía energética radical, el nodo sensor no podía funcionar de manera monolítica, con todos sus componentes encendidos permanentemente. La solución fue diseñar un ciclo de trabajo por pulsos, donde el nodo pasa la mayor parte de su tiempo en un estado de letargo de consumo casi nulo y solo "despierta" durante breves y precisas ventanas de tiempo para cumplir sus tareas.

Esta estrategia requirió una simbiosis perfecta entre modificaciones físicas (hardware) y una lógica de control inteligente (software) que implementamos como una librería llamada EnergyWSN.

Para que el software pudiera gestionar la energía de forma granular, primero tuvimos que realizar cambios clave en el hardware del nodo:

1. Línea de Voltaje Independiente para Sensores: Aislamos la alimentación de todos los sensores (ZMPT, ACS712) en un riel de potencia separado. Esto es crucial porque muchos sensores consumen energía de forma pasiva incluso cuando no están tomando mediciones.
2. Control de Potencia por Software: Para gestionar esta nueva línea de voltaje, integramos un MOSFET conectado a un transistor NPN que actúa como un interruptor electrónico de alta eficiencia. El microcontrolador ahora puede, mediante un simple pulso digital, encender o apagar por completo todo el conjunto de sensores, eliminando cualquier consumo fantasma, y debido a la naturaleza del MOSFET que se controla por Voltaje por lo que para mantenerlo encendido su consumo es prácticamente cero
3. Gestión Avanzada del Módulo de Radio: Par|a controlar el módulo XBee, que opera a 3.3V, se añadió un par de pines conectados que permiten al Arduino (de 5V) "pedirle" al XBee que entre en su modo de hibernación de ultra bajo consumo, utilizando sus pines de control de energía específicos (SLEEP_RQ).

Con el hardware preparado, el código se convierte en el director de orquesta que ejecuta una secuencia de operaciones meticulosamente cronometrada para minimizar el consumo en cada paso a partir de las funciones entregadas por nuestra librería. La lógica del programa es la siguiente:

1. El Despertar Controlado: El ciclo comienza cuando el microcontrolador sale de su estado de sueño profundo (deep sleep), activado por un temporizador interno.
2. Activación y Estabilización de Sensores: Lo primero que hace es enviar una señal al MOSFET para energizar los sensores. Inmediatamente después, el programa espera un breve instante (un delay de milisegundos). Este pequeño tiempo de espera es fundamental, ya que los componentes electrónicos necesitan un momento para que sus voltajes se estabilicen tras el encendido. Omitir este paso podría resultar en mediciones erróneas o inconsistentes.
3. Adquisición Rápida de Datos: Una vez estabilizados los sensores, el microcontrolador realiza las lecturas de voltaje y corriente (analogRead) de la forma más rápida posible.
4. Desactivación Inmediata: Tan pronto como se tienen las mediciones, el software corta la alimentación de los sensores a través del MOSFET. Con esto, nos aseguramos de que solo consuman energía durante la fracción de segundo estrictamente necesaria.
5. Almacenamiento Local: De forma siguiente, los datos se guardan en una tarjeta SD como respaldo local para evitar pérdidas.
6. Comunicación Eficiente: Con los sensores ya apagados, el programa "despierta" al módulo de radio XBee. Compone el paquete de datos y lo transmite. Inmediatamente después de confirmar el envío, le ordena al XBee que vuelva a dormir. El radio, que es el componente de mayor consumo, solo está activo durante el mínimo tiempo indispensable.
7. El Sueño Profundo: Una vez completadas todas las tareas, el microcontrolador ejecuta la instrucción final: entrar en un modo de hibernación (LowPower.sleepFor_ms). En este estado, consume apenas unos microamperios. Permanece así durante el tiempo configurado (desde segundos hasta varios minutos) hasta que el ciclo deba repetirse.

Esta metodología tan precisa permite la mayor ventaja de ahorro energético que hemos avanzado hasta ahora y la más completa ya que nos da una solución robusta y reutilizable

Lograr esta orquestación precisa entre hardware y software no fue un camino directo. Fue un proceso iterativo lleno de investigación, retos inesperados y un aprendizaje práctico invaluable. La implementación de esta estrategia de ultra bajo consumo representó uno de los mayores desafíos técnicos del proyecto y por eso es que estamos tan orgullosos de EnergyWSN.

El primer paso fue adquirir los componentes necesarios. Conseguir el MOSFET adecuado, con las características de bajo voltaje de activación que necesitábamos, resultó ser sorprendentemente difícil. Cuando finalmente lo encontramos, cometimos un error de novato: lo compramos en un encapsulado SOT-23, un formato de montaje superficial. Estos componentes son increíblemente pequeños, diseñados para ser soldados por máquinas en producción en masa.

Para poder usarlos en nuestros prototipos, tuvimos que comprar adaptadores de SOT-23 a formato DIP/SIP, que es el estándar para protoboards. Aunque ya teníamos experiencia soldando, enfrentarnos a estos componentes fue nuestro mayor reto de soldadura hasta la fecha. Trabajar con piezas tan diminutas requirió un pulso de cirujano, herramientas de precisión y mucha paciencia, pero superarlo nos dio una nueva y valiosa habilidad

No bastaba con solo conectar los componentes. Tuvimos que sumergirnos en la teoría para usarlos de manera efectiva. Invertimos tiempo en aprender desde los fundamentos:

- MOSFETs: Entender cómo funcionan como interruptores controlados por voltaje, qué es el voltaje de umbral (gate threshold), y cómo elegir el correcto para que un microcontrolador de 5V pudiera activarlo sin problemas.
- Transistores NPN: Estudiar su funcionamiento como interruptores y, crucialmente, como "level shifters" para poder comunicar de forma segura la señal de encendido o apagado

Este conocimiento teórico fue el puente que nos permitió pasar de un simple cableado a un diseño electrónico robusto y fiable.

El afinamiento del software fue igualmente desafiante:

- Tiempos de Espera (delays): Determinar los retardos necesarios para la estabilización de los componentes fue un proceso de mucha prueba y error. Un delay muy corto resultaba en lecturas incorrectas; uno muy largo desperdiciaba milisegundos preciosos de batería en cada ciclo. Experimentamos hasta encontrar el punto óptimo entre fiabilidad y eficiencia.
- Documentación del Microcontrolador: Tuvimos que sumergirnos en las hojas de datos (datasheets) del microcontrolador ATmega328P. Allí descubrimos una limitación clave del modo de sueño profundo: el temporizador interno (Watchdog Timer) solo puede configurarse para un máximo de 8 segundos de sueño. Para lograr pausas más largas (como 1 o 2 minutos), tuvimos que diseñar un bucle en nuestro código que "despierta" brevemente cada 8 segundos solo para volver a dormirse, hasta completar el tiempo total deseado.
- Documentación del XBee: El modo de hibernación del XBee (Pin Sleep) requirió otra lectura intensiva de su documentación. Primero, tuvimos que reconfigurar los módulos como "End Device" usando el software XCTU para habilitar estas funciones de ahorro. Segundo, descubrimos que no se trataba de un solo pin, sino de un sistema de dos:
- SLEEP_RQ (Sleep Request): Un pin de salida desde nuestro Arduino para solicitar al XBee que se duerma.
- ON/SLEEP (Status Indicator): Un pin de entrada hacia nuestro Arduino que el XBee usa para confirmar su estado actual (si está despierto o dormido).

Esta última revelación fue clave. Nuestra lógica final no solo le ordena al XBee que se duerma, sino que también corrobora que haya obedecido antes de proceder. Esta comunicación de dos vías (comando y confirmación) previene fallos críticos, como que el microcontrolador se duerma mientras el radio sigue encendido consumiendo energía. Fue esta atención al detalle, nacida de la necesidad y la investigación, lo que finalmente nos permitió construir un sistema verdaderamente eficiente

## Implementando múltiples tecnologías y avances

Sabíamos que para que nuestro proyecto fuera completo, no bastaba con probar y optimizar un sistema basado únicamente en la tecnología XBee. Para entender verdaderamente el impacto de nuestras mejoras, planteamos la necesidad de experimentar con diversos módulos de radio. El objetivo es realizar un análisis comparativo que nos permita conocer en profundidad las características de cada tecnología y el impacto de nuestras mejoras energéticas sobre ellos

Para ello implementaremos diferentes tecnologías de comunicación por radiofrecuencia y sobre estos prototipos aplicaremos nuestras mejoras energéticas diseñadas

### LoRa

Ahora pasamos a probar con otros módulos de radio de diferentes tecnologías para así experimentar y validar su alcance, consumo y eficiencia. Como mencionamos, es importante entender estas características para elegir el componente adecuado para cada aplicación. Decidimos que realizaríamos un programa de envío básico con nuestros sensores para establecer una comunicación funcional.

Para empezar, decidimos utilizar la tecnología LoRa. Esto requirió una fase de investigación inicial para comprender sus particularidades. Tuvimos que aprender sobre las bandas de frecuencia permitidas en nuestra región, y entender el significado de parámetros clave como el Factor de Propagación (Spreading Factor), el Ancho de Banda (Bandwidth) y la Tasa de Codificación (Coding Rate), ya que estos afectan directamente el alcance y la velocidad de transmisión.

Durante este proceso, nos encontramos con el primer reto de hardware: los módulos LoRa operan a un nivel lógico de 3.3 voltios, mientras que nuestro Arduino Nano trabaja a 5 voltios. Para asegurar una comunicación segura sin dañar el módulo de radio, fue necesario adquirir conversores de nivel lógico, conocidos como level shifters. Tuvimos que soldar estos pequeños componentes a los módulos, como se muestra en la FIGURA N. A nivel de software, descubrimos que la comunicación con el módulo se realizaba a través del protocolo SPI. Afortunadamente, nuestra experiencia previa configurando la tarjeta SD, que también usa SPI, nos ayudó a comprender la lógica de pines y a escribir rápidamente un sketch básico de comunicación.

Logramos establecer un enlace casi de inmediato; el nodo receptor nos confirmaba la llegada de paquetes y nos mostraba la intensidad de la señal (RSSI). Sin embargo, nos topamos con un problema frustrante: no podíamos leer el contenido del paquete, que aparecía en blanco. Después de mucha depuración, descubrimos que el error estaba en nuestra función de lectura. La librería de LoRa entregaba los datos como una secuencia de bytes, pero nuestra función inicial no añadía correctamente el carácter nulo de terminación al final del buffer antes de convertirlo a un String. Esto provocaba que, al intentar imprimir el contenido, el programa no supiera dónde terminaba el mensaje. Una vez corregido esto, pudimos recibir los mensajes completos, como se ve en la Ilustración 11. Primeros mensajes recibidos en Lora exitosamente.

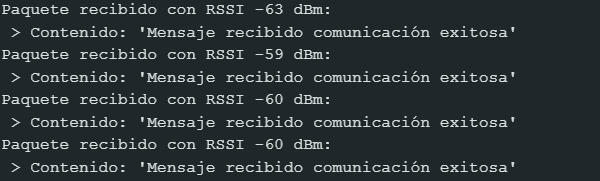
[picture p16: figure]

Ilustración 11. Primeros mensajes recibidos en Lora exitosamente

#### Inyectando los radios

En teoría, el siguiente paso era adaptar nuestro sketch complejo con sensores y librerías para que funcionara con LoRa, y luego repetir todo el proceso que hicimos para XBee y que se planeaba para cualquier otro módulo futuro. En ese momento nos dimos cuenta de que este enfoque no era escalable. Crear un código completo y personalizado para cada tipo de radio sería un proceso muy largo, propenso a errores y difícil de mantener.

Decidimos poner en marcha una solución de software más elegante y eficiente. En lugar de tener múltiples códigos, crearíamos un único sketch "universal" y una forma de "inyectar" el módulo de radio necesario. Tras investigar patrones de diseño de software, y usando nuestro conocimiento de programación, decidimos crear una "interfaz". Esta interfaz actúa como un contrato o una plantilla. Define un conjunto de funciones genéricas que cualquier módulo de radio debe tener, como "iniciar", "enviar" y "leer".

Luego, creamos clases específicas para cada radio, como "LoraRadio" y "XBeeRadio". Cada una de estas clases hereda de la interfaz y contiene el código de bajo nivel y los comandos específicos para su hardware particular. Sin embargo, al llamarlas desde nuestro programa principal, usamos las funciones genéricas de la interfaz. De esta forma, el código principal no necesita saber si está hablando con un LoRa o un XBee; simplemente le dice a la interfaz "envía estos datos".

El cambio es evidente al comparar el código anterior, "Normal_sensor.ino", con el nuevo "EmisorUniversal.ino". En el código antiguo, todo el programa estaba lleno de llamadas directas a "xbeeSerial", acoplando fuertemente la lógica a un solo tipo de hardware. En el emisor universal, el código del loop es completamente agnóstico al radio. Utiliza un puntero genérico llamado "radio" y funciones como "radio->enviar()".

La magia ocurre en la sección de configuración. Con una sola línea de código, podemos decidir qué radio usar. Al definir "USE_LORA", el programa crea un objeto de la clase "LoraRadio", lo configura con todos los parámetros necesarios a través de una estructura "LoRaConfig", y lo asigna al puntero genérico "radio". Si quisiéramos cambiar a XBee, simplemente cambiaríamos la definición a "USE_XBEE" y el programa crearía un objeto "XBeeRadio" en su lugar. Esta técnica, conocida como inyección de dependencias, nos permitió crear un sistema modular, limpio y fácilmente extensible para cualquier tecnología de radio que queramos probar en el futuro.

El resultado fue la creación de un conjunto de archivos de código limpios y modulares, tal como se muestra en la estructura de la IMAGENARCHIVOSINYECTABLES, donde cada radio tiene su propia clase y un sketch universal los controla.

El proceso de implementación fue notablemente rápido, ya que el trabajo más pesado ya estaba hecho. Contábamos con prototipos funcionales tanto para XBee como para LoRa, el hardware estaba montado y sabíamos que los componentes se comunicaban. Por lo tanto, la tarea se centró exclusivamente en una reestructuración del software.

Creamos los sketches EmisorUniversal.ino y ReceptorUniversal.ino. Durante el desarrollo, nos encontramos con un problema interesante de inicialización. Nuestro objetivo era que toda la configuración ocurriera dentro de la función iniciar() de cada clase de radio. Esto funcionó perfectamente para LoRa, pero descubrimos que para XBee, que depende de SoftwareSerial, era más estable y seguro iniciar el puerto serial en el setup() principal del sketch, antes de llamar a la función de la interfaz. La solución fue documentar este requisito y adaptar ligeramente el sketch universal, demostrando cómo a veces la arquitectura ideal debe ajustarse a las particularidades del hardware.

Una vez resuelto esto, las pruebas fueron un éxito rotundo y demostraron el poder de este nuevo enfoque:

- Prueba con XBee: En los sketches de emisor y receptor, activamos la línea de código para usar XBee. Al compilar y cargar el software en nuestros prototipos ya existentes, la comunicación se estableció de inmediato, funcionando a la perfección.
- Prueba con LoRa: Sin cambiar nada en el hardware del prototipo usando antes con LoRa, volvimos a los archivos de código y modificamos una sola línea en cada uno para activar Lora en lugar de XBee como se puede ver en la Ilustración 12. Cambio entre Xbee y Lora a través de una sola linea. Tras compilar y cargar, los nodos LoRa también se comunicaron sin ningún problema como se puede apreciar en la Ilustración 13. Comunicación de LoRa al inyectarse los módulos de radio.

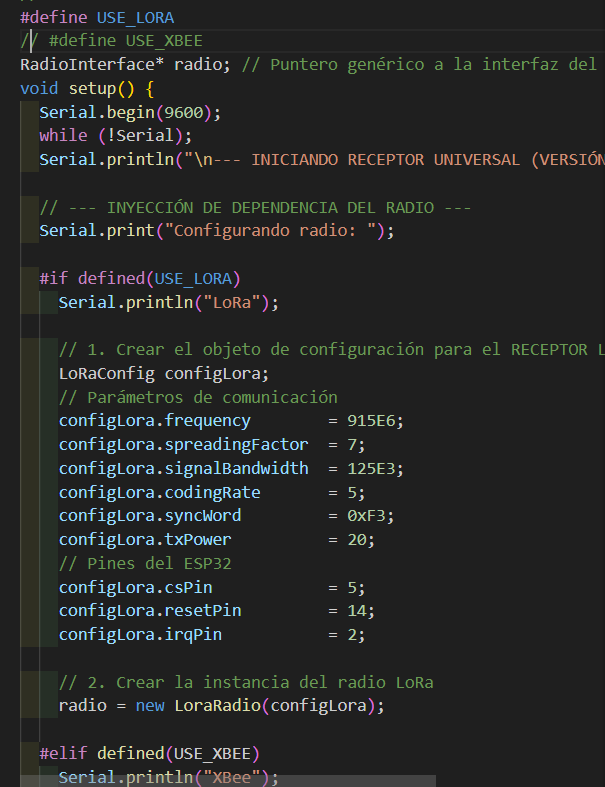
[picture p17: figure]

Ilustración 12. Cambio entre Xbee y Lora a través de una sola linea

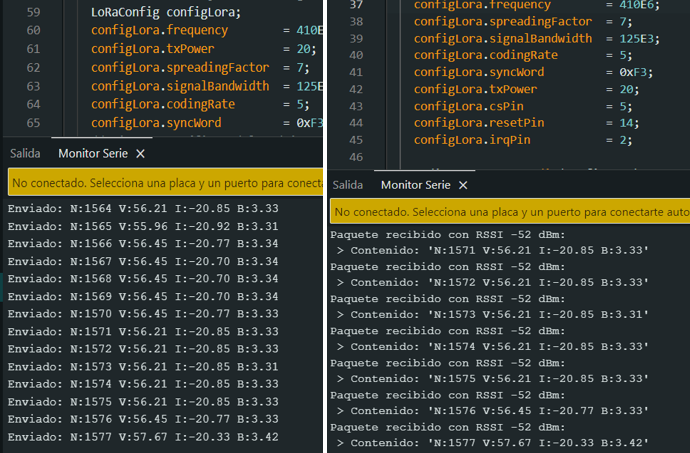
[picture p18: figure]

Ilustración 13. Comunicación de LoRa al inyectarse los módulos de radio

Ver que podíamos cambiar fundamentalmente la tecnología de comunicación inalámbrica con una modificación mínima en el código fue la confirmación de que nuestra estrategia había sido un éxito.

Esta arquitectura de software representa una mejora fundamental para nuestro proyecto por varias razones estratégicas:

- Eficiencia de Desarrollo: Ya no necesitamos escribir y mantener múltiples códigos complejos para cada tipo de radio. Ahora tenemos una única base de código para la aplicación (leer sensores, aplicar lógica) y solo tenemos que mantener las pequeñas clases de controlador para cada radio. Esto ahorra una cantidad enorme de tiempo y reduce la posibilidad de errores.
- Escalabilidad Futura: Como en el futuro queremos probar un tercer tipo de radio (como un nRF24L01), no necesitamos empezar de cero. Simplemente escribiremos una nueva clase que cumpla con el "contrato" de la RadioInterface y nuestro sistema universal será compatible con ella al instante.
- Código Desacoplado y Limpio: La lógica de la aplicación está ahora completamente separada de la capa de comunicación. Esto es un principio de ingeniería de software muy importante que hace que el código sea más fácil de leer, depurar y mejorar.
- Pruebas Aisladas: Nos permite probar cada parte del sistema de forma independiente. Podemos verificar que la lógica de los sensores funciona sin necesidad de un radio, o probar un nuevo radio con un simple mensaje de "hola mundo" sin necesidad de toda la lógica de los sensores.

En resumen, esta inversión en la arquitectura del software nos ha proporcionado un sistema robusto, flexible y preparado para el futuro, permitiéndonos centrarnos en lo que realmente importa: experimentar y comparar tecnologías en lugar de reescribir código repetitivo.

### NRF24L01

Como parte de la evaluación comparativa entre distintos protocolos de comunicación inalámbrica, se seleccionó el transceptor nRF24L01. El propósito de esta sección es detallar la metodología y la configuración experimental empleada para analizar sus métricas de rendimiento clave, específicamente: su rango operativo, la fiabilidad en la transmisión y recepción de datos, y su consumo energético.

El nRF24L01 es un módulo transceptor de radiofrecuencia de ultra bajo consumo (ULP) y alto rendimiento, diseñado por Nordic Semiconductor. Opera en la banda ISM (Industrial, Científica y Médica) de 2.4 GHz, la cual es de uso libre a nivel mundial. Su comunicación con microcontroladores se realiza a través del protocolo SPI (Serial Peripheral Interface), lo que facilita su integración en una amplia gama de proyectos de electrónica embebida. Entre sus características destacan una velocidad de datos configurable (250 kbps, 1 Mbps y 2 Mbps) y un manejo eficiente de la energía, lo que lo hace ideal para aplicaciones alimentadas por baterías.

#### Configuración y pinout

Para la implementación del enlace de comunicación, se establecieron dos nodos principales: un Nodo Emisor encargado de transmitir datos y un Nodo Receptor encargado de recibirlos.

La conexión física del módulo nRF24L01 a los microcontroladores se simplificó mediante el uso de un adaptador específico. Este componente cumple dos funciones críticas:

1. Facilitar el Pinout: Proporciona un conjunto de pines de conexión estándar (2.54 mm) más manejables que los del módulo nativo.
2. Regulación de Voltaje: Integra un regulador que permite alimentar el adaptador con 5V (un voltaje común en placas como Arduino), entregando de forma segura los 3.3V que requiere el nRF24L01 para su operación, evitando así daños en el módulo.

A continuación, en la Tabla 3. Pines del nodo Sensor para nRF24L01 y en la Ilustración 14. Arquitectura del nodo sensor se detalla el esquema de conexiones para cada nodo.

Pin nRF24L01 | Pin Arduino Nano | Descripción
GND | GND | Tierra
VCC | 3.3V | Alimentación de 3.3 Volts
CE | D9 | Chip Enable (Configurable)
CSN | D10 | Chip Select Not (Configurable)
SCK | D13 | Serial Clock (SPI)
MOSI | D11 | Master Out Slave In (SPI)
MISO | D12 | Master In Slave Out (SPI)
IRQ | N/A | Interrupt Request

Tabla 3. Pines del nodo Sensor para nRF24L01

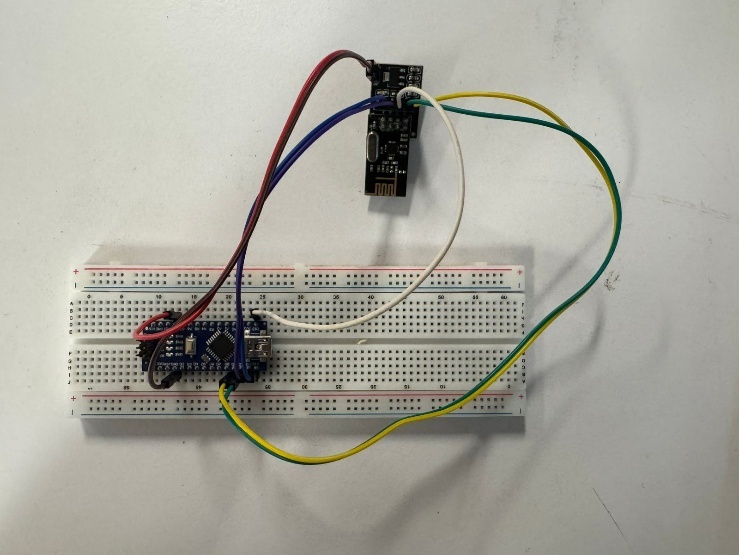
[picture p19: figure]

Ilustración 14. Arquitectura del nodo sensor

Este nodo se compone de un microcontrolador ESP32 y un módulo nRF24L01, seleccionado por su mayor capacidad de procesamiento y conectividad. En la Tabla 4. Pines del nodo coordinador para nRF24L01 y en la Ilustración 15. Arquitectura del nodo coordinador se muestra el esquema de conexión.

Pin nRF24L01 | Pin ESP32 | Descripción
GND | GND | Tierra
VCC | 3.3V | Alimentación de 3.3 Volts
CE | D4 | Chip Enable (Configurable)
CSN | D5 | Chip Select Not (Configurable)
SCK | D18 | Serial Clock (SPI)
MOSI | D23 | Master Out Slave In (SPI)
MISO | D19 | Master In Slave Out (SPI)
IRQ | (No se conecta) | Interrupt Request

Tabla 4. Pines del nodo coordinador para nRF24L01

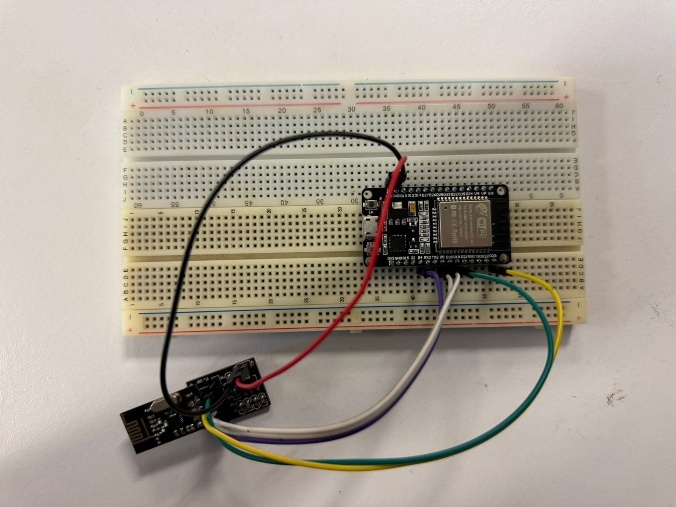
[picture p20: figure]

Ilustración 15. Arquitectura del nodo coordinador

#### Implementación de Firmware para Comunicación Básica

Para establecer un enlace de comunicación funcional entre los nodos, se desarrolló un firmware base utilizando el entorno de desarrollo de Arduino y la librería RF24 de TMRh20, una de las más robustas para el manejo de estos módulos. A continuación, se presentan los códigos fuente para el emisor y el receptor.

#### Estrategias de Gestión de Energía del nRF24L01

Una de las características más destacadas del transceptor nRF24L01 es su diseño orientado a aplicaciones de ultra bajo consumo (ULP), fundamental para dispositivos alimentados por batería. El módulo incorpora dos modos principales de ahorro de energía que pueden ser controlados por software para optimizar la longevidad del sistema.

#### Modo de apagado (Power Down)

Este modo representa el estado de más bajo consumo del módulo. Cuando se activa, la mayoría de los circuitos internos se desactivan, logrando un consumo de corriente residual de aproximadamente 900 nA.

- Activación: Se controla mediante software a través de los comandos de la librería RF24, específicamente radio.powerDown() para entrar en este estado y radio.powerUp() para salir de él.
- Consideración Clave: Si bien este modo ofrece el máximo ahorro de energía, tiene una latencia de reactivación. Al salir del estado Power Down, el módulo requiere un tiempo de estabilización de 1.5 milisegundos para que sus osciladores internos se calibren correctamente. Es crucial respetar este tiempo de espera antes de intentar una transmisión para evitar el envío de paquetes de datos corruptos o incompletos.

#### Modo de espera (standby - I)

El modo Standby-I es un estado de reposo intermedio que ofrece un equilibrio entre el ahorro de energía y la velocidad de respuesta. En este estado, los osciladores principales del módulo se mantienen activos, resultando en un consumo de aproximadamente 26 µA.

- Activación: Este es el estado por defecto en el que se encuentra el módulo inmediatamente después de ser inicializado con radio.begin() o radio.powerUp(). También transita a este modo cuando se detiene la escucha activa mediante radio.stopListening().
- Ventaja Principal: Su principal beneficio es la transición casi instantánea a los modos de transmisión (TX) o recepción (RX), que toma solo 130 microsegundos (µs). Esto lo hace ideal para aplicaciones que requieren una respuesta rápida a eventos externos sin incurrir en la latencia del modo Power Down.

#### Modelo de envío bidireccional

Aprovechando la flexibilidad de estos modos de bajo consumo, se implementó un protocolo de comunicación bidireccional diseñado para ser robusto y energéticamente eficiente. Esta estrategia permite no solo la transmisión de datos del sensor al coordinador, sino también la verificación periódica del estado del nodo sensor (un mecanismo de heartbeat o "pulso de vida").

El flujo de operación es el siguiente:

1. Transmisión del Sensor: El nodo sensor se activa, transmite su paquete de datos y, para maximizar la vida de su batería, entra inmediatamente en el modo Power Down.
2. Recepción del Coordinador: El nodo coordinador, que se encuentra en modo de escucha, recibe los datos. Tras una recepción exitosa, inicia un temporizador de espera (por ejemplo, 5 segundos).
3. Mecanismo de Verificación (Ping): Si el coordinador no recibe un nuevo mensaje del sensor dentro del tiempo establecido, asume que podría haber un problema. En ese momento:
  a. El coordinador cambia su rol de receptor a emisor.
  b. Envía un mensaje de "ping" o solicitud de estado a la dirección del nodo sensor.
  c. Este mecanismo permite al sistema central verificar si el nodo sensor sigue activo y en rango, incluso cuando este se encuentra en estado de reposo profundo la mayor parte del tiempo.

Esta combinación inteligente de los modos de ahorro de energía permite que los nodos remotos operen durante períodos prolongados con una sola carga de batería, mientras se mantiene la capacidad de supervisar la salud y conectividad de la red.

#### Implementación de Persistencia de Datos y Sincronización Temporal

Para mejorar el sistema de una simple red de transmisión en tiempo real a una plataforma de adquisición de datos robusta, se integraron dos componentes de hardware cruciales: una memoria EEPROM (Electrically Erasable Programmable Read-Only Memory) y un RTC (Real-Time Clock). El objetivo de esta mejora fue dotar a los nodos de la capacidad de almacenar datos de forma persistente y de contextualizar cada evento con una marca de tiempo precisa.

##### 1. Almacenamiento con Memoria EEPROM

La volatilidad de la memoria RAM de los microcontroladores presenta una limitación significativa para el análisis a largo plazo, ya que cualquier reinicio del sistema o pérdida de energía borra todos los datos de operación, como los contadores de paquetes. Para superar este obstáculo, se implementó una memoria EEPROM en los nodos.

Propósito y Funcionamiento: La función principal de la EEPROM es proporcionar almacenamiento no volátil. En esta implementación, se utilizó para guardar información crítica del último mensaje gestionado por el nodo, como el ID del paquete o el conteo total de paquetes enviados/recibidos.

Al registrar estos valores en la EEPROM, el estado de la comunicación se preserva incluso si el nodo se apaga o se reinicia. Al volver a encenderse, el nodo puede leer el último estado guardado y continuar su operación sin perder la secuencia. Esto es fundamental para realizar un análisis post-operativo preciso de la fiabilidad de la red, permitiendo calcular con exactitud la tasa de envío y recepción de paquetes a lo largo de ciclos de energía completos.

##### 2. Agregando el Módulo RTC (Real-Time Clock)

Si bien los temporizadores internos de los microcontroladores (como la función millis()) son útiles para medir intervalos cortos, no son adecuados para registrar la hora y fecha de eventos en el mundo real, ya que se reinician con el dispositivo y pueden tener desviaciones significativas con el tiempo.

Propósito y Funcionamiento: Para solucionar esto, se integró un módulo RTC, como el DS3231. Este dispositivo es un reloj de alta precisión, respaldado por su propia batería tipo moneda, que mantiene la hora, fecha y día de la semana de forma continua e independiente del estado del microcontrolador principal.

La implementación del RTC en el nodo sensor y en el nodo coordinador permiten que cada vez que se recibe un paquete de datos, este sea estampado con la fecha y hora exactas de su llegada. Esta capacidad es invaluable para:

- Analizar patrones temporales: Permite identificar a qué horas del día se producen más pérdidas de paquetes, lo que puede estar relacionado con interferencias externas.
- Diagnosticar fallos: Si un nodo sensor deja de transmitir, el timestamp del último mensaje recibido indica con precisión cuándo ocurrió el fallo.
- Sincronizar datos: Asegura que todos los datos recolectados tengan un contexto temporal coherente y fiable para su posterior análisis y visualización.

En conjunto, la EEPROM y el RTC transforman los nodos de simples transceptores a registradores de datos (data loggers) avanzados, mejorando drásticamente la capacidad de análisis, depuración y validación del rendimiento general del sistema.

### Creacion de UniversalRadioWSN como librería

A medida que nuestra arquitectura de software se volvía más sofisticada, nos encontramos con una frustración persistente y limitante del propio entorno de desarrollo de Arduino. El IDE tenía problemas para reconocer nuestros archivos de cabecera (`.h`) cuando intentábamos organizarlos en subcarpetas o apuntar a direcciones relativas. Esto nos obligaba a mantener todos los archivos en una única carpeta junto al sketch principal, lo que contradecía nuestro objetivo de tener un código limpio, modular y organizado. A medida que añadíamos más clases, el directorio del proyecto se volvía cada vez más desordenado.

Decidimos que la única solución real era dar el siguiente paso y empaquetar todo nuestro sistema de radio universal en una librería de Arduino formal. Esto no solo resolvería los problemas de organización, sino que también haría nuestro código mucho más reutilizable y profesional.

El proceso implicó reestructurar por completo nuestros archivos. Aprendimos que una librería de Arduino sigue una estructura de carpetas estricta que el IDE sí sabe cómo interpretar. Creamos una carpeta principal para la librería y, dentro de ella, un subdirectorio llamado `src` (source) donde movimos todos nuestros archivos de bajo nivel: la interfaz `RadioInterface.h` y las clases concretas como `LoraRadio.h` y `XBeeRadio.h`.

Este cambio nos permitió simplemente incluir nuestra librería en cualquier sketch con una sola línea de código, como `#include <UniversalRadioWSN.h>`, y el IDE automáticamente encontraría y compilaría todos los archivos necesarios desde la carpeta `src` esto se puede apreciar más fácil en la Ilustración 16. Organización de UniversalRadioWSN como librería.

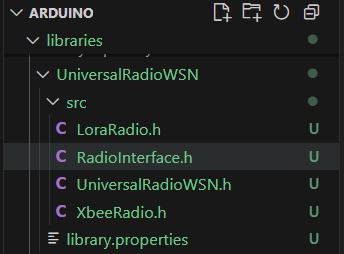
[picture p21: figure]

Ilustración 16. Organización de UniversalRadioWSN como librería

Esto resolvió de raíz el problema de la gestión de archivos, además, para que la librería fuera completa y fácil de usar en el futuro, movimos nuestros sketches de aplicación, como `EmisorUniversal.ino` y `ReceptorUniversal.ino`, a una carpeta llamada `examples`. De esta manera, cualquiera que instale la librería puede abrir estos ejemplos directamente desde el menú del IDE de Arduino para ver un caso de uso funcional y completo. Esta práctica no solo sirve como una excelente documentación, sino que también asegura que tengamos una base de código estable y probada para iniciar cualquier nuevo proyecto que utilice nuestro sistema de radio.

### Realización de diversos códigos para control y muestreo

Lo que siguió fue la fase de integración final. Como ya teníamos la librería UniversalRadioWSN funcionando correctamente y contábamos con las librerías de optimización (CodecWSN, EnergyWSN, AdaptiveTXWSN) probadas de forma individual, el siguiente paso fue hacer que todo trabajara en conjunto.

Fue un trabajo largo y meticuloso, pero nuestros esfuerzos anteriores por diseñar todo de forma modular y como librerías independientes hicieron que este proceso fuera mucho más manejable. En gran medida, la tarea se simplificó a importar las librerías correspondientes y llamar a sus funciones en el orden correcto. Durante esta integración, encontramos pequeños problemas de compatibilidad y lógica, que, si bien no eran graves, requerían ser solucionados para obtener un código final limpio, mantenible y completamente funcional.

El resultado de este trabajo fue un conjunto de sketches de prueba definitivos. Tomamos como base nuestro EmisorUniversal.ino (capaz de cambiar de radio con una sola línea de código) y, sobre él, generamos un sketch individual de envío y recepción para cada una de nuestras librerías de mejora. Esto se hizo con la finalidad de validar su capacidad de recepción y medir el consumo energético de cada optimización por separado.

Además, generamos sketches para cada una de las mezclas posibles de nuestras librerías de ahorro energético, para así medir cómo interactuaban entre sí. Finalmente, creamos la versión más óptima de todas: un sketch que une las tres librerías (CodecWSN, EnergyWSN y AdaptiveTXWSN) en un único sistema. El objetivo de esta versión final es poder medirla y compararla con el prototipo base para ver realmente cuánto hemos avanzado y cuantificar la mejora total lograda.

### Trabajando con paneles solares

Habiendo llevado nuestras optimizaciones de eficiencia energética al límite, el siguiente paso lógico es abordar el problema fundamental de la autonomía desde la otra dirección: la recolección de energía. Para ello, planeamos implementar paneles solares. El objetivo ya no es solo hacer que la batería dure el mayor tiempo posible, sino crear nodos sensores que puedan recargarse a sí mismos y, en teoría, operar de forma indefinida. Este es un paso crucial para lograr un sistema verdaderamente autónomo y auto-sostenible. Sin embargo, para esta fase solo contamos con dos pares de paneles solares de diferentes características. Esto define nuestra experimentación: será un estudio puramente comparativo. El plan es integrar cada tipo de panel a nuestros prototipos optimizados para medir y analizar cuál de los dos es más eficiente para recargar las baterías bajo las condiciones de luz reales de nuestro entorno, considerando factores como su tamaño, voltaje de salida y rendimiento real.

## Realización de pruebas

La verificación de las mejoras desarrolladas requirió la ejecución de pruebas instrumentales sobre el hardware. La evaluación se centró en caracterizar los dos pilares fundamentales del rendimiento del sistema: el consumo de energía (eficiencia) y la integridad en la transmisión de datos (fiabilidad).

### Definición de las pruebas de Eficiencia Energética

Tras analizar las mejores prácticas para la validación de sistemas de bajo consumo, se determinó que la medición directa de la duración de la batería (esperar hasta el agotamiento total del nodo) resultaba inviable. Dado el alto grado de optimización energética logrado, una prueba de descarga real podría extenderse durante semanas o meses, obstaculizando la capacidad de realizar iteraciones y comparaciones ágiles.

En consecuencia, se adoptó una metodología de extrapolación basada en el perfil de consumo. Este enfoque analítico permite predecir la autonomía con precisión científica mediante la caracterización detallada del ciclo de trabajo (duty cycle) del nodo.

El procedimiento se dividió en tres partes fundamentales:

1. Caracterización de Corriente por Estados (I_(activa) y I_(reposo) ) .

Para aislar y medir el consumo eléctrico sin fluctuaciones, se desarrollaron dos firmwares de prueba específicos:

- Estado Activo: Un código que fuerza al nodo a operar en un bucle continuo de lectura de sensores, procesamiento y transmisión. Esto permitió medir con un multímetro de precisión la corriente activa estable (I_(activa) ) .
- Estado de Reposo: Un código que fuerza al nodo a permanecer indefinidamente en su modo de bajo consumo (Sleep/Deep Sleep). Esto permitió registrar la corriente de base o corriente de fuga (I_(reposo) ) .
1. Medición de Tiempos: Con el código original, usamos la función millis() para medir con precisión la duración del estado de trabajo (T_(activo) y T_(reposo) ) . El tiempo de reposo (T_(reposo) ) ya lo conocemos, pues es un valor que programamos en el código.
2. Cálculo de la Autonomía: Con estos cuatro valores, calculamos la corriente promedio que el nodo consume en cada ciclo completo:

I_(prom) =((I_(activa) *T_(activo) )+(I_(reposo) *T_(reposo) ))/((T_(activo) +T_(reposo) ))

Finalmente, para estimar la vida útil del nodo, relacionamos la capacidad nominal de la batería con el consumo promedio calculado:

Autonomía (Horas)=(capacidad de la batería (mAh))/(I_(prom) (mA))

Esta metodología transforma un problema de resistencia física en un modelo matemático preciso, permitiéndonos cuantificar de manera inmediata el impacto de cualquier modificación en el hardware o el software sobre la longevidad del sistema.

### Pruebas de consumo de hardware con nuestro software

Lo que siguió fue un proceso de validación exhaustivo. Nos dedicamos a probar todos y cada uno de los códigos que habíamos generado por separado para validar tanto su funcionamiento como su consumo energético.

Este plan de pruebas implicó probar cada variable de forma aislada: probamos los sketches que usaban nuestras librerías por separado (un sketch solo con CodecWSN, uno solo con EnergyWSN, etc.) y luego probamos todas las combinaciones posibles entre ellas. A su vez, realizamos estas mediciones en los diferentes prototipos de hardware, es decir, tanto en el que usaba LoRa como en el que usaba XBee y NRF. La única excepción fue la librería EnergyWSN, que va intrínsecamente "casada" con las modificaciones de hardware (el MOSFET y los pines de control), por lo que esas pruebas solo se realizaron sobre el prototipo que incluía dichas mejoras.

Para cada una de estas combinaciones, aplicamos la metodología de medición que habíamos definido: medimos la corriente de reposo y la corriente de trabajo, calculamos el promedio ponderado y estimamos la autonomía. Todos estos datos fueron recopilados y organizados en una hoja de cálculo, cuyos resultados finales se pueden apreciar en el Anexo A (Anexo_A_Datos_Consumo.xlsx ).

Fue un trabajo indudablemente tedioso y lento, ya que requería reconfigurar, cargar código y medir meticulosamente cada uno de los prototipos múltiples veces. Sin embargo, al final del proceso, estamos muy satisfechos con los resultados. Ver los datos en la tabla nos ha dado una confirmación clara de que nuestras estrategias funcionaron y nos proporciona un camino evidente sobre el cual seguir avanzando.

### Parásitos del consumo

Es fundamental entender que los cálculos de autonomía presentados en la tabla anterior son el resultado directo de mediciones sobre nuestros prototipos físicos. Esto significa que los valores de consumo que obtuvimos, y la autonomía máxima estimada de poco más de 30 días, ya incluyen el impacto negativo de todos los componentes "parásitos" que merman la eficiencia.

Un parásito del consumo es cualquier componente que drena energía de forma constante sin contribuir a la tarea principal del nodo. En nuestros prototipos, identificamos varios que están afectando gravemente el rendimiento:

- El primer parásito y el más evidente son los LEDs de encendido. Los módulos de sensores que utilizamos, al ser componentes económicos de propósito general, incluyen LEDs de estado que permanecen encendidos constantemente. Cada uno de estos LEDs representa una pequeña pero perpetua fuga de corriente que no podemos controlar por software y que suma al consumo base.
- El segundo parásito es nuestro propio sistema de alimentación. Usamos un regulador step-down MP1584 para alimentar el sistema a 5V. Si bien es mucho más eficiente que un regulador lineal, a los niveles de optimización que buscamos, sigue siendo una solución amateur. Como se puede ver en la Ilustración 18, este regulador tiene un consumo en vacío de 0.56 mA. Esto significa que, antes de que el Arduino haga nada, ya estamos pagando un "impuesto" de 0.56 mA.
- Sin embargo, el problema más grave que encontramos, y que domina nuestro consumo en reposo, fue el regulador de 5V a 3.3V, necesario para alimentar el módulo de radio. Este componente, que debería ser casi invisible, resultó ser el parásito más grande de todo el sistema. Como se observa en la Ilustración 19, este regulador consume 5.95 mA de forma constante. Este consumo es catastrófico para un diseño de bajo consumo. Para ponerlo en perspectiva, este simple regulador consume diez veces más energía que el propio regulador MP1584 y anula por completo el beneficio de poner el radio en modo de sueño. Aunque el módulo de radio se duerma y consuma microamperios, el regulador lineal que lo alimenta sigue desperdiciando casi 6 mA.

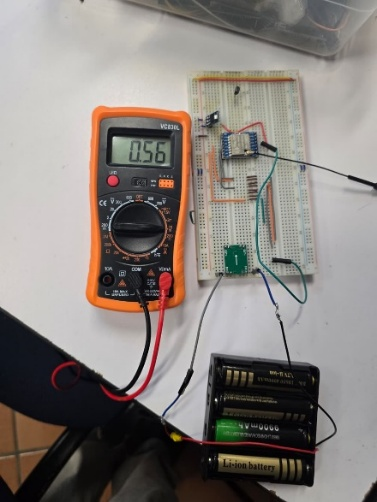
[picture p22: figure]

Ilustración 25. Consumo del regulador MP1584 en solitario

Al final, es la suma de todos estos pequeños parásitos lo que explica por qué nuestra autonomía máxima se ve limitada a poco más de 30 días, a pesar de nuestros esfuerzos de software. Son limitaciones que asumimos debido al presupuesto y a los componentes disponibles para el prototipo, pero que deben ser la primera prioridad a la hora de diseñar una versión final del hardware.

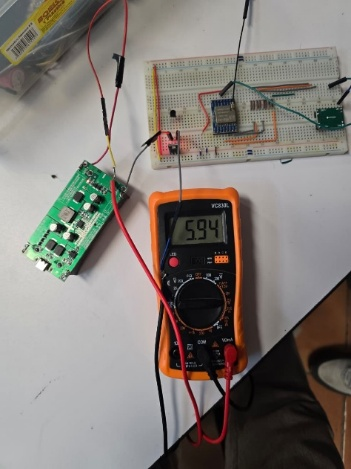
[picture p23: figure]

Ilustración 26. Consumo del regulador ACS117 5V a 3.3V en solitario

### Definición de las pruebas de Fiabilidad de la Comunicación

Para cuantificar la integridad en la recepción de paquetes, se diseñó e implementó un sistema de auditoría de transmisión mediante contadores sincronizados. Este enfoque permite un seguimiento determinista del flujo de información entre los nodos.

El mecanismo se basa en dos contadores independientes:

- Contador TX (Nodo Sensor): Se incrementa tras cada intento de transmisión.
- Contador RX (Nodo Coordinador): Se incrementa únicamente tras la recepción y validación exitosa de un paquete.

Para garantizar la integridad de los resultados ante posibles reinicios o fallos de energía durante las pruebas, se optó por almacenar estos valores en la memoria no volátil (EEPROM) del microcontrolador.

Consideraciones Técnicas y Ciclos de Escritura: La implementación de la EEPROM presentó un desafío técnico importante debido a la vida útil limitada de esta memoria (aproximadamente 100,000 ciclos de escritura por celda).

- Gestión de Datos: Se desarrollaron rutinas de software para la escritura y lectura de variables multibyte (necesarias para contadores que superan el valor 255), asegurando la correcta reconstrucción de la información.
- Compromiso de Diseño: Para efectos de la validación experimental, se tomó la decisión estratégica de actualizar la EEPROM con cada paquete enviado/recibido. Si bien esto acelera el desgaste del chip, se priorizó la granularidad y seguridad de los datos para asegurar que, incluso ante un fallo catastrófico del nodo, el conteo final fuera exacto y recuperable.

Al finalizar el periodo de prueba (por ejemplo, ciclos de 1 hora), se extraen los valores finales de ambos contadores para proceder al cálculo de métricas.

Cálculo de Paquetes Perdidos: La pérdida absoluta se determina mediante la diferencia aritmética entre los paquetes inyectados a la red y los efectivamente procesados por el coordinador:

Paquetes Perdidos = Contador de Enviados - Contador de Recibidos

Cálculo de la Tasa de Éxito (Packet Delivery Ratio - PDR): Finalmente, se calcula la fiabilidad del enlace, expresada como un porcentaje de eficiencia. Esta métrica es fundamental para validar la calidad de la conexión inalámbrica:

Tasa de Éxito (%) = ((Paquetes Recibidos)/(Paquetes Enviados)) × 100

Con esta doble estrategia de medición (persistencia física + cálculo matemático) proporciona datos duros y objetivos, permitiendo no solo validar la operatividad del sistema, sino también realizar un análisis comparativo preciso sobre el impacto de las optimizaciones implementadas en cada fase del desarrollo.

## Publicación de Librerías en el Arduino Library Manager

Desde el inicio del proyecto, se estableció el objetivo de que las mejoras de software desarrolladas no solo fueran funcionales, sino también reutilizables y accesibles para otros. Por ello, se planificó estructurar los componentes clave —CodecWSN, AdaptiveTXWSN, EnergyWSN y UniversalRadioWSN— como librerías de Arduino independientes. El paso final de esta estrategia fue su publicación formal en el Administrador de Bibliotecas oficial de Arduino, para asegurar su difusión y facilitar su integración por parte de la comunidad.

La publicación de estas librerías responde a varios objetivos importantes:

- Fomentar la Reutilización: El trabajo invertido en crear código modular y robusto debía extenderse más allá de este informe. Al publicarlas, otros desarrolladores pueden incorporar estas funcionalidades en sus proyectos mediante una simple directiva #include, optimizando su tiempo de desarrollo.
- Contribuir a la Comunidad: La plataforma Arduino se fortalece con las contribuciones de sus usuarios. Compartir estas librerías no solo ofrece herramientas prácticas, sino que también las expone a la revisión y mejora por parte de otros. Específicamente, al saber que existen diversos proyectos relacionados con WSN en el Instituto Tecnológico de Chetumal (ITCh), estas librerías pueden servir como base o complemento para futuros trabajos dentro de la institución, permitiendo a otros estudiantes o investigadores aplicar directamente nuestras optimizaciones energéticas.
- Facilitar el Acceso y la Estandarización: Estar listado en el Administrador de Bibliotecas oficial incrementa la visibilidad y credibilidad del trabajo. Además, simplifica enormemente la instalación y gestión de actualizaciones para los usuarios finales a través del IDE de Arduino, alineándose con las prácticas estándar de la plataforma.
- Ampliar el Impacto del Proyecto: Hacer las librerías fácilmente accesibles permite que las soluciones de eficiencia energética desarrolladas se apliquen en contextos más amplios, contribuyendo de forma más significativa al avance de las WSN sostenibles.

### Consideraciones previas a la publicación

Antes de abordar los aspectos técnicos de la publicación, se realizó una fase de investigación consultando la documentación oficial de Arduino y diversas fuentes comunitarias. El objetivo fue comprender a fondo el proceso de registro y, crucialmente, identificar los requisitos indispensables que una librería debe cumplir para ser aceptada y considerada de calidad por la plataforma. Esta investigación inicial reveló la necesidad de definir claramente aspectos como la estructura de carpetas (src/, examples/), los metadatos (library.properties incluyendo autoría, versión y dependencias), una licencia de uso adecuada, documentación clara (README.md) y ejemplos funcionales. Comprender la importancia y el formato de cada uno de estos elementos fue esencial antes de proceder con su implementación detallada en los pasos siguientes:

- Autoría y Mantenimiento: Se especificaron los campos author y maintainer en los archivos library.properties, definiendo a los creadores y al responsable de futuras actualizaciones.
- Licencia de Uso: Se seleccionó la Licencia MIT, una licencia de código abierto permisiva que facilita el uso, modificación y distribución (incluso comercial) del código, requiriendo únicamente la atribución y la inclusión de la licencia original. Se añadió un archivo LICENSE a cada repositorio.
- Versionado: Se adoptó el Versionado Semántico (MAYOR.MENOR. PARCHE) para gestionar las versiones de las librerías (ej. 0.1.0, 1.0.0). Esto permite comunicar claramente la naturaleza de los cambios entre versiones (correcciones, nuevas características compatibles, cambios incompatibles).
- Documentación (README.md): Se creó un archivo README.md completo para cada librería, detallando su propósito, características, instalación, dependencias y ejemplos de uso.
- Ejemplos Prácticos (examples/): Se incluyeron sketches .ino funcionales en la carpeta examples/, siguiendo la estructura requerida por el IDE, para demostrar el uso básico de cada librería .

### Proceso técnico de publicación

La publicación involucró los siguientes pasos técnicos:

1. Repositorios Dedicados en GitHub: Cada librería se alojó en su propio repositorio Git público, incluyendo un archivo .gitignore para excluir archivos innecesarios (véase en la Ilustración 36. Librerías añadidas a repositorio remoto en Github.com).

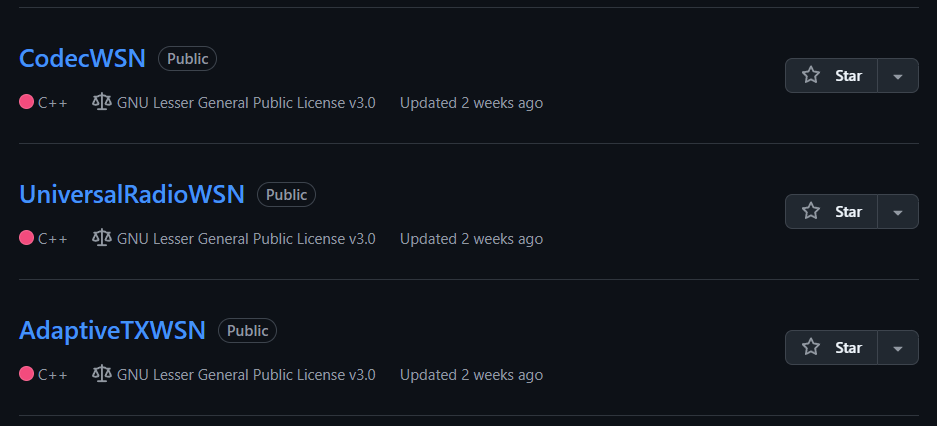
[picture p24: figure]

Ilustración 36. Librerías añadidas a repositorio remoto en Github.com

2. Commit y Push Inicial: Se versionó la estructura completa de la librería (código en src/, ejemplos, README.md, library.properties, LICENSE) y se subió a GitHub.
3. Creación de "Release Tag": Se creó un release en GitHub para cada librería. Es fundamental que el nombre del tag de este release coincidiera exactamente con el valor del campo version en el library.properties correspondiente, esto es apreciable en la Ilustración 37. Librería AdaptiveTXWSN en Github con versionado y Release correspondiente.

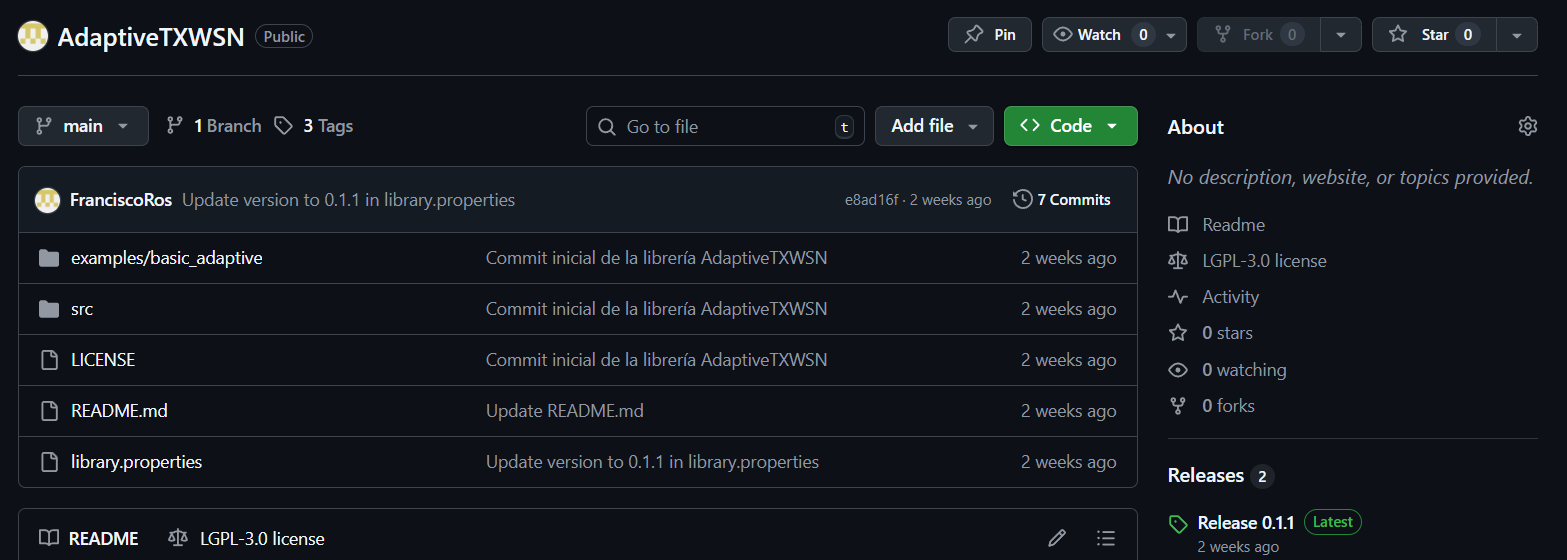
[picture p25: figure]

Ilustración 37. Librería AdaptiveTXWSN en Github con versionado y Release correspondiente

4. Solicitud vía "Pull Request": Se realizó un "Fork" del repositorio arduino/library-registry. En esta copia personal, se editó el archivo repositories.txt para añadir las URLs de los repositorios de nuestras librerías (en orden alfabético). Posteriormente, como es observable en la Ilustración 22, se envió un "Pull Request" desde el fork al repositorio original de Arduino, solicitando formalmente la inclusión y fue rápidamente aprobado debido a la cuidadosa atención que pusimos a la construcción de nuestros archivos.

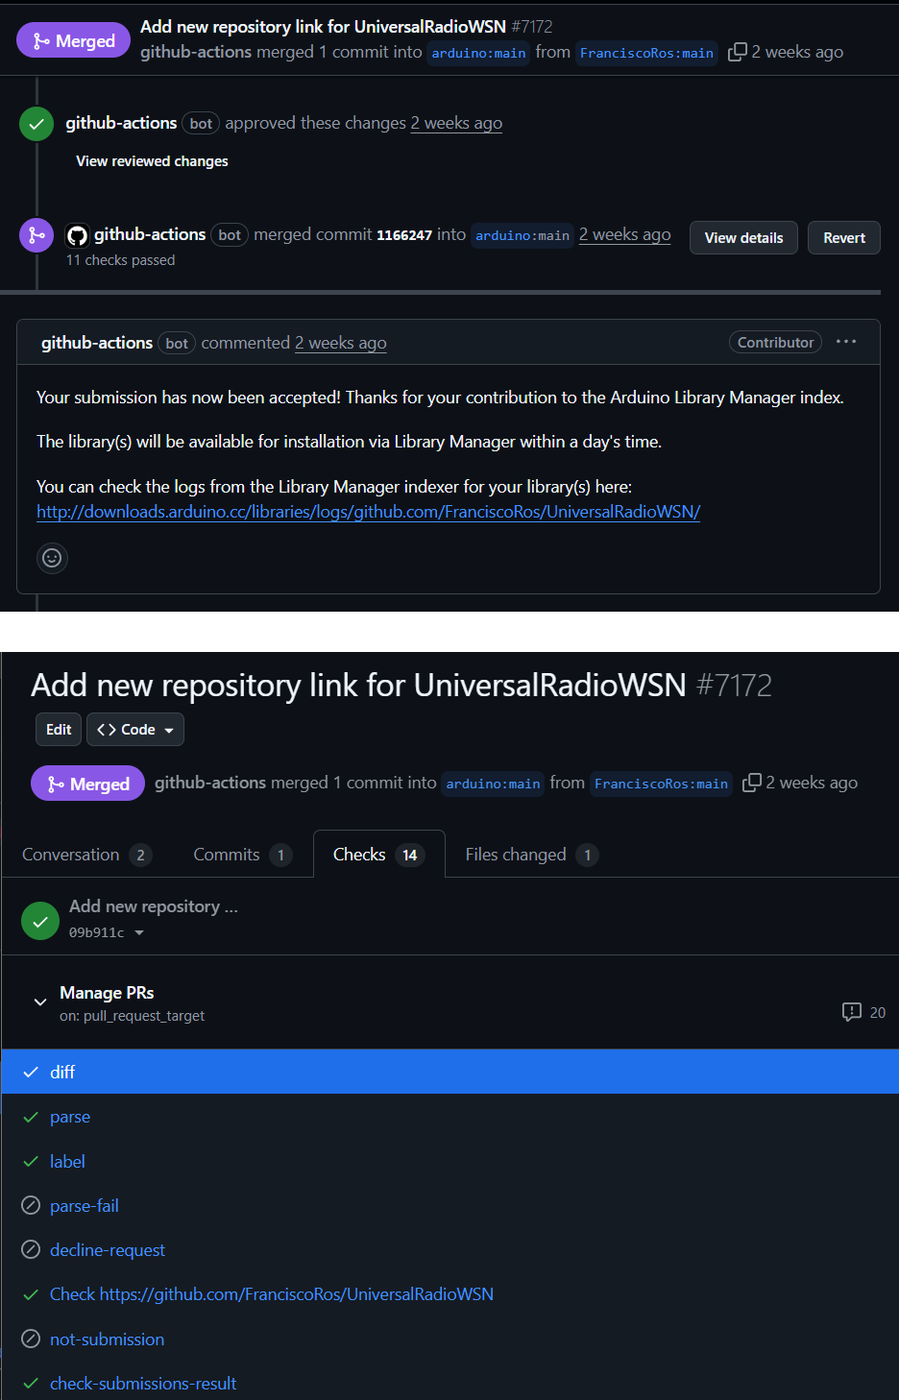
[picture p26: figure]

Ilustración 38. Creación y aceptación del pull request al repositorio oficial de Arduino

5. Gestión de Dependencias: Dado que EnergyWSN depende de UniversalRadioWSN, el proceso se realizó en dos etapas: primero se solicitó la inclusión de las librerías base (AdaptiveTXWSN, CodecWSN, UniversalRadioWSN). Una vez que este primer Pull Request fue aprobado y fusionado ("merged") por el bot de Arduino, se creó un segundo Pull Request exclusivo para EnergyWSN. Esto aseguró que el bot pudiera validar correctamente la dependencia.

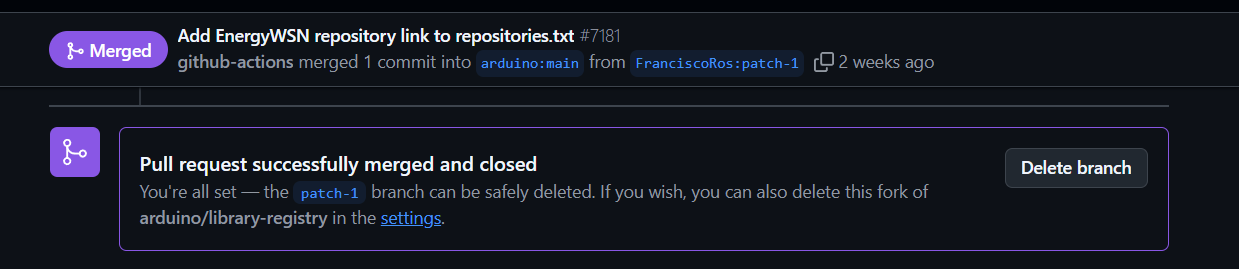
[picture p27: figure]

Ilustración 39. Merged donde se añadió EnergyWSN al repositorio oficial de Arduino

### Importancia y beneficios

La indexación final de las librerías en el Arduino Library Manager valida el enfoque modular y el objetivo de contribución del proyecto. Los beneficios principales son:

- Acceso Simplificado: Usuarios de todo el mundo pueden encontrar e instalar las librerías directamente desde el IDE de Arduino.
- Mantenimiento Facilitado: Futuras actualizaciones se distribuyen creando nuevos releases, y el IDE notifica a los usuarios.
- Validación Implícita: El proceso de registro confirma que las librerías cumplen con la estructura y requisitos básicos de Arduino.
- Mayor Visibilidad e Impacto: Al estar en el registro oficial, se incrementa la probabilidad de adopción en otros proyectos, ampliando el alcance de las soluciones energéticas desarrolladas.

En definitiva, la publicación formal transforma los componentes de software de este proyecto en herramientas accesibles y estandarizadas, disponibles para la comunidad de Arduino interesada en mejorar la eficiencia y sostenibilidad de las Redes de Sensores Inalámbricos.

Pruebas de confianza

Para evaluar la eficiencia y fiabilidad de la red de sensores inalámbricos, se ejecutaron tres escenarios de prueba secuenciales. Cada escenario implementó un nivel incremental de complejidad en el protocolo de comunicación Xbee, permitiendo un análisis detallado del impacto de diferentes técnicas de transmisión de datos. Para garantizar una comparación equitativa, los resultados de todas las pruebas se ajustaron a un periodo de operación de una hora.

## Pruebas de paneles solares

### Montaje del entorno de pruebas

Para la validación experimental del sistema, se desplegó un entorno de pruebas controlado. Este entorno consistió en la instalación de los nodos sensores anteriormente ensamblados y calibrados. Adicionalmente, se diseñó e implementó un componente crítico para la adquisición de datos: un nodo "Logger" centralizado.

La función principal de este nodo Logger es actuar como una estación de registro, encargado de recopilar y almacenar de forma síncrona un conjunto de métricas operativas y ambientales. Los parámetros clave registrados por este nodo son:

- Timestamp (Fecha y hora de la medición)
- Voltaje_Panel (Tensión del panel solar)
- Corriente_Panel (Corriente generada por el panel)
- Potencia_Panel (Potencia calculada)
- Voltaje_Bateria (Tensión actual de la batería)
- Consumo_Nodo (Corriente consumida por el nodo)
- Irradiancia_Solar (Estimación de la intensidad lumínica)
- Temperatura (Temperatura ambiente en la ubicación del nodo)

### Arquitectura del Logger

El nodo Logger se ha implementado utilizando un microcontrolador Arduino Nano como unidad central de procesamiento. Para la captura de las diversas métricas, se integró un conjunto de sensores específicos:

- Sensor de Temperatura y Humedad (DHT22): Se utiliza para registrar la Temperatura ambiental en las proximidades del nodo, un factor que puede influir en el rendimiento tanto del panel solar como de la batería.
- Sensor de Corriente (ACS712): Este sensor de efecto Hall se emplea para medir con precisión la Corriente_Panel generada y el Consumo_Nodo en tiempo real.
- Fotorresistencia (LDR): Se utiliza como un indicador proxy para estimar la Irradiancia_Solar relativa. Aunque no proporciona una medición en $W/m^2$, ofrece una correlación fiable con la intensidad de la luz solar incidente.
- Medición de Voltaje: Para la lectura del Voltaje_Panel y el Voltaje_Bateria (cuyos valores superan el límite de 5V del Arduino), se implementaron divisores de voltaje calibrados para escalar la tensión a un rango seguro para el convertidor analógico-digital (ADC) del microcontrolador.
- Cálculo de Potencia: La Potencia_Panel no se mide directamente, sino que se calcula en el firmware mediante la fórmula:

P=V*I

Utilizando los valores de Voltaje_panel y Corriente_Panel

El esquema de conexión detallado que interconecta estos componentes con el Arduino Nano se presenta en la Tabla 5. Pinout del nodo Logger y en la Ilustración 40. Nodo Logger

Señal / Componente | Pin Arduino | Descripción
ACS712 (Panel) VCC | 5V | Alimentación del sensor de corriente del panel.
ACS712 (Panel) GND | GND | Tierra del sensor de corriente del panel.
ACS712 (Panel) OUT | A2 | Señal analógica (0-5V) que representa la corriente del panel.
ACS712 (Nodo) VCC | 5V | Alimentación del sensor de corriente del nodo.
ACS712 (Nodo) GND | GND | Tierra del sensor de corriente del nodo.
ACS712 (Nodo) OUT | A3 | Señal analógica (0-5V) que representa la corriente del nodo.
Juntura Divisor Batería | A0 | Señal analógica que mide el voltaje de la batería.
Juntura Divisor Panel | A1 | Señal analógica que mide el voltaje del panel.
Juntura Divisor LDR | A4 | Señal analógica que mide el nivel de luz.
DHT22 VCC | 5V | Alimentación del sensor de temperatura y humedad.
DHT22 GND | GND | Tierra del sensor de temperatura y humedad.
DHT22 DATA | D2 | Pin de datos digital para leer el sensor.
Tierra Común | GND | Un cable GND del Logger debe ir al GND del sistema UPS.

Tabla 5. Pinout del nodo Logger

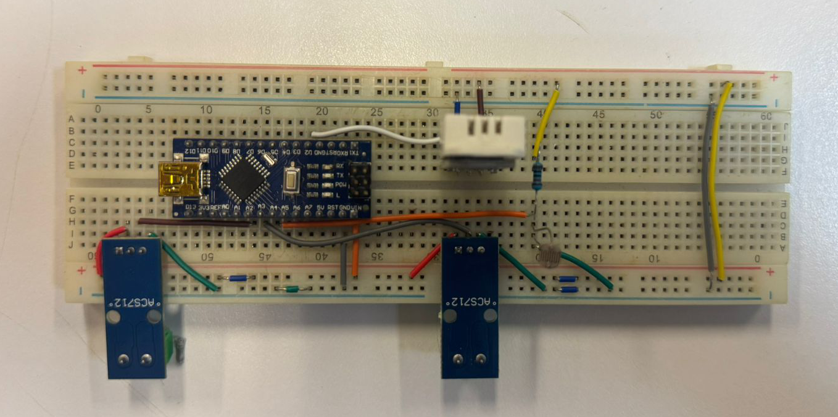
[picture p28: figure]

Ilustración 40. Nodo Logger

### Flujo de Trabajo del Software y Almacenamiento

Para gestionar la recolección y el almacenamiento de los datos, se desarrolló una solución de software de dos componentes:

1. LoggerPanelSolar: Este es el programa que se ejecuta en el Arduino Nano. Es responsable de inicializar todos los sensores, realizar lecturas a intervalos predefinidos, ensamblar todos los puntos de datos en una trama coherente (incluyendo el timestamp) y transmitir dicha trama a través del puerto serie (USB).
2. LoggerPanelSolarPython: Se trata de un script de Python que se ejecuta en un ordenador anfitrión (como una PC o una Raspberry Pi) conectado al Arduino Nano. Este script cumple varias funciones:
  - Escucha continuamente el puerto serie para recibir los datos enviados por el Arduino.
  - Analiza (parsea) la trama de datos recibida para extraer cada métrica individual.
  - Formatea los datos y los añade como una nueva fila a un archivo de formato CSV.

Este enfoque de almacenamiento en un archivo .csv es fundamental, ya que crea una base de datos estructurada y fácilmente portable, ideal para el análisis y la visualización de datos posteriores.

El objetivo de generar este archivo .csv es poder realizar un análisis detallado del rendimiento, consumo y autonomía del sistema. Dado que la mayoría de los datos recopilados son series temporales.

### Caracterización y Comparación de Paneles

Objetivo:

Determinar la eficiencia relativa y la capacidad de generación de energía de dos modelos de paneles solares (PV-Rl-35 y cnc165x135) bajo condiciones de operación reales, evaluando su rendimiento tanto en situaciones óptimas como en escenarios de obstrucción parcial.

Materiales y Montaje Experimental

Para asegurar una comparativa justa, se prepararon dos montajes idénticos que solo diferían en el modelo del panel solar.

Componentes Comunes:

Módulo de Carga: Se empleó Ilustración 21. Módulo UPS18650 para cada sistema. Este componente es fundamental ya que gestiona la carga de las baterías desde el panel solar y la alimentación de salida al nodo.

Banco de Baterías: Cada módulo se equipó con un par de baterías de Iones de Litio (Li-ion) modelo 18650, con un voltaje nominal de 3.7V y una capacidad de 4000 mAh cada una. Asumiendo una conexión en paralelo (estándar para estos módulos), esto resulta en un banco de baterías con una capacidad total de 8000 mAh (o 29.6 Wh).

Paneles Solares a Prueba:

Panel A: Modelo PV-Rl-35 Ilustración 19. Medición de la generación del panel solar pv-rl-35 con un voltaje de operación nominal de 6.9V.

Panel B: Modelo cnc165x135 Ilustración 20. Medición de la generación del panel solar cnc165x135, con un voltaje de operación nominal de 6V

Metodología de Prueba

Se realizaron mediciones directas de la corriente de generación en un día soleado para cuantificar el rendimiento de cada panel bajo diferentes escenarios.

Instrumentación: Se utilizó un multímetro en modo amperímetro, conectado en serie entre la salida del panel solar y la entrada del módulo de carga USP 1850.

Escenarios de Medición:

Demanda Máxima: Se midió la corriente con las baterías en un estado de descarga, simulando la condición de carga principal durante el día.

Saturación: Se midió la corriente cuando las baterías estaban casi cargadas (próximas al 100%).

Obstrucción Parcial: Se cubrió aproximadamente el 40% de la superficie de las celdas de cada panel para simular el impacto de sombras, hojas o suciedad.

Resultados y Análisis de Carga

Las mediciones arrojaron los siguientes datos de rendimiento, que se utilizan para calcular la potencia generada (P=V*I) y estimar los tiempos de carga teóricos.

Nota sobre el Cálculo de Carga: El tiempo de carga se estima dividiendo la energía total del banco de baterías (29.6 Wh) por la potencia de entrada del panel, asumiendo una eficiencia de conversión del 85% en el módulo de carga USP 1850.

Formula:

Tiempo =(26.9Wh)/((Potencia Panel W*0.85))

Panel A (PV-Rl-35 - 6.9V):

Demanda Máxima: Generó 1.4 A.

Potencia: 6.9V*1.4A=9.66W

Cálculo de Tiempo (Ideal): (26.9Wh)/((9.66W*0.85))≈ 3.60 Horas

Saturación: La corriente bajó a 0.2 A, indicando que el módulo de carga funciona correctamente para proteger las baterías al reducir la corriente en la etapa final de carga.

Obstrucción (40%): La corriente se mantuvo en un rango de 0.44 A – 0.56 A (promedio 0.5 A).

Potencia (Obstruido): 6.9V* 0.5A=3.45W

Cálculo de Tiempo (Obstruido): (26.9Wh)/((3.45W*0.85))≈ 10.10 Horas

Panel B (cnc165x135 - 6V):

Demanda Máxima: Generó 0.8 A.

Potencia: 6.0V*0.8A = 4.80 W

Cálculo de Tiempo (Ideal): (26.9Wh)/((4.8W*0.85))≈ 7.25Horas

Saturación: Al igual que el Panel A, la corriente bajó a 0.2 A al estar las baterías casi cargadas.

Obstrucción (40%): La corriente cayó a un rango de 0.2 A – 0.35 A (promedio 0.275 A).

Potencia (Obstruido): 6.0V*0.275A = 1.65 W

Cálculo de Tiempo (Obstruido): (26.9Wh)/((1.65W*0.85))≈ 21.14 Horas

En la Tabla 6. Comparación de paneles solares podemos observar la comparativa de rendimiento entre ambos paneles solares:

Parámetro de Medición | Panel A (PV-Rl-35) | Panel B (cnc165x135)
Voltaje Nominal | 6.9 V | 6.0 V
Corriente Máxima (Batería Descargada) | 1.4 A | 0.8 A
Potencia Máxima Teórica (P=VI) | 9.66 W | 4.80 W
Corriente (Batería Casi Cargada) | 0.2 A | 0.2 A
Corriente (40% Obstruido) | 0.44 A – 0.56 A | 0.2 A – 0.35 A
Potencia (40% Obstruido) | 3.45 W (promedio) | 1.65 W (promedio)
Tiempo de Carga Teórico (Ideal) | ~3.60 horas | ~7.25 horas
Tiempo de Carga Teórico (40% Obstruido) | ~10.10 horas | ~21.14 horas

Tabla 6. Comparación de paneles solares

También se puede apreciar en la Ilustración 41. Medición de la generación del panel solar pv-rl-35y la Ilustración 42. Medición de la generación del panel solar cnc165x135como se realizaron las pruebas físicas reales con el multímetro pudiéndose ver el módulo UPS18650 que se ve con mayor detalle en la Ilustración 43. Módulo UPS18650

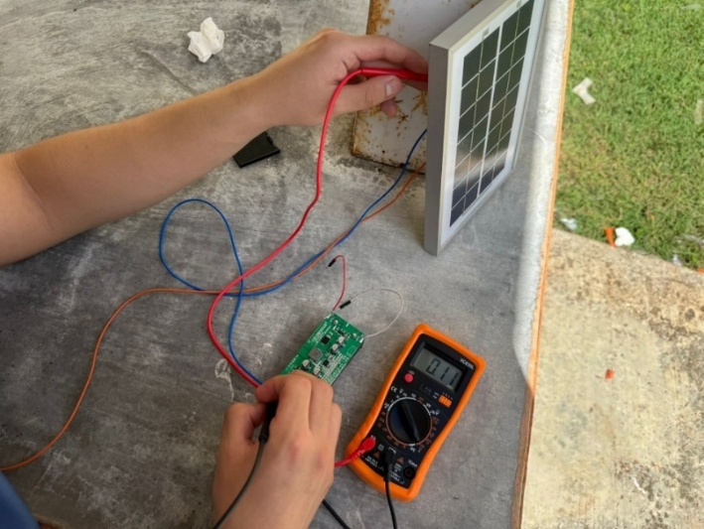
[picture p29: figure]

Ilustración 41. Medición de la generación del panel solar pv-rl-35

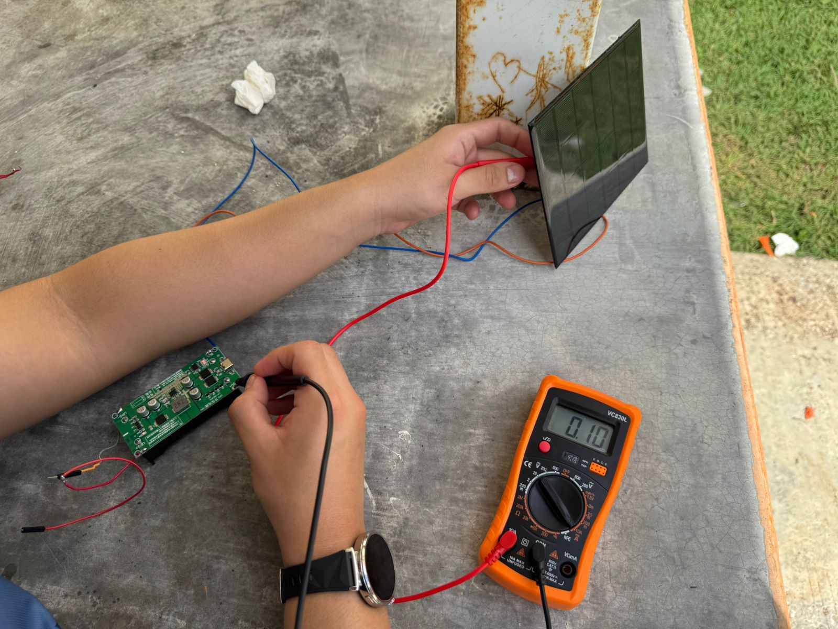
[picture p30: figure]

Ilustración 42. Medición de la generación del panel solar cnc165x135

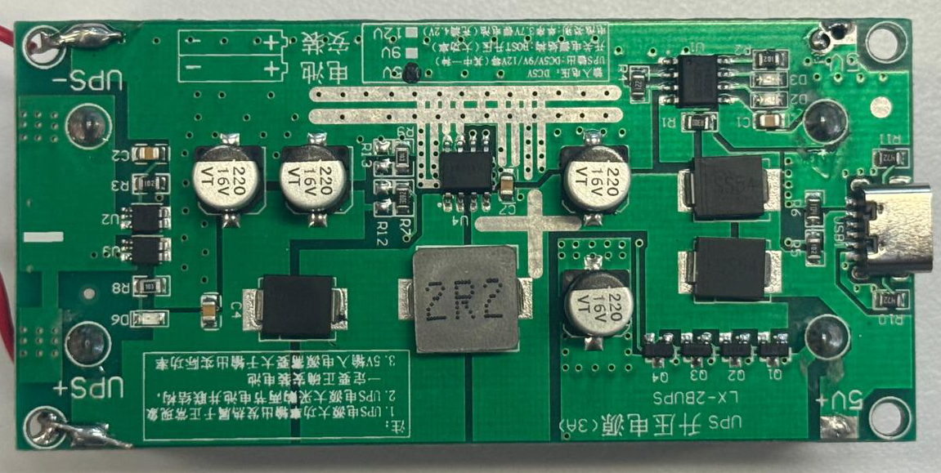
[picture p31: figure]

Ilustración 43. Módulo UPS18650

Conclusiones del análisis:

Rendimiento Máximo: El panel PV-Rl-35 (Panel A) demostró una capacidad de generación de corriente y potencia significativamente superior (1.4 A / 9.66 W) en comparación con el panel cnc165x135 (Panel B) (0.8 A / 4.80 W), bajo condiciones de máxima demanda.

Comportamiento del Módulo de Carga: Se observó un comportamiento importante del módulo de carga USP 1850. A medida que las baterías se acercaban a su carga completa, el módulo reducía activamente la corriente de entrada a 0.2 A en ambos casos. Esta es una característica de protección esencial de los controladores de carga de Li-ion (carga de voltaje constante), que previene la sobrecarga y mejora la salud y longevidad de las baterías.

# Resultados

En este capítulo se presentan los resultados cuantitativos obtenidos tras la ejecución de las pruebas de eficiencia energética, fiabilidad de comunicación y recolección de energía. Los datos expuestos permiten validar el impacto de las estrategias de optimización implementadas, tanto a nivel de hardware como de software, frente a la configuración base del sistema.

La evaluación del consumo energético demostró que la combinación de optimizaciones de software (librerías CodecWSN, EnergyWSN, AdaptiveTXWSN) junto con la actualización de hardware (uso de reguladores conmutados MP1584) genera un incremento drástico en la autonomía operativa de los nodos sensores.

El uso de la librería CodecWSN redujo significativamente el tiempo de actividad (duty cycle) del microcontrolador y del radio. En las pruebas específicas con tecnología LoRa, el tiempo de transmisión activo disminuyó de 88 milisegundos en la versión base a tan solo 45.8 milisegundos utilizando la codificación binaria. Esta reducción del tiempo de transmisión disminuyó el consumo de trabajo, liberando el canal de comunicación más rápidamente.

Sin embargo, el impacto más notable provino de la librería EnergyWSN. La implementación correcta de los modos de bajo consumo (Deep Sleep) permitió que la corriente en reposo se redujera drásticamente en comparación con el prototipo base, pasando de un consumo continuo a valores mínimos durante los intervalos de inactividad.

Al proyectar el consumo promedio calculado sobre la capacidad de las baterías, se obtuvieron las siguientes autonomías máximas teóricas para cada tecnología de comunicación evaluada:

LoRa: Se posicionó como la tecnología más eficiente. Partiendo de una autonomía base de apenas 2.5 días, la implementación de todas las mejoras (Hardware MP1584 + Software Completo) elevó la duración hasta un máximo de 37.86 días.

NRF24L01: Mostró un excelente desempeño, alcanzando una autonomía máxima de 20 días con un consumo en reposo mínimo de 10.5 mAh.

XBee: Aunque inicialmente fue el de mayor consumo con 1.76 días de base, las optimizaciones lograron extender su vida útil hasta 20 días. No obstante, su consumo en modo reposo optimizado se mantuvo en 19.27 mAh, siendo superior al de sus competidores.

Conclusión parcial: La tecnología LoRa, bajo la arquitectura propuesta, ofrece la mayor viabilidad para despliegues de larga duración.

Las pruebas de estrés de la red, realizadas mediante contadores de paquetes sincronizados en la memoria EEPROM, revelaron la robustez de los protocolos optimizados frente a las versiones base:

NRF24L01: Resultó ser el módulo más estable, con una tasa de pérdida de paquetes del 0% en el mejor escenario y una pérdida máxima del 1.52% en condiciones estándar.

LoRa: Demostró una alta consistencia y fiabilidad. La tasa de pérdida se redujo del 5% en la configuración base a solo 0.5% al aplicar las correcciones de software (Codec y Adaptive), confirmando su idoneidad para telemetría crítica.

XBee: Inicialmente presentó la mayor inestabilidad, con una pérdida de paquetes del 16.18% en la configuración base. Sin embargo, la implementación de las librerías AdaptiveTXWSN y CodecWSN corrigió drásticamente este comportamiento, reduciendo la tasa de error al 3.85%, lo que representa una mejora neta de fiabilidad superior al 12%.

En términos de estabilidad, analizada mediante diagramas de caja, LoRa mostró la distribución más compacta, indicando un comportamiento predecible y constante en comparación con la dispersión inicial de los otros protocolos.

Las pruebas de campo comparativas entre los dos paneles solares evaluados determinaron la capacidad de regeneración energética del sistema en condiciones reales.

Panel A (PV-Rl-35 - 6.9V): Generó una potencia máxima de 9.66 W (1.4 A), permitiendo un tiempo de carga teórico de 3.60 horas para el banco de baterías completo en condiciones ideales.

Panel B (cnc165x135 - 6V): Generó 4.80 W (0.8 A), requiriendo aproximadamente 7.25 horas para una carga completa.

Bajo condiciones de obstrucción parcial simulada (cubriendo el 40% del panel), el Panel A mantuvo una generación suficiente de 3.45 W para recargar el sistema en aproximadamente 10 horas, asegurando la sostenibilidad del nodo incluso en días con condiciones lumínicas subóptimas.

A pesar de los resultados positivos, el análisis instrumental detectó componentes de hardware que limitan la autonomía máxima teórica. Se identificaron tres fuentes principales de consumo parásito que no pueden ser mitigadas por software:

Regulación de Voltaje Secundaria: El regulador lineal utilizado para bajar de 5V a 3.3V, necesario para el radio, consume 5.95 mA constantes, anulando parcialmente el beneficio del modo de sueño del radio.

Regulador Principal (MP1584): Aunque eficiente, presenta un consumo en vacío de 0.56 mA.

Indicadores LED: Los LEDs de estado integrados en los módulos comerciales de sensores representan una fuga de corriente constante e incontrolable en el prototipo actual.

Estos hallazgos indican que, para superar la barrera de los 38 días y alcanzar autonomías de meses, es necesario transitar del uso de módulos de desarrollo a un diseño de PCB personalizado.

## Análisis de resultados

A partir de los datos expuestos, se realiza un análisis crítico para validar el cumplimiento de los objetivos planteados y contrastar las hipótesis de diseño con la realidad experimental.

El objetivo general del proyecto establecía una meta de reducción del consumo de al menos un 30% en un periodo de pruebas. Los resultados obtenidos superan ampliamente esta expectativa. Al comparar el nodo LoRa en su estado base, con una duración aproximada de 2.5 días, contra la versión optimizada que alcanza 37.86 días, se observa un incremento en la autonomía superior al 1400%.

Esto valida que la estrategia de atacar el consumo desde tres frentes simultáneos (compactación de datos, gestión de hardware y transmisión adaptativa) es exponencialmente más efectiva que la aplicación aislada de cualquiera de estas técnicas.

El análisis revela una discrepancia crítica entre la eficiencia del código y la ineficiencia del hardware comercial utilizado en el prototipo. Mientras que el software logra reducir el consumo del microcontrolador y el radio a niveles de microamperios durante el sueño profundo, los componentes auxiliares del módulo de desarrollo mantienen un consumo base de aproximadamente 6 mA debido a los parásitos detectados.

Este hallazgo es fundamental porque identifica el límite físico del prototipo actual. La autonomía máxima obtenida no es el límite de la lógica de programación, sino el límite impuesto por el hardware. Esto confirma que para transiciones a productos industriales, la migración a una PCB personalizada con componentes de ultra bajo consumo es el paso obligatorio.

Una de las principales preocupaciones al implementar modos de sueño profundo es la posible pérdida de sincronización y datos. Sin embargo, las pruebas de fiabilidad demostraron que el protocolo diseñado (con tramas y CRC) mantiene la integridad de la red.

El hecho de que el módulo NRF24L01 alcanzara un 0% de pérdida y LoRa un 0.5% bajo condiciones de estrés, valida que es posible apagar el sistema la mayor parte del tiempo sin sacrificar la calidad de la telemetría. El caso de XBee, que mejoró su fiabilidad drásticamente gracias a las correcciones de software, demuestra que la lógica de reintento y validación en la librería UniversalRadioWSN es capaz de compensar inestabilidades propias del hardware.

La integración de los paneles solares cierra el ciclo de sostenibilidad. Con un consumo promedio del sistema optimizado en el rango de los miliamperios bajos, y una generación del Panel A superior a los 9 W, el balance energético es positivo. El sistema genera sustancialmente más energía durante las horas solares de la que consume en un ciclo de 24 horas. Esto implica que, teóricamente, el nodo ha alcanzado la perpetuidad operativa, limitada únicamente por la vida útil química de las baterías y no por el consumo diario del dispositivo.

## Pruebas de Fiabilidad de la Comunicación

Para validar la fiabilidad de la comunicación, definimos un conjunto de parámetros clave: configuración (Software/Radio), flujo de datos (Paquetes Enviados/Recibidos/Perdidos) y rendimiento (Tasa de Éxito/Pérdida, Paquetes por Segundo y Eficiencia).

La siguiente fase consistió en pruebas de conexión simultánea de 10 minutos, con transmisiones periódicas cada 3 segundos. Se adoptó un enfoque incremental para medir la evolución de la estabilidad, partiendo de una versión base y añadiendo progresivamente nuestras librerías especializadas (codecWSN, energyWSN y adaptiveTXWSN) junto con mejoras de hardware ligadas a nuestra librería EnergyWSN (Mosfet y pin de control de corriente). Esto permitió calcular con precisión la robustez y eficiencia respecto a la configuración inicial.

Si bien la fase experimental fue tediosa, demandando múltiples ciclos de reconfiguración, carga de firmware y medición temporal en cada prototipo, los resultados finales son altamente satisfactorios. La validación cuantitativa presentada en la tabla muestra la efectividad de las estrategias implementadas y establece una base sólida para el desarrollo del proyecto.

Todos estos datos fueron recopilados y organizados en una hoja de cálculo, cuyos resultados finales se pueden apreciar en el Anexo B (Anexo_B_Pruebas_De_Fiabilidad.xlsx)

## Análisis de los resultados de las pruebas de fiabilidad

El análisis de los resultados evidencia una clara superioridad de los protocolos NRF24L01 y LoRa, los cuales demostraron una alta fiabilidad con tasas de éxito entre el 95% y el 100% (pérdidas inferiores al 5%). En contraste, el módulo XBee presentó un desempeño inferior, con una tasa de éxito fluctuante entre el 83% y el 97% y pérdidas de hasta un 16. Como se puede observar en la Ilustración 27. Comparación entre NRF, XBEE y LoRa

Ilustración 27. Comparación entre NRF, XBEE y LoRa

En cuanto al rendimiento individual, el NRF24L01 se posicionó como la opción más robusta del conjunto de pruebas. Como se evidencia en la Ilustración 28. Porcentaje de pérdida NRF24L01 este módulo destacó por mantener un porcentaje de pérdida excepcionalmente bajo, alcanzando mínimos de apenas 1.52%. Este resultado no solo valida la estabilidad operativa del hardware, sino que representa un rendimiento prácticamente impecable, demostrando que el protocolo es capaz de sostener una comunicación fluida y fiable incluso durante periodos prolongados de transmisión.

Ilustración 28. Porcentaje de pérdida NRF24L01

Por otro lado, al examinar la integridad de los datos en la Ilustración 29. Integridad de datos NRF24L01, la eficiencia del emisor fue sobresaliente. En los escenarios de transmisión continua, se logró una tasa de entrega perfecta, llegando a no perder información alguna durante su ciclo de trabajo completo. Incluso bajo las configuraciones más complejas de gestión energética, como adaptiveWSN y energyWSN, las pérdidas fueron marginales (registrando un máximo de solo 2 paquetes); este comportamiento es esperable y se atribuye a la latencia natural de recalibración del módulo al reactivar el radio desde el modo de suspensión (wake-up latency), un compromiso técnico insignificante frente a la eficiencia energética obtenida.

Ilustración 29. Integridad de datos NRF24L01

El módulo LoRa demostró un comportamiento equilibrado y altamente fiable, posicionándose en un punto intermedio estratégico respecto a sus competidores. En su configuración base, presentó un margen de pérdida manejable del 5%, el cual se redujo drásticamente hasta un 0.5% tras implementar todas nuestras optimizaciones de software (librerías codec y adaptive) como se puede observar en la Ilustración 30. Porcentaje de pérdida LoRa. Este descenso en la tasa de error no solo valida la eficacia de la programación, sino que destaca la excelente consistencia de envío de la tecnología LoRa, la cual respondió de manera superior a las estrategias de modulación y gestión de paquetes en comparación con la inestabilidad inicial observada en otros protocolos.

Ilustración 30. Porcentaje de pérdida LoRa

En términos de integridad y estabilidad de la señal, el escenario base registró una pérdida máxima de 10 paquetes por ciclo de trabajo. Sin embargo, la aplicación de nuestras mejoras logró mitigar este fenómeno casi en su totalidad, reduciendo la pérdida a tan solo 1 paquete (una mejora efectiva del 90% en la retención de datos) como se observa en la Ilustración 31. Integridad de datos LoRa. Estos resultados confirman que LoRa no solo es una opción viable, sino la candidata ideal para implementaciones en sistemas de largo alcance o en áreas donde el monitoreo es crítico y la pérdida de información no es una opción aceptable.

Ilustración 31. Integridad de datos LoRa

En contraste con la estabilidad inmediata de sus competidores, el módulo XBee presentó los mayores desafíos iniciales en cuanto a la fiabilidad de la transmisión. En su configuración base, este protocolo exhibió una vulnerabilidad significativa, registrando una tasa de pérdida de paquetes del 16.18%, un margen de error considerablemente alto para aplicaciones de telemetría crítica. Sin embargo, este escenario sirvió para demostrar la eficacia de nuestras optimizaciones de software. Al implementar la configuración Adaptive + Codec, se logró una mejora drástica, mitigando la pérdida de paquetes casi en su totalidad (una reducción efectiva cercana al 100% del error). Incluso en las configuraciones intermedias, se observaron mejoras consistentes superiores al 50%, validando que la gestión por software puede compensar las limitaciones inherentes de la configuración estándar del hardware, tal como se aprecia en la Ilustración 32. Porcentaje de pérdida Xbee.

Ilustración 32. Porcentaje de pérdida Xbee

En lo que respecta a la integridad de los paquetes, el XBee mostró inicialmente una degradación de datos superior a la de los otros protocolos, contabilizando hasta 33 paquetes perdidos en el modelo básico. No obstante, la aplicación de nuestras librerías transformó radicalmente este comportamiento. En su mejor configuración, la pérdida se redujo a tan solo 2 paquetes, una cifra competitiva y funcionalmente insignificante. Como se observa en la Ilustración 33. Integridad de paquetes Xbee, estos resultados son motivo de gran satisfacción para el equipo, pues confirman que nuestras mejoras no solo optimizaron el sistema, sino que lograron estabilizar un radio que inicialmente presentaba un comportamiento errático, haciéndolo viable para el despliegue final.

Ilustración 33. Integridad de paquetes Xbee

Al examinar la Ilustración 34. Comparativa de Estabilidad de los Radios, se puede realizar un análisis de la estabilidad de cada protocolo. En este tipo de gráfico, la altura de la caja representa la dispersión o variabilidad de los datos: una caja extensa indica un comportamiento inestable e impredecible, mientras que una caja compacta denota una alta consistencia en el rendimiento. Bajo este criterio, LoRa asume claramente la delantera. Su representación gráfica muestra la distribución más estrecha y controlada del conjunto, evidenciando que, a diferencia de los otros protocolos, mantiene sus tasas de transmisión dentro de márgenes mínimos y predecibles, consolidándose como la opción más estable del grupo.

Ilustración 34. Comparativa de Estabilidad de los Radios

Tras la implementación integral de las mejoras, se observa una notable convergencia en el rendimiento de los distintos módulos, contrastando significativamente con la dispersión inicial mostrada en la Ilustración 27. Comparación entre NRF, XBEE y LoRa. En esta fase final, detallada en la Ilustración 35. Comparación con Mejoras, la brecha de eficiencia entre los protocolos se redujo drásticamente. El NRF24L01 alcanzó la excelencia técnica con una tasa de pérdida del 0%, seguido muy de cerca por LoRa con un 0.5%, lo que representa una mejora neta del 4.5% respecto a su línea base. Sin embargo, el caso más destacado fue el del XBee, que logró reducir su tasa de error en un impresionante 12.33%, estabilizándose en un competitivo 3.85%.

Ilustración 35. Comparación con Mejoras

En conclusión, la evidencia experimental confirma que la estrategia de optimización conjunta de hardware y software ha sido un éxito rotundo. Se logró mitigar drásticamente las tasas de pérdida de paquetes en todas las plataformas evaluadas, validando la capacidad de estos módulos para sostener una comunicación eficaz, robusta y confiable durante periodos operativos prolongados, cumpliendo así con los estándares requeridos para el sistema.

## Pruebas de la Eficiencia energética

Para las pruebas de consumo energético, la herramienta principal fue el multímetro digital. Con el fin de asegurar la confiabilidad y precisión de los datos obtenidos, implementamos una práctica de validación cruzada: las mediciones clave se realizaron utilizando dos multímetros simultáneamente. Este método nos permitió corroborar que las lecturas de ambos instrumentos fueran consistentes, descartando así posibles errores debidos a la calibración o a un mal funcionamiento de uno de los equipos.

La técnica de medición consistió en configurar los multímetros para medir corriente, en la escala de amperios, y conectarlos en serie al circuito de alimentación del nodo. De esta manera, toda la corriente que consume el prototipo se ve obligada a pasar a través del instrumento, permitiéndonos registrar el consumo exacto en un momento dado. Este procedimiento requirió de nuestras habilidades y juicio técnico, ya que una conexión incorrecta, como colocar el amperímetro en paralelo, provocaría un cortocircuito que podría dañar el fusible del multímetro o el propio circuito. Fue fundamental verificar siempre la correcta configuración antes de energizar el sistema.

En la Ilustración 17. Medición de consumo en estado de trabajo en el nodo sensor sin modificarse puede apreciar una de las mediciones que realizamos, donde se registra el consumo del nodo durante la prueba de estado alto sostenido.

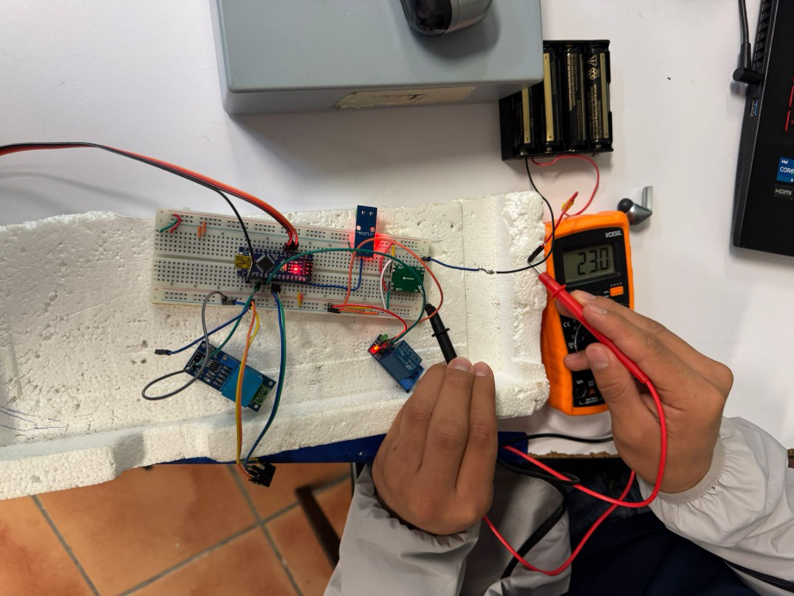
[picture p32: figure]

Ilustración 17. Medición de consumo en estado de trabajo en el nodo sensor sin modificar

A su vez, fue igualmente necesario medir el consumo del nodo en su estado de más bajo consumo. Para aislar esta medida, el procedimiento fue el mismo que para el estado activo: sin realizar ninguna modificación al hardware, simplemente cargamos en el microcontrolador un sketch temporal cuyo único propósito era poner el sistema en su estado de reposo inmediatamente después de arrancar.

Como se puede ver en la Figura 7, el resultado fue revelador y la diferencia en el consumo fue considerable. La corriente se desplomó desde lo que veíamos en el estado de trabajo, hasta casi la mitad. Estas mediciones preliminares, que realizamos como práctica para validar nuestra metodología, nos dieron una gran esperanza. Comprobar una caída tan significativa en el consumo del hardware base nos dio la confianza de que los prototipos optimizados, que combinan esta capacidad de reposo con una lógica de trabajo más eficiente, mostrarían una mejora aún mayor en la autonomía final.

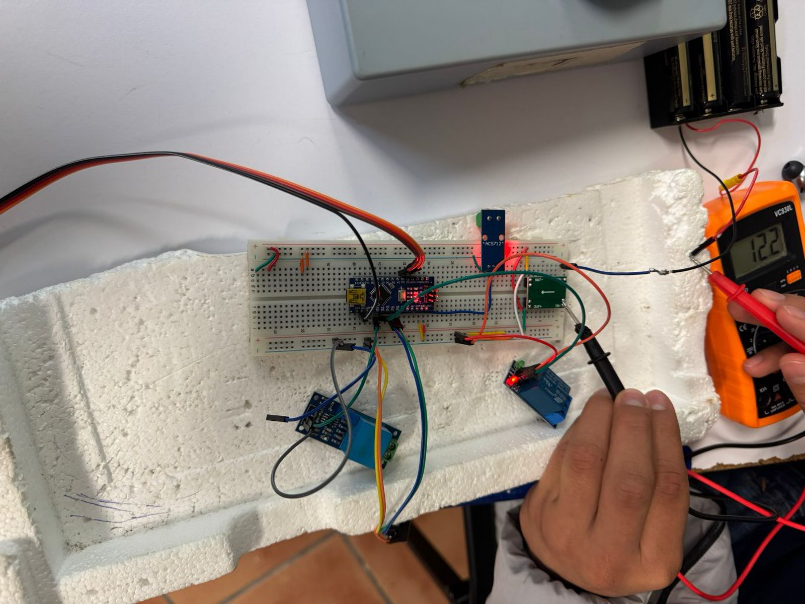
[picture p33: figure]

Ilustración 18. Medición de consumo en estado de delay en el nodo sensor

## Análisis de los resultados de las pruebas de consumo

Al analizar los resultados de la tabla, se puede observar una narrativa clara de cómo cada optimización contribuyó al objetivo final, es posible analizar a fondo esto en el Anexo A. Una de las primeras hipótesis que validamos fue el efecto de la librería CodecWSN por sí sola, esto se puede ver en la Ilustración 19. Al comparar el prototipo base con el prototipo que solo usaba el códec binario, notamos que el tiempo de trabajo HIGH (el pulso activo) se redujo significativamente. Por ejemplo, en los datos de LoRa, este tiempo bajó de 88ms a tan solo 45.8ms. Esta reducción del "tiempo en el aire" es muy valiosa: libera el canal de radio más rápido, reduce la probabilidad de colisiones en una red densa y, fundamentalmente, reduce el 'CONSUMO DE TRABAJO (mA * Ms)', lo que impacta directamente en un menor consumo total por ciclo.

Ilustración 19. Tiempo de trabajo por software en ms

Sin embargo, el primer gran salto en eficiencia, y la conclusión más importante, es que el uso de la librería EnergyWSN es indispensable. La diferencia entre un prototipo base y uno que implementa el modo de sueño es drástica. Como se ve en la Ilustración 20 el consumo en reposo se desploma, cambiando la autonomía estimada enormemente.

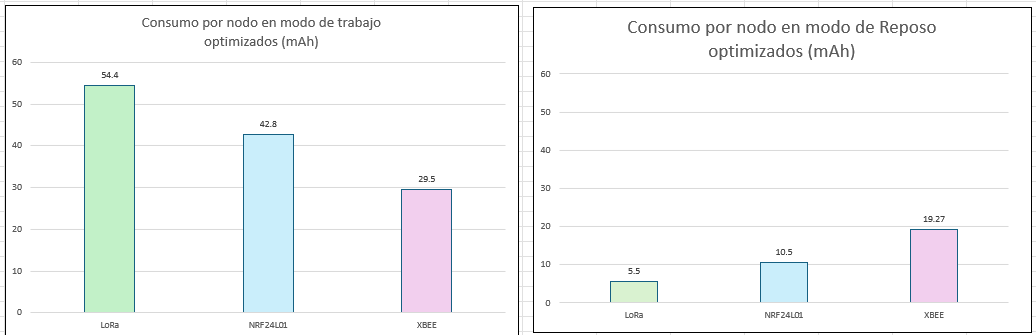
[picture p34: figure]

Ilustración 20. Comparación del consumo en los nodos en modos trabajo y descanso

Pero los datos también revelan que el software por sí solo no es la solución completa. La elección del hardware es fundamental. En todas las gráficas de esta sección, se observa que el regulador de voltaje step-down (MP1584) es mucho mejor que el regulador lineal básico (MB102). En casi todas las pruebas, el simple cambio del regulador básico al step-down multiplica la autonomía, convirtiéndolo en una decisión de hardware esencial.

El impacto combinado de estas optimizaciones se desglosa a continuación para cada tecnología de radio probada y se pueden ver en las gráficas siguientes

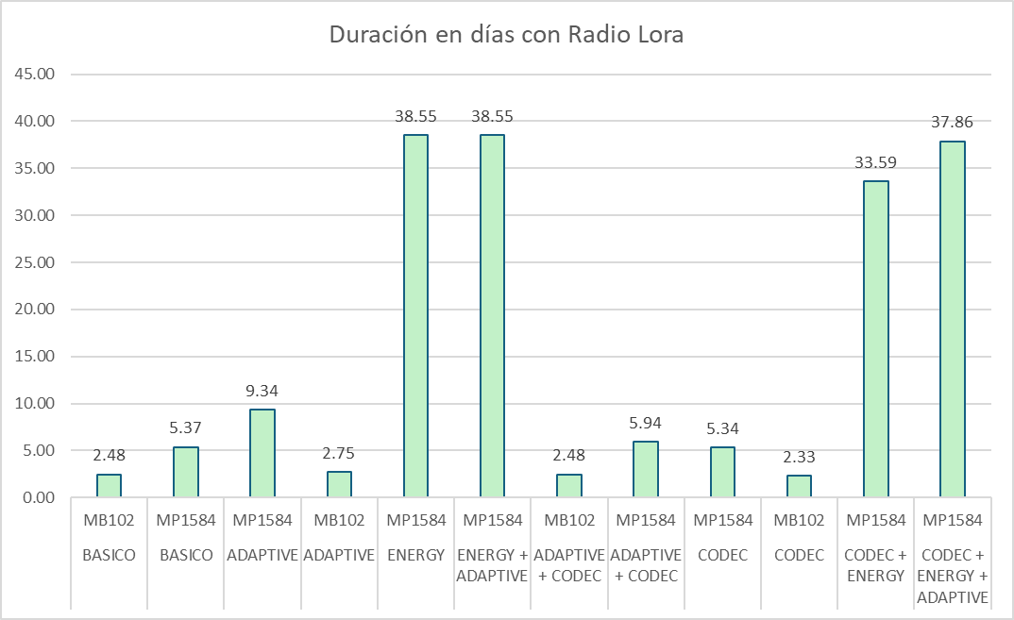
[picture p35: figure]

Ilustración 21. Duración en Días por Software- Harware para LoRa

Para la tecnología LoRa (ver Ilustración 21) los datos de la hoja de cálculo Anexo A (fila 8) muestran un incremento en la duración de 2.5 días (BASICO) a un máximo de 37.86 días con la configuración de todas nuestras optimizaciones juntas. Esto se correlaciona directamente con la reducción del consumo, que bajó de 84mA a un mínimo de 5.5mA en modo de reposo.

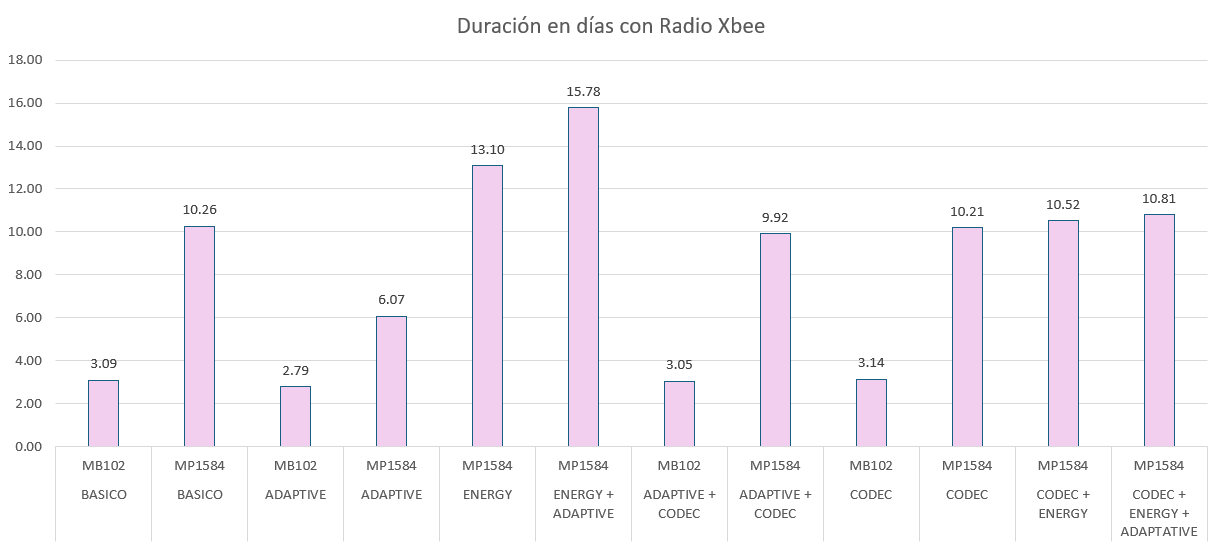
[picture p36: figure]

Ilustración 22. Duración en Días por Software- Harware para Xbee

El radio NRF24L01 también demostró un alto potencial de optimización. Partiendo de una base de 1.76 días, las mejoras permitieron alcanzar un máximo histórico de 20 días (ADAPTIVE + CODEC con MP1584). Este fue el mejor rendimiento de todas las pruebas, logrando un consumo mínimo de solo 10.5 mAh en modo de reposo

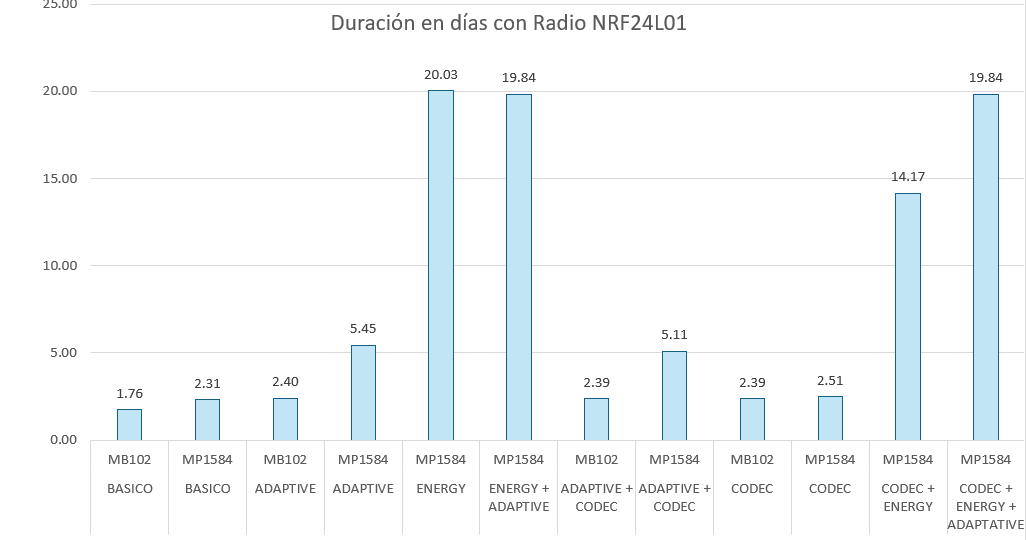
[picture p37: figure]

Ilustración 23. Duración en Días por Software- Harware para NRF2401L

La tecnología XBEE, si bien es robusta, demostró ser la de mayor consumo. A pesar de las optimizaciones, que lograron multiplicar la duración de 1.76 a 20 días, su consumo optimizado se mantuvo en 19.27 mAh en su modo bajo, significativamente más alto que las otras tecnologías.

El resultado más revelador es la comparación directa entre el peor y mejor caso de cada radio. Las gráficas a continuación resumen esta conclusión de forma contundente, mostrando que el factor dominante en la autonomía es el consumo en reposo.

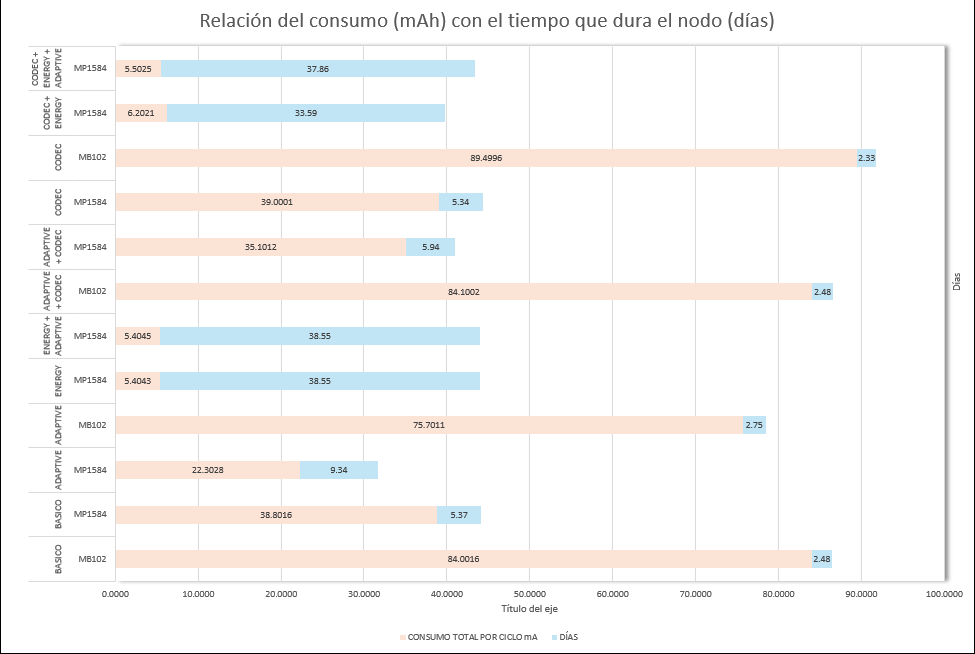
[picture p38: figure]

Ilustración 24. Relación del consumo (mAh) con el tiempo que dura el nodo (días)

Al comparar los resultados óptimos de cada tecnología, el radio Lora emerge como la solución con más autonomía energética implementando las mejoras de hardware y software que desarrollamos esto debido a que su modo de bajo consumo es más óptimo, claro que los demás radios también son buenas opciones y elecciones. Esto subraya la importancia de elegir el componente adecuado para la aplicación específica.

Este escenario optimizado, con una autonomía calculada de más de 38 días en el mejor de los casos, representa nuestra estimación teórica ideal. Es importante poner este número en contexto, ya que estos cálculos toman en cuenta los inevitables consumos parásitos del hardware, como los LEDs indicadores, que se analizarán a continuación. Además, la eficiencia energética es solo la mitad de la ecuación. Un nodo sensor puede durar meses, pero si no entrega sus mensajes de forma fiable, el sistema fracasa. Por lo tanto, la robustez de la comunicación será evaluada en la siguiente sección. Sin embargo, es fundamental recalcar que las mejoras de autonomía logradas son altamente satisfactorias, especialmente considerando el contexto de un presupuesto ajustado.

Los resultados demuestran que una optimización inteligente del software (como el sleep mode y el codec) y la selección de hardware de bajo costo (como el regulador MP1584) pueden generar un impacto drástico. El haber alcanzado una autonomía teórica de más de 38 días en el mejor de los casos, partiendo de una base de apenas 2 o 3 días, valida la metodología de este proyecto y confirma su gran potencial a futuro.

# Conclusiones

Al finalizar el desarrollo y las pruebas exhaustivas de este proyecto, podemos afirmar que las estrategias de optimización implementadas, tanto a nivel de software como de hardware, resultaron ser totalmente óptimas para el objetivo de incrementar la autonomía de los nodos sensores. Los resultados obtenidos validan nuestra hipótesis inicial de que una sinergia entre el control inteligente y los componentes adecuados es la clave para la eficiencia energética, permitiéndonos pasar de prototipos que apenas sobrevivían unos días a lograr una autonomía máxima calculada de 38 días con la configuración más eficiente.

En el apartado de software, logramos un avance importante con la creación de la herramienta UniversalRadioWSN. Esta estructura modular y escalable nos permitió desacoplar la lógica del negocio del hardware de comunicación, facilitando la integración de nuevas tecnologías sin reescribir el código base. Sobre esta base, el desarrollo de la librería CodecWSN demostró ser una herramienta valiosa; si bien por sí sola no reduce el consumo instantáneo, su capacidad para compactar la información en tramas binarias redujo enormemente el tiempo de trabajo del radio. Esto, sumado a la implementación de la librería EnergyWSN, fue lo que marcó la diferencia más drástica, logramos validar que el consumo en estado bajo disminuyó en varios órdenes de magnitud, confirmando que la estrategia de gestión de los modos de sueño del microcontrolador es indispensable. A esto se suma la inteligencia dotada por la librería AdaptiveTXWSN, que permite al nodo autoprotegerse ajustando sus transmisiones según el nivel de batería, maximizando su vida útil en situaciones críticas.

Un hallazgo crucial surgió del análisis comparativo entre tecnologías de radio. Aunque inicialmente el módulo XBee presentaba un consumo competitivo en modo activo, fue la tecnología LoRa la que, al combinarse con nuestras librerías de optimización y el modo de sueño profundo, demostró ser la opción superior. Fue precisamente con el módulo LoRa con el que alcanzamos el pico de eficiencia de 38 días de autonomía, validándolo como el hardware definitivo para este tipo de aplicaciones de larga distancia y bajo consumo.

En cuanto al hardware, las modificaciones realizadas fueron acertadas. La estrategia de cortar el suministro eléctrico a los sensores mediante un MOSFET demostró ser la técnica adecuada para eliminar consumos innecesarios durante los periodos de inactividad. Asimismo, la sustitución del regulador lineal por un regulador conmutado tipo step-down fue una decisión perfecta, mejorando la eficiencia de conversión de energía de manera significativa y reduciendo el desperdicio térmico.

Adicionalmente, la integración de los paneles solares arrojó resultados prometedores. Las pruebas confirmaron que estos dispositivos son capaces de recargar las baterías de manera efectiva, otorgando una autonomía teórica indefinida bajo condiciones de luz adecuadas. En particular, el panel de Pv-lr-35 demostró un rendimiento superior, siendo capaz de recuperar la carga consumida durante la noche y mantener el sistema operativo de forma sostenida incluso en situaciones de poca iluminación.

Sin embargo, a pesar de que vamos por un camino correcto en cuanto a diseño y lógica, nos topamos con una barrera física: los parásitos de consumo. Identificamos que componentes auxiliares, como los reguladores de voltaje secundarios y los LEDs integrados en los módulos comerciales, generan un consumo base que limita el potencial máximo de nuestro sistema. Aunque nuestras mejoras mitigaron su impacto, la eliminación total de estos parásitos requiere de componentes de gama industrial y un mayor presupuesto, lo cual queda fuera del alcance de este prototipo, pero marca el punto de partida para futuras iteraciones que lleven a un prototipo final.

A su vez, las pruebas de confianza, cuyos datos se encuentran en los anexos, demostraron que estas optimizaciones energéticas no comprometieron la fiabilidad del sistema. Mantuvimos tasas de recepción de paquetes sumamente altas, lo que concluye que es posible tener un sistema extremadamente eficiente sin sacrificar la integridad de los datos.

# Competencias desarrolladas

Competencias desarrolladas:

Fundamentos de Programación:

- Conoce el modelo de las 6’D para la solución de problemas reales.
- Conoce y aplica las estructuras de control para construir soluciones a problemas del entorno.

Programación Orientada a Objetos:

- Comprende y aplica los conceptos del paradigma de programación orientada a objetos para modelar situaciones de la vida real.
- Aplica los conceptos de clases y objetos en el desarrollo de programas para solución de problemas de acuerdo al paradigma orientado a objetos.
- Identifica y aplica relaciones de herencia en clases derivadas para reutilizar los miembros de una clase base en el desarrollo de aplicaciones.
- Aplica el concepto de polimorfismo para la definición de clases abstractas e interfaces que permitan reutilización de código.

Estructura de Datos:

- Conoce y comprende las diferentes estructuras de datos, su clasificación y forma de manipularlas para buscar la manera más eficiente de resolver problemas.
- Comprende y aplica estructuras de datos lineales para solución de problemas.

Principios Eléctricos y Aplicaciones Digitales:

- Soluciona problemas que engloben escenarios de circuitos eléctricos para calcular parámetros en base a leyes y teoremas.
- identifica las características de los dispositivos electrónicos utilizando hoja de especificaciones.
- Simula circuitos analógicos para su comprensión, demostrando los conceptos vistos en clase.
- Aplica técnicas de simplificación para construir circuitos con el mínimo costo.

Sistemas Programables:

- Aplica principios físicos y comprende transductores y sensores.
- Ensambla los circuitos respectivos empleando sensores y actuadores.
- Analiza dispositivos de entrada/salida y puertos del microcontrolador.
- Construye y comprueba circuitos con microcontrolador.
- Programa microcontroladores utilizando puertos de E/S.

# Recomendaciones

Basado en los hallazgos y las limitaciones encontradas durante el desarrollo de este proyecto, se presentan las siguientes recomendaciones técnicas y estratégicas para dar continuidad a esta línea de investigación y llevar el prototipo a un nivel de producto final desplegable.

La recomendación más crítica es la migración del hardware. Se sugiere encarecidamente abandonar el uso de módulos de desarrollo comerciales interconectados mediante cables (como el Arduino Nano y los sensores en breakout boards) y proceder al diseño de una placa de circuito impreso (PCB) personalizada. Esta transición es fundamental para eliminar físicamente los parásitos de consumo detectados en nuestros análisis, específicamente los LEDs de estado que no pueden apagarse y los reguladores de voltaje lineales ineficientes que desperdician energía constantemente. Al integrar los microcontroladores y sensores directamente en una PCB, se tendrá control absoluto sobre cada microamperio que circula por el circuito.

En relación con la fuente de alimentación, es imperativo sustituir los componentes actuales por reguladores de voltaje de ultra bajo consumo. Se sugiere invertir en convertidores DC-DC con corrientes de reposo (quiescent current) en el rango de los nanoamperios, en lugar de los miliamperios que consumen los modelos actuales como el AMS1117 o el MP1584. Aunque estos componentes especializados representan un costo inicial mayor, son la única vía para desbloquear autonomías de meses o incluso años y aprovechar al máximo las optimizaciones de software que ya hemos desarrollado.

Respecto al software, se recomienda mantener y expandir la arquitectura modular basada en la interfaz UniversalRadioWSN. Para futuras iteraciones, sería ideal implementar mecanismos de confirmación y retransmisión automática (ACK y Retries) directamente dentro de la librería CodecWSN. Dado que hemos logrado reducir el tiempo de uso del canal gracias al formato binario, tenemos margen para añadir estas capas de robustez sin sacrificar significativamente la batería, mejorando la fiabilidad en entornos con alto ruido electromagnético.

Finalmente, para la implementación de energía renovable, se sugiere evolucionar del módulo de carga básico UPS18650 a un sistema de gestión de batería (BMS) más sofisticado. Este nuevo sistema debería no solo encargar de la carga, sino también monitorear la salud y la temperatura de las celdas, optimizando los ciclos de carga según la disponibilidad solar real que ofrece el panel fotovoltaico, asegurando así que la vida útil de la batería acompañe la longevidad del nodo sensor.

# Referencias

Gordillo Gordillo, C. A. (2022). Red de sensores inalámbricos bajo protocolo lora y gestión de procesos para la analítica de datos mediante meta sistema operativo para monitoreo ambiental en invernaderos [Tesis de pregrado, Universidad Técnica del Norte]. Recuperado de https://repositorio.utn.edu.ec/handle/123456789/11887

Padilla, R., Quintero-Rosas, V., & Díaz-Ramírez, A. (2015). Monitoreo y localización depersonas extraviadas utilizando Arduino y GSM/GPS. Industrial Data, 18(1), 128-134.

Luis, R. A. J., & Luis, R. A. J. (2019). Diseño, desarrollo e implementación de una red de sensores inalámbricos (WSN) para el control, monitoreo y toma de decisiones aplicado en la agricultura de precisión basado en internet de las cosas (IOT). – Caso de estudio cultivo de frijol. https://hdl.handle.net/20.500.14138/2294

Al-Janabi, T. A., & Al-Raweshidy, H. S. (2019). An Energy Efficient Hybrid MAC Protocol With Dynamic Sleep-Based Scheduling for High Density IoT Networks. IEEE Internet of Things Journal, 6(2), 2273–2287. https://doi.org/10.1109/JIOT.2019.2905952

Barker, A., & Swany, M. (2020). Energy Aware Routing with Computational Offloading for Wireless Sensor Networks.

Calvo-Fullana, M., Matamoros, J., & Antón-Haro, C. (2016). Sensor Selection and Power Allocation Strategies for Energy Harvesting Wireless Sensor Networks. IEEE Journal on Selected Areas in Communications, 34(12), 3685–3695. https://doi.org/10.1109/JSAC.2016.2611859

Guo, W., & Healy, W. M. (2014a). Power Supply Issues in Battery Reliant Wireless Sensor Networks: A Review. INTERNATIONAL JOURNAL OF INTELLIGENT CONTROL AND SYSTEMS, 19(1), 15–23. https://www.ezconf.net/newfiles/IJICS/261/3-final-BatteryReview%202-18-2014-typed(1).pdf

Guo, W., & Healy, W. M. (2014b). Power Supply Issues in Battery Reliant Wireless Sensor Networks: A Review. INTERNATIONAL JOURNAL OF INTELLIGENT CONTROL AND SYSTEMS, 19(1).

Lajara José. (2014). Lajara - Modelado y optimización de energía en redes de sensores inalámbricas para la medida de p...

Mishra, M., Sen Gupta, G., & Gui, X. (2022). Investigation of Energy Cost of Data Compression Algorithms in WSN for IoT Applications. Sensors, 22(19). https://doi.org/10.3390/s22197685

Novelo Sansores, A. E. (2020a). IMPLEMENTACIÓN DE MEJORAS A UNA RED DE SENSORES BASADA EN ARDUINO Y XBEE.

Philco Asqui, L. O. (2023). CALIDAD DE SENSADO Y EFICIENCIA ENERGÉTICA EN REDES DE SENSORES INALÁMBRICOS (WSN) [Thesis, UNIVERSIDAD NACIONAL DE LA PLATA]. https://sedici.unlp.edu.ar/handle/10915/162474

Rivera Lopez, M. M. (2020a). Diseño e implementación de una red de sensores auto-configurable utilizando transceptores NRF24L01 [Universidad Tecnológica de La Habana José Antonio Echeverría]. https://www.researchgate.net/profile/Mario-Rivera-Lopez/publication/345686677_Tesis_Mario_Manuel_Rivera_Lopez/links/5faac1c9a6fdcc331b92cf1e/Tesis-Mario-Manuel-River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

Rojas, A., & Milton, O. (2020). Simulación de redes de sensores inalámbricos: un modelo energético a nivel de nodo-sensor bajo las especificaciones ieee 802.15.4tm y zigbee [Pontificia Universidad Javeriana]. https://doi.org/10.11144/Javeriana.10554.12727

Romero Amondaray, L., Artigas Fuentes, F. J., Calderón, C. A., Romero Amondaray, L., Artigas Fuentes, F. J., & Calderón, C. A. (2002). Revista de ingeniería electrónica, automática y comunicaciones. Ingeniería Electrónica, Automática y Comunicaciones, 41(2), 39–50. http://scielo.sld.cu/scielo.php?script=sci_arttext&pid=S1815-59282020000200039&lng=es&nrm=iso&tlng=pt

Sadeq, A. S., Hassan, R., Sallehudin, H., Aman, A. H. M., & Ibrahim, A. H. (2022). Conceptual Framework for Future WSN-MAC Protocol to Achieve Energy Consumption Enhancement. Sensors, 22(6), 2129. https://doi.org/10.3390/s22062129

Samara, G., Hassan, M. A., & Al-Okour, M. (2022). Energy Balancing Algorithm for Wireless Sensor Network.

Sedighimanesh, A., Sedighimanesh, M., & Baqeri, J. (2016). Cutting down energy usage in wireless sensor networks using Duty Cycle technique and multi-hop routing. International Journal of Wireless & Mobile Networks., 8(4), 23–41. https://doi.org/10.5121/ijwmn.2016.8402

Tapias Baena, J. E. (2021). Análisis Del Estado Del Arte Del Internet De Las Cosas Aplicado A Cultivos Aeropónicos E Hidropónicos A Nivel Nacional E Internacional Universidad Nacional Abierta Y A Distancia Unad Escuela De Ciencias Básicas Tecnología E Ingeniería Ibagué 2021 [Universidad Nacional Abierta Y A Distancia]. https://core.ac.uk/download/pdf/489432189.pdf

van Dam, T., & Langendoen, K. (2003). An adaptive energy-efficient MAC protocol for wireless sensor networks. Proceedings of the 1st international conference on Embedded networked sensor systems, 171–180. https://doi.org/10.1145/958491.958512

Vera Pico, L. A., Cruz Felipe, M. del R., & Álava, J. P. (2022). Análisis mediante simulación de la tecnología LoRa en WSN para la obtención de fuentes renovables de energía. 15(2), 153–163. https://dialnet.unirioja.es/servlet/articulo?codigo=8590669

Wei Chen, Andreopoulos, Y., Wassell, I. J., & Rodrigues, M. R. D. (2013). Towards energy neutrality in energy harvesting wireless sensor networks: A case for distributed compressive sensing? 2013 IEEE Global Communications Conference (GLOBECOM), 474–479. https://doi.org/10.1109/GLOCOM.2013.6831116

Wei Ye, Heidemann, J., & Estrin, D. (2002). An energy-efficient MAC protocol for wireless sensor networks. Proceedings.Twenty-First Annual Joint Conference of the IEEE Computer and Communications Societies, 1567–1576. https://doi.org/10.1109/INFCOM.2002.1019408

Yu, X., Zheng, H., Lu, Y., Si, J., Shen, R., Yan, Y., Hao, Z., & Lin, S. (2020). Wind Driven Semiconductor Electricity Generator With High Direct Current Output Based On a Dynamic Schottky Junction.

Zamora, P. (2017). Redes de sensores inalámbricas para el monitoreo del consumo energético empleando servicios en redes Ad-Hoc e IoT.

Zungeru, A. M., Ang, L.-M., Prabaharan, S. R. S., & Seng, K. P. (2012). Radio Frequency Energy Harvesting and Management for Wireless Sensor Networks. https://doi.org/10.1201/b10081-16
