FranciscoRos/SolucionesEnergeticasParaWSN/Speech.docx

PRESENTACION

Buenos días a todos, mi nombre es Francisco Rosales y este es mi compañero Omar Tox, les venimos a presentar nuestro proyecto Soluciones energéticas para redes de sensores: eficiencia y sustentabilidad

CONTEXTO Y PLANTEAMIENTO DEL PROBLEMA

Para comenzar, tenemos que entender qué es una Red de Sensores Inalámbricos (WSN). Básicamente, son conjuntos de dispositivos autónomos que monitorean variables en lugares remotos, como el oxígeno en el aire en una cueva o la humedad en cultivos, para poder monitorearlos o estudiarlos. El problema crítico es que funcionan con baterías, cuando la batería se agota, el nodo muere, se pierden datos y el costo de ir a reemplazarla es muy alto. Nuestro proyecto nace de esa necesidad: ¿Cómo hacemos que duren más?

JUSTIFICACION

Es importante este proyecto porque sirve para los proyectos que se realizan en el CITQROO que es donde realizamos nuestra residencia, como ejemplo tenemos este que hace unos años había un criadero de tilapias aquí en el itch y se monitoreó con una red de sensores, sin embargo las baterías duraban muy poco y por ello no se pudo seguir llevando a cabo, consideramos que el aprovechar la sinergia del hardware con el software junto con energías renovables aumentará la autonomía delos nosod y hará que más proyectos pasen a la industria

OBJETIVOS

por ello, nuestro objetivo general fue optimizar el consumo energético mediante código, protocolos de bajo consumo y fuentes renovables

Para lograrlo, nos planteamos 3 objetivos específicos:

Evaluar el consumo energético actual

Desarrollar algoritmos de gestión energética, optimizando los modos de descanso y la transmisión de datos en sinergia con el hardware

Evaluar el uso de paneles solares para lograr autonomía energética

ANTECEDENTES

Anteriormente, en 2016 Sediguimanesh y compañía, simularon un esquema en el que los nodos solo despiertan en intervalos específicos para enviar datos y duermen el resto del tiempo

A su vez, en 2022 Mishra propuso Técnicas de comprensión de datos porque mientras mas corto sea el mensaje enviado, menos tiempo está encendido el radio y el nodo consume menos energía ya que el radio es el componente de mayor consumo

MARCO TEORICO

Anteriormente Zamora diseño un sistema de monitoreo eléctrico para comprobar el estado de maquinaria en una empresa, nosotros realizamos las mejoras sobre este, sin embargo, nuestro proyecto es general y sirve para cualquier red de sensores basada en Arduino

Utilizamos diferentes radios para comunicación como Lora, xbee y nrf con capacidades y ventajas diferentes

En base a nuestros antecedentes nosotros trabajamos generando herramientas de compresión de datos y ciclo de trabajo

ACTIVIDADES

DIAP 1

Entrando en lo que hicimos, atacamos primero el hardware

Para comenzar, Migramos nuestros microcontroladores, de Arduino UNO a Arduino Nano, para reducir el consumo energético

En cuanto a la regulación energética, reemplazamos los reguladores lineales MB102 que desperdician energía en forma de calor, por reguladores conmutados MP1584, que tienen una eficiencia superior al 90% para evitar desperdiciar energía.

También Implementamos un circuito con MOSFETs que nos permite 'cortar' físicamente la corriente de los sensores cuando no están midiendo.

En este caso un MOSFET es un componente que usamos como un interruptor electrónico, estos consumen muy poca energía para trabajar y se desgastan mucho menos que otros componentes con usos similares

DIAP 2

estábamos trabajando con diferentes radios

Y como cada radio necesita diferente configuración pero tienen las mismas funciones optamos por crear una herramienta de abstracción de radios, para simplificar la llamada a sus funcionalidades que todos tienen como el inicializar, dormir, enviar y leer generando así código más limpio y escalable

DIAP 3

Para mejorar el consumo Energético mediante software creamos 3 librerías diferentes para atacar diversos problemas de forma limpia

Creamos Codec para comprimir el tamaño del paquete

Adaptive para ajustar los ciclos de envío según el nivel de batería del sistema

A su vez creamos EnergyWSN que gestiona el corte de energía de los periféricos y gestiona la hibernación del microprocesador y la radio

DIAP3

Para la integración de fuentes renovables realizamos pruebas entre paneles PV-RI-35 Y CNC16X13 para evaluar su desempeño bajo diferentes condiciones tales como la demanda máxima de consumo del sistema, estados de obstrucción parcial de la luz y el estado máximo de generación del panel

RESULTADOS

DIAP 1

Como Pueden apreciar en este vídeo nuestros nodos se comunican a distancia Y logramos la interoperabilidad comunicando el nodo sensor con el coordinador además de que logramos validar la recepción del mensaje completo en tiempo real

DIAP2

Aquí podemos ver las fotos de nuestros nodos cada uno con diferente radio, como son xbee, lora, y nrf,como pueden ver, todos estos usaban el mismo código de configuración utilizando nuestra herramienta UniversalRadioWSN de esta manera solo cambiamos una línea para prepararlo para diferente hardware

DIAP 3

Librería UniversalRadioWSN, como resultado tenemos la librería universal radio que es genérica para los módulos de radio que ya mencionamos y esta a su vez es extensible Y se puede crecer para implementar otro tipo de radios

DIAP4

Tenemos la librería codec que se creó para poder contactar los datos a un formato binario con lo cual el tamaño del mensaje que se envía comparado a prototipos básicos se ve reducido hasta el 70% lo que reducen mucho el tiempo de transmisión y por lo tanto reduce el consumo de energía, A su vez dentro de esta misma librería implementamos algoritmos de verificación del mensaje para saber si nuestro mensaje se vio corrompido durante el envío o si le faltan partes para evitar sesgo.

DIAP5

También tenemos nuestra librería EnergyWSN, La cual se encarga de gestionar las órdenes de encendido o apagado dadas por el programa haciendo que tanto el microprocesador como la radio en tener un modo de sueño profundo y corten la energía a La línea de sensores para evitar que estos tengan corrientes parásitos

DIAP6

Dado que todas Estas son herramientas que su función es poder aplicarse fácilmente a otros proyectos nosotros pedimos la iniciativa de hacerlos públicos a través del IDE oficial de Arduino, Con lo cual nos aseguramos de poder llegar a más personas que requieran optimización energética en sus redes de sensores

METODOLOGIA

Para la evaluación del resultado de estas mejores al sistema, Realizamos mediciones del consumo de corriente de todos nuestros modos probando las diferentes estrategias de software y los diferentes hardware y radios con el objetivo de evaluar qué tanto mejoró el consumo tanto en modo de reposo así como el modo de trabajo y obtener la autonomía estimada de cada una de las variantes

Como podemos ver en esta gráfica ,en el nodo más básico que era el nodo base utilizando la radio LoRa, obteníamos 2 días y medio de autonomía y el mejor resultado que obtuvimos nos da 38 días de autonomía aplicando todas nuestras mejoras tanto de hardware como de software

A su vez en esta diapositiva pueden ver un análisis en el que comparamos la reducción del tiempo de trabajo de El nodo basado en hora aplicando la librería codec que hace que la radio trabaje menos tiempo, Como se puede apreciar obtuvimos 50% menos de tiempo de trabajo usando la radio LoRa y en los otros una reducción de más del 70%. Lo que nos confirma que la reducción del tamaño del paquete a enviar, realmente es muy importante para reducir el consumo y aumentar la autonomía energética

CONCLUSIÓN

La realización de estas herramientas servirán de guía y apoyo a que más proyectos tanto del Centro de Innovación, como en general pasen de la fase de prototipado, ya que se crearon con una metodología que apunta a que sean fáciles de implementar, reutilizables y escalables.

Como pudimos ver, estas herramientas de código en colaboración con el hardware más eficiente como el regulador MP1584 y el MOSFET realmente redujeron el consumo energético de los nodos. De igual manera, corroboramos que el uso de paneles, como el PV-Rl-35, logró alimentar eficientemente los diferentes nodos incluso en situaciones de poca iluminación promoviendo una autonomía indefinida a pesar de las condiciones climáticas

RECOMENDACIONES

Para el trabajo futuro nosotros recomendamos el reemplazo del reguladores sensores que nosotros utilizamos de bajo de costo por unos componentes procrecionales los cuales son más durables y eficientes energéticamente,

A su vez se puede mejorar el que la librería adapteive no solo reaccione al voltaje de la batería sino también a la energía que está disponible por el panel solar es decir que en días nublados transmita menos y en días soleados transmita más

A su vez , para un proyecto específico que ya se vaya a implementar, se recomienda arduamente diseñar una placa de circuito impreso personalizada ya que es más estable además de que reduce el tamaño y se tiene un mayor control
