FranciscoRos/SolucionesEnergeticasParaWSN/Anexo_A_Datos_Consumo.xlsx

 |  |  |  |  | CONSUMO |  | TIEMPO DE TRABAJO |  |  |  | capacidad de la batería (mAh): | 5000
 | ID | SOFTWARE | HARDAWARE | RADIO | LOW (mAh) | HIGH | LOW | HIGH | CARGA EN DESCANSO (mA * Ms) | CONSUMO DE TRABAJO (mA * Ms) | CONSUMO TOTAL POR CICLO mA | HORAS QUE SOPORTARÍA | DÍAS
BASICO LoRa | 1 | BASICO | MB102 | LoRa | 84 | 100 | 900000 | 88 | 75600000 | 8800.0000 | 84.0016 | 59.5227 | 2.48
BASICO LoRa | 2 | BASICO | MP1584 | LoRa | 38.8 | 55.6 | 900000 | 88 | 34920000 | 4892.8000 | 38.8016 | 128.8605 | 5.37
ADAPTIVE LoRa | 3 | ADAPTIVE | MP1584 | LoRa | 22.3 | 59.5 | 900000 | 68.7 | 20070000 | 4087.6500 | 22.3028 | 224.1867 | 9.34
ADAPTIVE LoRa | 4 | ADAPTIVE | MB102 | LoRa | 75.7 | 89.8 | 900000 | 68.7 | 68130000 | 6169.2600 | 75.7011 | 66.0493 | 2.75
ENERGY LoRa | 5 | ENERGY | MP1584 | LoRa | 5.4 | 61.1 | 900000 | 68.9 | 4860000 | 4209.7900 | 5.4043 | 925.1954 | 38.55
ENERGY + ADAPTIVE LoRa | 6 | ENERGY + ADAPTIVE | MP1584 | LoRa | 5.4 | 61.9 | 900000 | 71.7 | 4860000 | 4438.2300 | 5.4045 | 925.1548 | 38.55
ADAPTIVE + CODEC LoRa | 7 | ADAPTIVE + CODEC | MB102 | LoRa | 84.1 | 88 | 900000 | 48.7 | 75690000 | 4285.6000 | 84.1002 | 59.4529 | 2.48
ADAPTIVE + CODEC LoRa | 8 | ADAPTIVE + CODEC | MP1584 | LoRa | 35.1 | 56.5 | 900000 | 48.7 | 31590000 | 2751.5500 | 35.1012 | 142.4454 | 5.94
CODEC LoRa | 9 | CODEC | MP1584 | LoRa | 39 | 40 | 900000 | 45.8 | 35100000 | 1832.0000 | 39.0001 | 128.2050 | 5.34
CODEC LoRa | 10 | CODEC | MB102 | LoRa | 89.5 | 81.5 | 900000 | 45.8 | 80550000 | 3732.7000 | 89.4996 | 55.8662 | 2.33
CODEC + ENERGY LoRa | 11 | CODEC + ENERGY | MP1584 | LoRa | 6.2 | 51.6 | 900000 | 42.3 | 5580000 | 2182.6800 | 6.2021 | 806.1742 | 33.59
CODEC + ENERGY + ADAPTIVE LoRa | 12 | CODEC + ENERGY + ADAPTIVE | MP1584 | LoRa | 5.5 | 54.4 | 900000 | 45.5 | 4950000 | 2475.2000 | 5.5025 | 908.6825 | 37.86
BASICO NRF24L01 | 13 | BASICO | MB102 | NRF24L01 | 118.6 | 131.4 | 900000 | 78 | 106740000 | 10249.2000 | 118.6011 | 42.1581 | 1.76
BASICO NRF24L01 | 14 | BASICO | MP1584 | NRF24L01 | 90 | 92.4 | 900000 | 78 | 81000000 | 7207.2000 | 90.0002 | 55.5554 | 2.31
ADAPTIVE NRF24L01 | 15 | ADAPTIVE | MB102 | NRF24L01 | 86.7 | 88.5 | 900000 | 23.15 | 78030000 | 2048.7750 | 86.7000 | 57.6701 | 2.40
ADAPTIVE NRF24L01 | 16 | ADAPTIVE | MP1584 | NRF24L01 | 38.2 | 41.6 | 900000 | 22.7 | 34380000 | 944.3200 | 38.2001 | 130.8898 | 5.45
ENERGY NRF24L01 | 17 | ENERGY | MP1584 | NRF24L01 | 10.4 | 15 | 900000 | 51.5 | 9360000 | 772.5000 | 10.4003 | 480.7571 | 20.03
ENERGY + ADAPTIVE NRF24L01 | 18 | ENERGY + ADAPTIVE | MP1584 | NRF24L01 | 10.5 | 43.1 | 900000 | 54.6 | 9450000 | 2353.2600 | 10.5020 | 476.1008 | 19.84
ADAPTIVE + CODEC NRF24L01 | 19 | ADAPTIVE + CODEC | MB102 | NRF24L01 | 87.3 | 88.8 | 900000 | 22.87 | 78570000 | 2030.8560 | 87.3000 | 57.2737 | 2.39
ADAPTIVE + CODEC NRF24L01 | 20 | ADAPTIVE + CODEC | MP1584 | NRF24L01 | 40.8 | 41.3 | 900000 | 22.61 | 36720000 | 933.7930 | 40.8000 | 122.5490 | 5.11
CODEC NRF24L01 | 21 | CODEC | MB102 | NRF24L01 | 87.3 | 87.5 | 900000 | 22.6 | 78570000 | 1977.5000 | 87.3000 | 57.2738 | 2.39
CODEC NRF24L01 | 22 | CODEC | MP1584 | NRF24L01 | 83.1 | 83.2 | 900000 | 22.6 | 74790000 | 1880.3200 | 83.1000 | 60.1685 | 2.51
CODEC + ENERGY NRF24L01 | 23 | CODEC + ENERGY | MP1584 | NRF24L01 | 14.7 | 38.6 | 900000 | 44.3 | 13230000 | 1709.9800 | 14.7012 | 340.1088 | 14.17
CODEC + ENERGY + ADAPTATIVE NRF24L01 | 24 | CODEC + ENERGY + ADAPTATIVE | MP1584 | NRF24L01 | 10.5 | 42.8 | 900000 | 44.2 | 9450000 | 1891.7600 | 10.5016 | 476.1186 | 19.84
BASICO XBEE | 25 | BASICO | MB102 | XBEE | 67.4 | 74.5 | 900000 | 90 | 60660000 | 6705.0000 | 67.4007 | 74.1832 | 3.09
BASICO XBEE | 26 | BASICO | MP1584 | XBEE | 20.3 | 34.6 | 900000 | 89 | 18270000 | 3079.4000 | 20.3014 | 246.2883 | 10.26
ADAPTIVE XBEE | 27 | ADAPTIVE | MB102 | XBEE | 74.7 | 79.6 | 900000 | 31.7 | 67230000 | 2523.3200 | 74.7002 | 66.9342 | 2.79
ADAPTIVE XBEE | 28 | ADAPTIVE | MP1584 | XBEE | 34.3 | 45.6 | 900000 | 33.2 | 30870000 | 1513.9200 | 34.3004 | 145.7708 | 6.07
ENERGY XBEE | 29 | ENERGY | MP1584 | XBEE | 15.9 | 25.9 | 900000 | 34.3 | 14310000 | 888.3700 | 15.9004 | 314.4579 | 13.10
ENERGY + ADAPTIVE XBEE | 30 | ENERGY + ADAPTIVE | MP1584 | XBEE | 13.2 | 24 | 900000 | 36 | 11880000 | 864.0000 | 13.2004 | 378.7755 | 15.78
ADAPTIVE + CODEC XBEE | 31 | ADAPTIVE + CODEC | MB102 | XBEE | 68.2 | 73.4 | 900000 | 21.6 | 61380000 | 1585.4400 | 68.2001 | 73.3136 | 3.05
ADAPTIVE + CODEC XBEE | 32 | ADAPTIVE + CODEC | MP1584 | XBEE | 21 | 31.1 | 900000 | 25.2 | 18900000 | 783.7200 | 21.0003 | 238.0920 | 9.92
CODEC XBEE | 33 | CODEC | MB102 | XBEE | 66.3 | 74.2 | 900000 | 18.7 | 59670000 | 1387.5400 | 66.3002 | 75.4146 | 3.14
CODEC XBEE | 34 | CODEC | MP1584 | XBEE | 20.4 | 45.4 | 900000 | 20.3 | 18360000 | 921.6200 | 20.4006 | 245.0913 | 10.21
CODEC + ENERGY XBEE | 35 | CODEC + ENERGY | MP1584 | XBEE | 19.8 | 30.2 | 900000 | 15 | 17820000 | 453.0000 | 19.8002 | 252.5230 | 10.52
CODEC + ENERGY + ADAPTATIVE XBEE | 36 | CODEC + ENERGY + ADAPTATIVE | MP1584 | XBEE | 19.27 | 29.5 | 900000 | 18.4 | 17343000 | 542.8000 | 19.2702 | 259.4679 | 10.81
