FranciscoRos/SolucionesEnergeticasParaWSN/(list of files, drawings)

Other design files:
Anexo_C_Prototipo_LoRa.fzz
Anexo_D_Prototipo_NRF.fzz
Anexo_E_Prototipo_Xbee.fzz
