FranciscoRos/SolucionesEnergeticasParaWSN/(commit log)

2025-10-09 codigos para resetear las eeprom
    [ResetEEpromESP32.ino, ResetEepromArduino.ino]
2025-10-13 codigo de voltaje adaptativo
2025-10-15 Completando la librería UniversalRadioWSN
2025-10-15 NRF24L01 con modos de bajo consumo
2025-10-15 agregando los diferentes modos de ahorro y eeprom de nrf24
2025-10-17 Librería genércia básica lista para lora y xbee
2025-10-20 añadiendo el eeprom a codec y basica
2025-10-22 cambios en el documento
2025-10-22 modificando sección de pruebas de Omar
2025-10-23 subiendo union de dos librwerías
2025-10-23 Listo librería COdec + energy juntas unificadas en un sketch Recordatorio: añadir el pin de reqsleep y de sleepstate físicamente en el xbee para evitar problemas
    [EmisorUniversalCodecEnergy.ino, ReceptorUniversalCodecEnergy.ino]
2025-10-27 Subiendo cambios de comentarios
2025-10-27 Pruebas a los códigos con comentarios limpios Solo probé los códigos luego de cambiar los comentarios para asegurarnos que no tronara nada, hice unos cuantos cambios a cada uno por problemas minúscul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
    [EmisorUniversalCodec.ino, EmisorUniversalCodecEnergyAdaptive.ino, EmisorUniversalEnergy.ino, EmisorUniversalEnergyAdaptive.ino, ReceptorUniversalCodec.ino, ReceptorUniversalEnergyAdaptive.ino]
2025-10-28 agregando los códigos para registrar la autionomía de los paneles solares
    [registro_solar.csv]
2025-10-28 Subiendo listos para repositorio
2025-10-29 subiendo carpetas para pruebas
2025-10-29 Añadiendo explicacion de las bibiliotetcas
2025-11-06 Tabla de pruebas de radio (Lora)
    [CUADRO DE PRUEBAS.xlsx]
2025-11-06 Pruebas de lora completas
    [CUADRO DE PRUEBAS.xlsx]
2025-11-06 Subiendo codigos de lora listos
2025-11-07 xbee (menos energy)
    [CUADRO DE PRUEBAS.xlsx]
2025-11-08 pruebas completadas (Xbee)
    [CUADRO DE PRUEBAS.xlsx]
2025-11-11 cuadro de pruebas
    [CUADRO DE PRUEBAS.xlsx, PRUEBAS DE CONFIANZA.xlsx]
2025-11-12 Subiendo cambios
    [CUADRO DE PRUEBAS.xlsx]
2025-11-12 subiendo cambios a las gráficas
    [CUADRO DE PRUEBAS.xlsx]
2025-11-13 Análisis listo y parásitos del consumo listos
    [Anexo_A_Datos_Consumo.xlsx, CUADRO DE PRUEBAS.xlsx]
2025-11-17 grafica de confianza
    [PRUEBAS DE CONFIANZA.xlsx]
2025-11-19 pruebas de confianza
    [PRUEBAS DE CONFIANZA.xlsx]
2025-11-20 Agregando las pruebas de confianza al informe
    [PRUEBAS DE CONFIANZA.xlsx]
2025-11-23 subiedno fritx
    [Nodo Xbee.fzz]
2025-11-23 Subiendo nodo xbee
    [Nodo Xbee.fzz]
2025-11-24 defincion de pruebas
    [PRUEBAS DE CONFIANZA.xlsx]
2025-11-24 Añadiendo modelos de prototipos realizados
    [Nodo LoRa.fzz, Nodo NRF.fzz]
2025-11-25 formato de residencia
2025-11-25 cambios al informe
    [Anexo_B_Datos_Confianza.xlsx, Anexo_C_Prototipo_LoRa.fzz, Anexo_D_Prototipo_NRF.fzz, Anexo_E_Prototipo_Xbee.fzz]
2025-12-16 Modificando el documento
